RRichard67/amulet_controller_kibot/Images/amulet_controller-angled_top.png

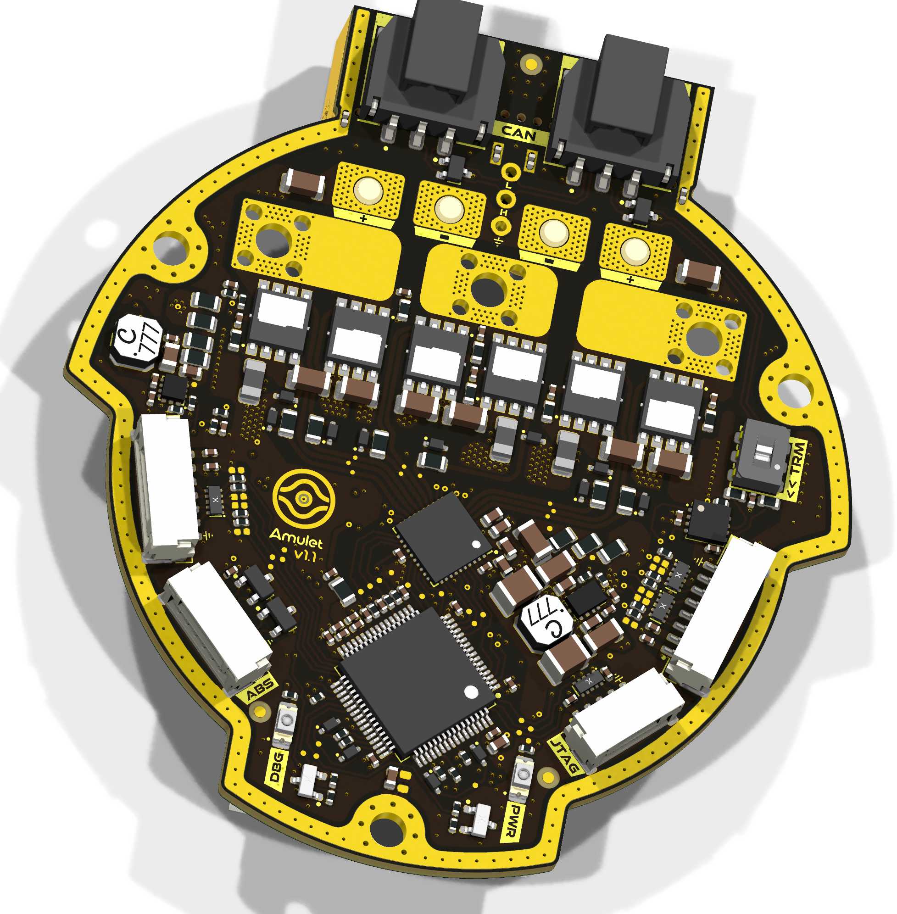
Images/amulet_controller-angled_top.png
