RRichard67/amulet_controller_kibot/Images/amulet_controller-bottom.png

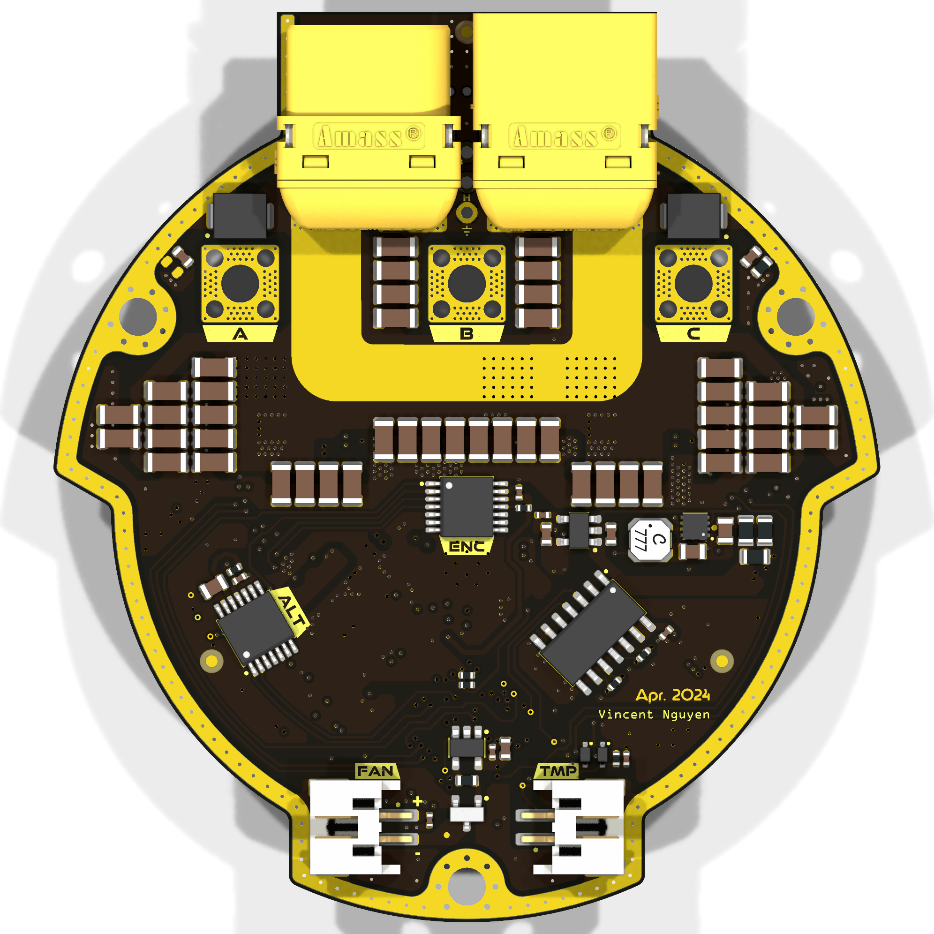
Images/amulet_controller-bottom.png
