RRichard67/amulet_controller_kibot/Reports/report_amulet_controller-erc.html

Logo

(https://github.com/INTI-CMNB/KiBot/) | ERC report for amulet_controller
| Schematic: amulet_controller Revision: 1.1.1+ (Unreleased) Date: 2026-08-17T11:32:27 KiCad Version: 10.0.5 | Errors: 0 Warnings: 3 Total: 3

Sheet / (amulet_controller.kicad_sch)

Type | Description | Details
lib_symbol_mismatch | Symbol 'Thermistor_NTC' doesn't match copy in library 'Device' | @(0.9779 mm, 0.8255 mm): Symbol TH1 [Thermistor_NTC]
lib_symbol_mismatch | Symbol 'LED' doesn't match copy in library 'Device' | @(1.4986 mm, 0.8128 mm): Symbol D12 [LED]
lib_symbol_mismatch | Symbol 'LED' doesn't match copy in library 'Device' | @(1.9812 mm, 0.8128 mm): Symbol D13 [LED]

Generated by KiBot (https://github.com/INTI-CMNB/KiBot/) v1.9.2
