RRichard67/amulet_controller_kibot/Schematic/amulet_controller-schematic-18.pdf

1 | 2 | 3 | 4 | 5 | 6 | 7 | 8

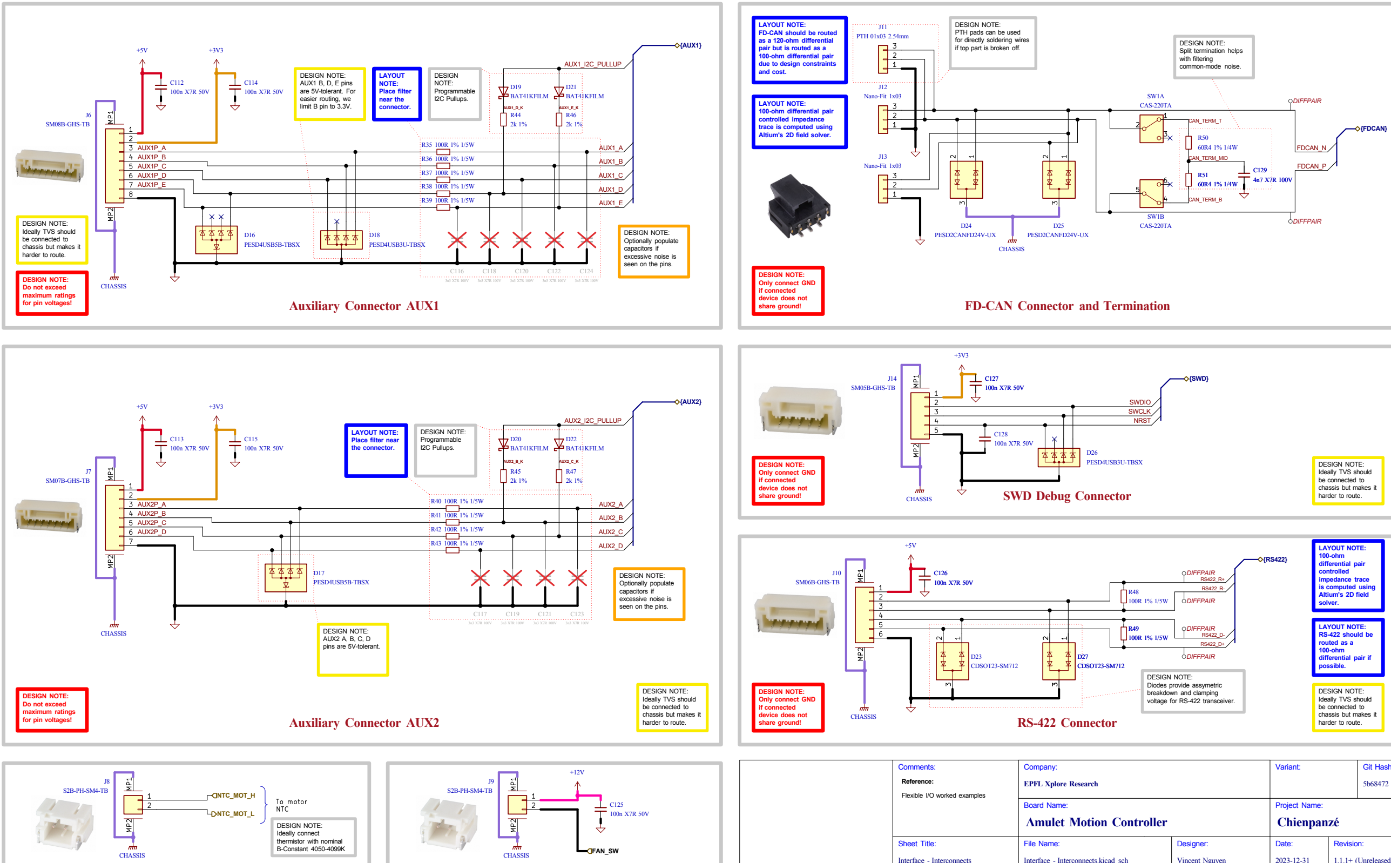
[picture p3: figure]
Sheet Title:; File Name:; D20 BAT41KFILM; 3n3 X7R 100V D22 BAT41KFILM; J6 SM08B-GHS-TB; D18 PESD4USB3U-TBSX; D19 BAT41KFILM; J12 Nano-Fit 1x03 1; J13 Nano-Fit 1x03 R44 2k 1%; D16 PESD4USB5B-TBSX; D21 BAT41KFILM; J11 PTH 01x03 2.54mm; J7 SM07B-GHS-TB; CHASSIS; 1 D24 PESD2CANFD24V-UX; 3 D27 CDSOT23-SM712; SW1A CAS-220TA; 1 D25 PESD2CANFD24V-UX; +3V3 CHASSIS; SW1B CAS-220TA; D17 PESD4USB5B-TBSX; 3 D23 CDSOT23-SM712 C126 100n X7R 50V; J14 SM05B-GHS-TB; D26 PESD4USB3U-TBSX; J10 SM06B-GHS-TB; DIFFPAIR; {FDCAN}; {SWD}; NTC_MOT_H; NTC_MOT_L; {AUX1}; FAN_SW; {AUX2} AUX2_B_K; AUX1_D; AUX2_C_K; FDCAN_P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
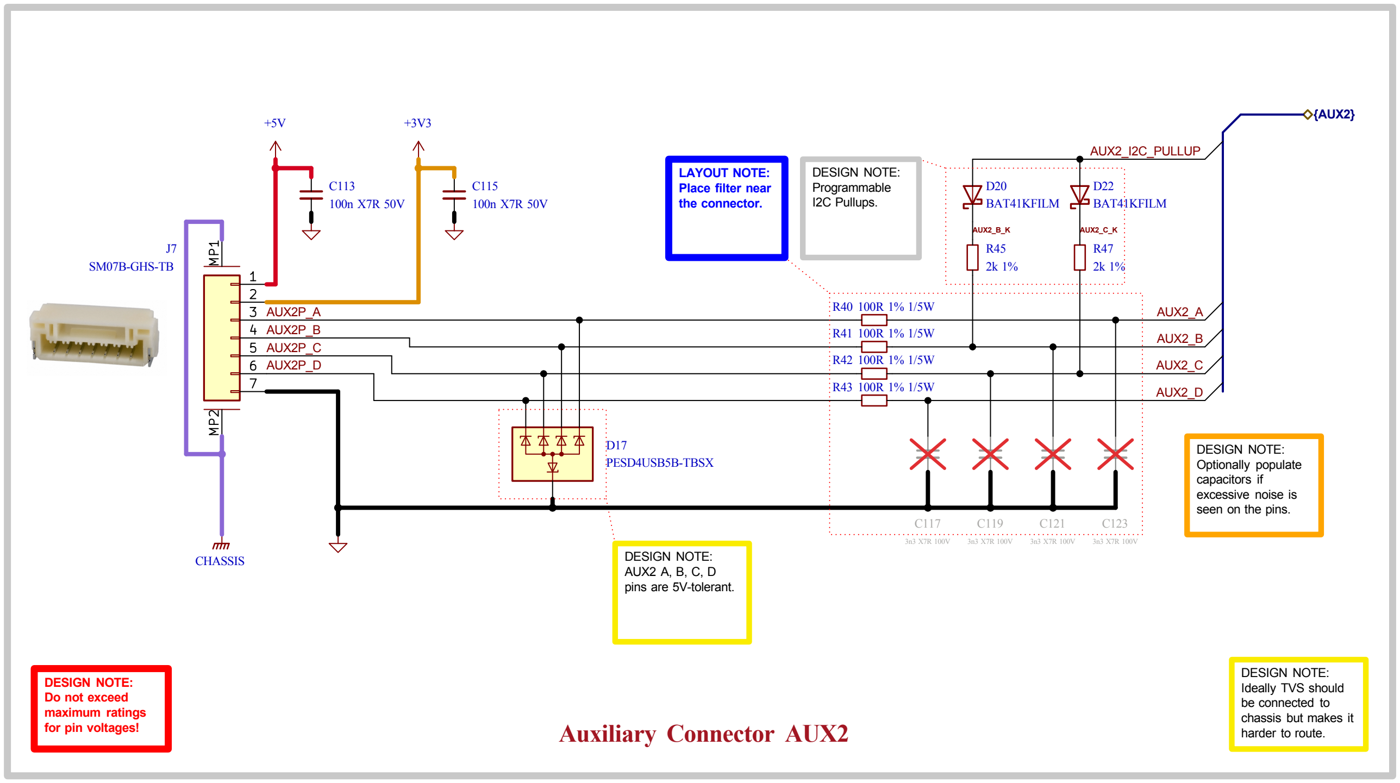
[picture p4: figure]
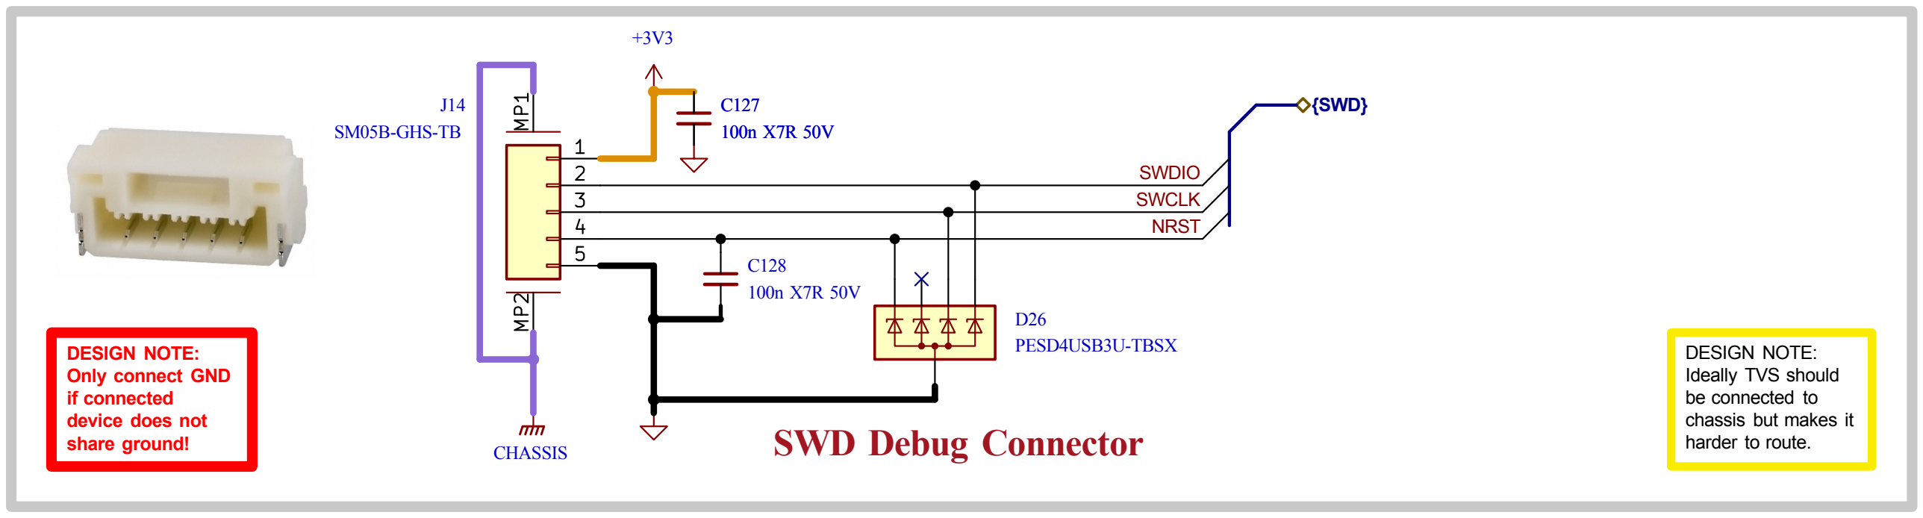
[picture p5: figure]

1 | 2 | 3 | 4 | 5 | 6 | 7 | 8

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
F 18

### Sheet: of 21 Size: A3

Revision: 1.1.1+ (Unreleased) Date: Project Name: 2023-12-31 Reviewer: Designer: Interface - Interconnects.kicad_sch | Vincent Nguyen Board Name: Company: | Variant: EPFL Xplore Research Λmulet Motion Controller | Chienpanzé
/Project Architecture/Interface - Interconnects/ Sheet Path: Interface - Interconnects Comments: | Git Hash: 5b68472 R42 100R 1% 1/5W

I2C Pullups. DESIGN NOTE: AUX1 B, D, E pins are 5V-tolerant. For easier routing, we
limit B pin to 3.3V. | LAYOUT NOTE: Place filter near the
connector. | FD-CAN Connector and Termination

DESIGN NOTE: Split termination helps with filtering

common-mode noise. DESIGN NOTE: Only connect GND

# device does not share ground! LAYOUT NOTE: 100-ohm differential pair controlled impedance

trace is computed using Altium's 2D field solver. | DESIGN NOTE: PTH pads can be used

if top part is broken off. DESIGN NOTE: Programmable

# 12V Fan Connector

differential pair if possible. DESIGN NOTE:

# chassis but makes it harder to route. LAYOUT NOTE: 100-ohm

solver. DESIGN NOTE: Diodes provide assymetric breakdown and clamping

voltage for RS-422 transceiver. DESIGN NOTE: Only connect GND chassis but makes it harder to route. DESIGN NOTE: Only connect GND

device does not share ground! DESIGN NOTE: Do not exceed maximum ratings

for pin voltages! | To motor NTC Motor Temperature Sensing Thermistor Connection

# [18] Interface - Interconnects

as a 120-ohm differential pair but is routed as a

100-ohm differential pair due to design constraints

DESIGN NOTE: Do not exceed maximum ratings

seen on the pins. LAYOUT NOTE: Place filter near

chassis but makes it harder to route. | DESIGN NOTE: Optionally populate

Flexible I/O worked examples (https://jpieper.com/2022/06/30/flexible-i-o-worked-examples/) Reference:C126
