RRichard67/amulet_controller_kibot/Schematic/amulet_controller-schematic-21.pdf

1 | 2 | 3 | 4 | 5 | 6
1 | 2 | 3 | 4 | 5 | 6

AB

C

D

AB

C

D 21

Sheet: of 21
Size: A4
Revision: 1.1.1+ (Unreleased) Date: Project Name: 2024-01-03 Reviewer: Designer: Revision History.kicad_sch | Vincent Nguyen Board Name: Company: | Variant: EPFL Xplore Research Λmulet Motion Controller | Chienpanzé
Sheet Title: | File Name:
/Revision History/ Sheet Path: Revision History Comments: | Git Hash: 5b68472

Version 1.0.0 - 2023-12-12 ___________________________________ Added

- TVS protection and termination switch to FD-CAN. - Low-side switched 12V 600 mA source for

external fan. - LDO for analog supply. - One TVS diode per power connector. - Second on-board I2C magnetic encoder for

disambiguation. - ESD protection to all interfaces. - Over-voltage protection on thermistor ADC

inputs. - Pi filters to inputs of buck regulators and

MCU analog supply. - Decoupling caps next to power pins of

connectors. ___________________________________ Changed

- CPH-CPL capacitor to 47 nF (gate driver). - FD-CAN transceiver IC. - FETs for top cooled variant. - Input power TVS diode to bidirectional. - Moved SOx low-pass filter to MCU section. - PWM_PHASEA with PWM_PHASEC on STM32G474 pinout for easier routing. - RS422 pinout on connector. - Buck regulators to optimize for low noise.

___________________________________ Added

- Controller target specifications. - Credits to moteus on cover page. - Optional RC-Snubber to power stage. ___________________________________ Fixed
- Chassis guard ring to go around the board. - CAN and power TVS diodes now go to

chassis. - Clearance between nets to respect

IEC60664-1 where possible. - Comment on precharge. - Power TVS diode reference designator

from "U" to "D". ___________________________________ Changed

- 5V 300 mA buck converter with 600 mA version. - Chassis-GND capacitor by 1nF 1kV.

Version 1.0.1 - 2024-01-25 ___________________________________ Changed

- Power sequencing graph according to
experimental data. | ___________________________________ Added
- RC snubber passive values. ___________________________________ Fixed
- More vias for VBUS and LMR36006 GND pads. - Board version voltage reference from +3V3

to +A3V3. ___________________________________ Changed

- Motor thermistor resistor divider to 2kOhm for a 10k 3950K thermistor.

# [21] Revision History

Version 1.0.2 - 2024-03-12

___________________________________ Fixed

- Replace non-stocked components.

Version 1.1.1 - 2025-01-18

Version 1.1.0 - 2024-04-13
