RRichard67/amulet_controller_kibot/Images/amulet_controller-top.png

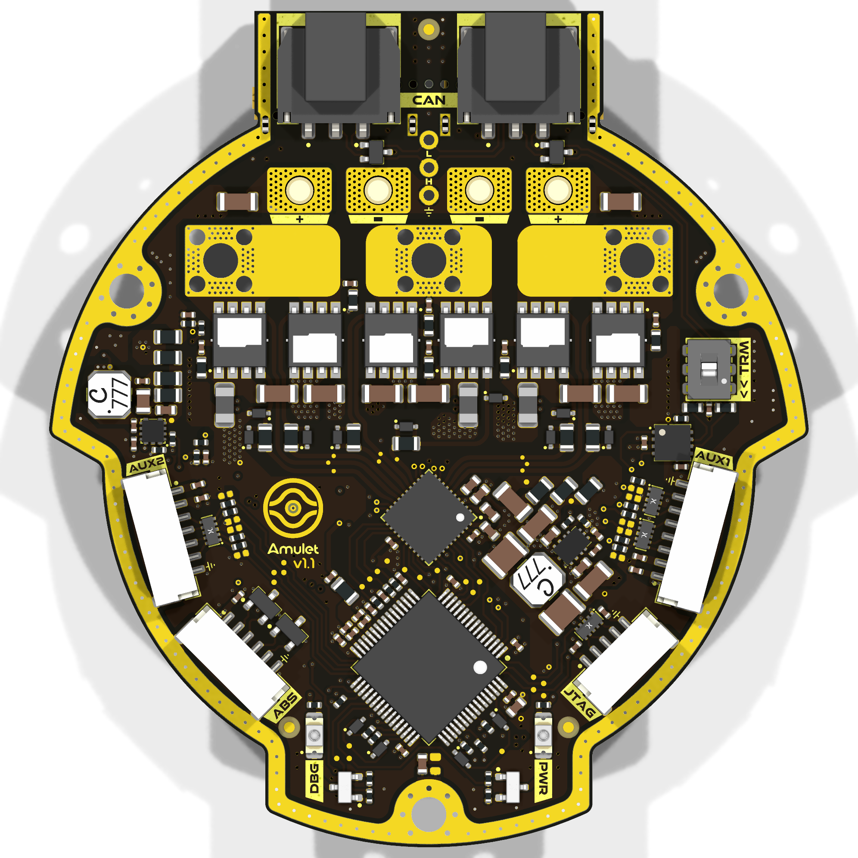
Images/amulet_controller-top.png
