RRichard67/amulet_controller_kibot/3D/amulet_controller.step

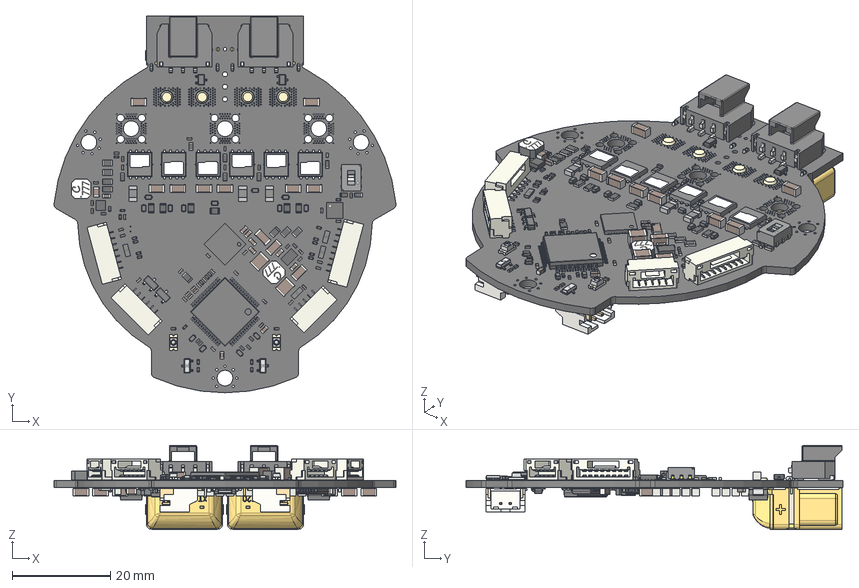
[picture p8: CAD file, 2026-08-17]
3D/amulet_controller.step
69.7 x 76.7 x 17.1 mm
C_1210_3225Metric x 2
C_0402_1005Metric x 45
TPW1R306PL,L1Q x 6
R_0402_1005Metric x 40
C_0603_1608Metric x 14
SOT23 lower body x 3
SOT23 Lead x 9
SOT23 Upper body x 3
R_0805_2012Metric x 17
VSON_8_33x33mm_Pitch065mm_NexFET
R_0603_1608Metric x 10
PCB x 29
lead x 30
SOT1176D LF x 4
SOT1176D Mold body x 4
1054301103 v4 x 2
SM1206XXC-IL x 2
C_1206_3216Metric x 57
HCS1206_L500 x 3
C_0805_2012Metric x 4
Leader x 128
BODY-QFN_AF0
PIN1-ID
JST_SM06B_GHS_TB
MOLD_AF0
JST_SM08B_GHS_TB
Coilcraft-LPS4018 x 2
JST_SM05B_GHS_TB
Thermal Shape x 2
JST_SM07B_GHS_TB
2 pole_s
CAS_c_22A
S3B-PH-SM4-TB v8 x 2
Lead x 4
Coilcraft-LPS3314
XT60____-8______-UL-21155
XT60____-8____-21158 x 2
XT60PW-F20____-8-UL
XT60____-8________ x 4
XT60____-8______-UL-21156
XT60____-8____-21157 x 2
XT60PW-M20____-8-UL
XT60-PW-F
kibot_5xyicq26_PCB
