RRichard67/amulet_controller_kibot/Manufacturing/Fabrication/Gerbers/amulet_controller-NPTH_drill_map.dxf

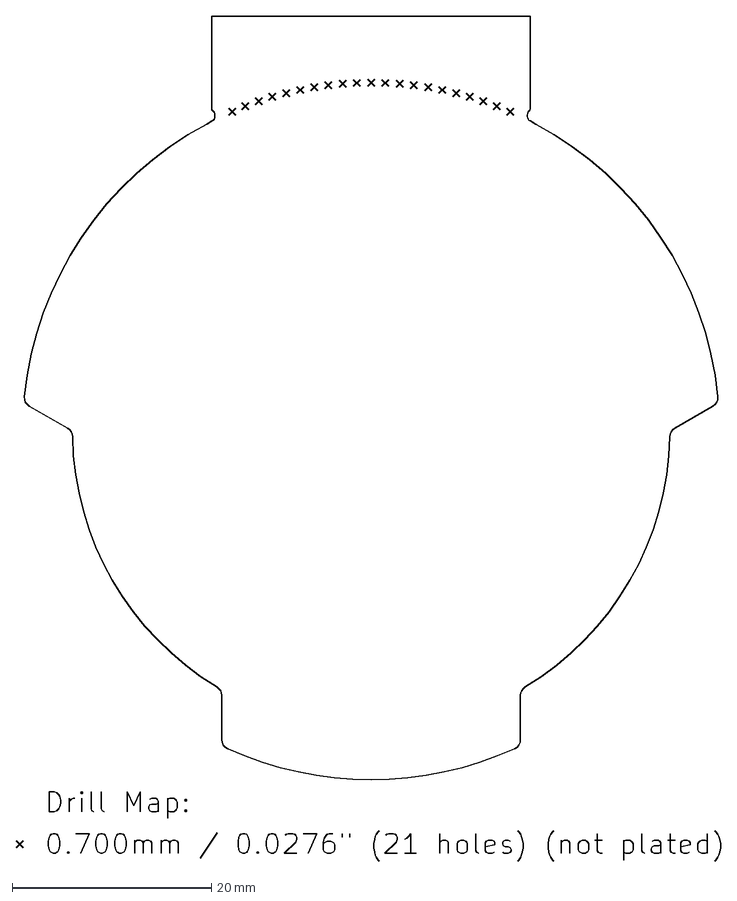
[picture p9: CAD file, 2026-08-17]
Manufacturing/Fabrication/Gerbers/amulet_controller-NPTH_drill_map.dxf
70.7 x 84.9 mm
