RRichard67/amulet_controller_kibot/Manufacturing/Fabrication/Gerbers/amulet_controller-PTH_drill_map.dxf

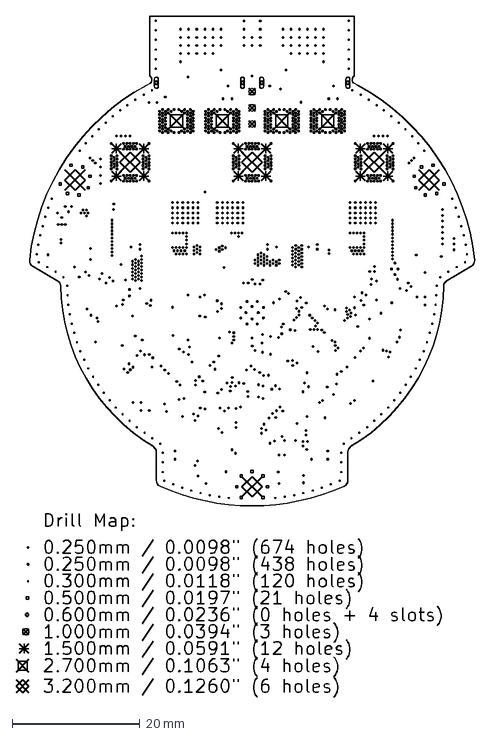
[picture p10: CAD file, 2026-08-17]
Manufacturing/Fabrication/Gerbers/amulet_controller-PTH_drill_map.dxf
71.8 x 106.6 mm
