RRichard67/amulet_controller_kibot/Manufacturing/Fabrication/amulet_controller-fabrication.pdf

# Top Fabrication (Scale 1:1)

# Λmulet Motion Controller Fabrication Document

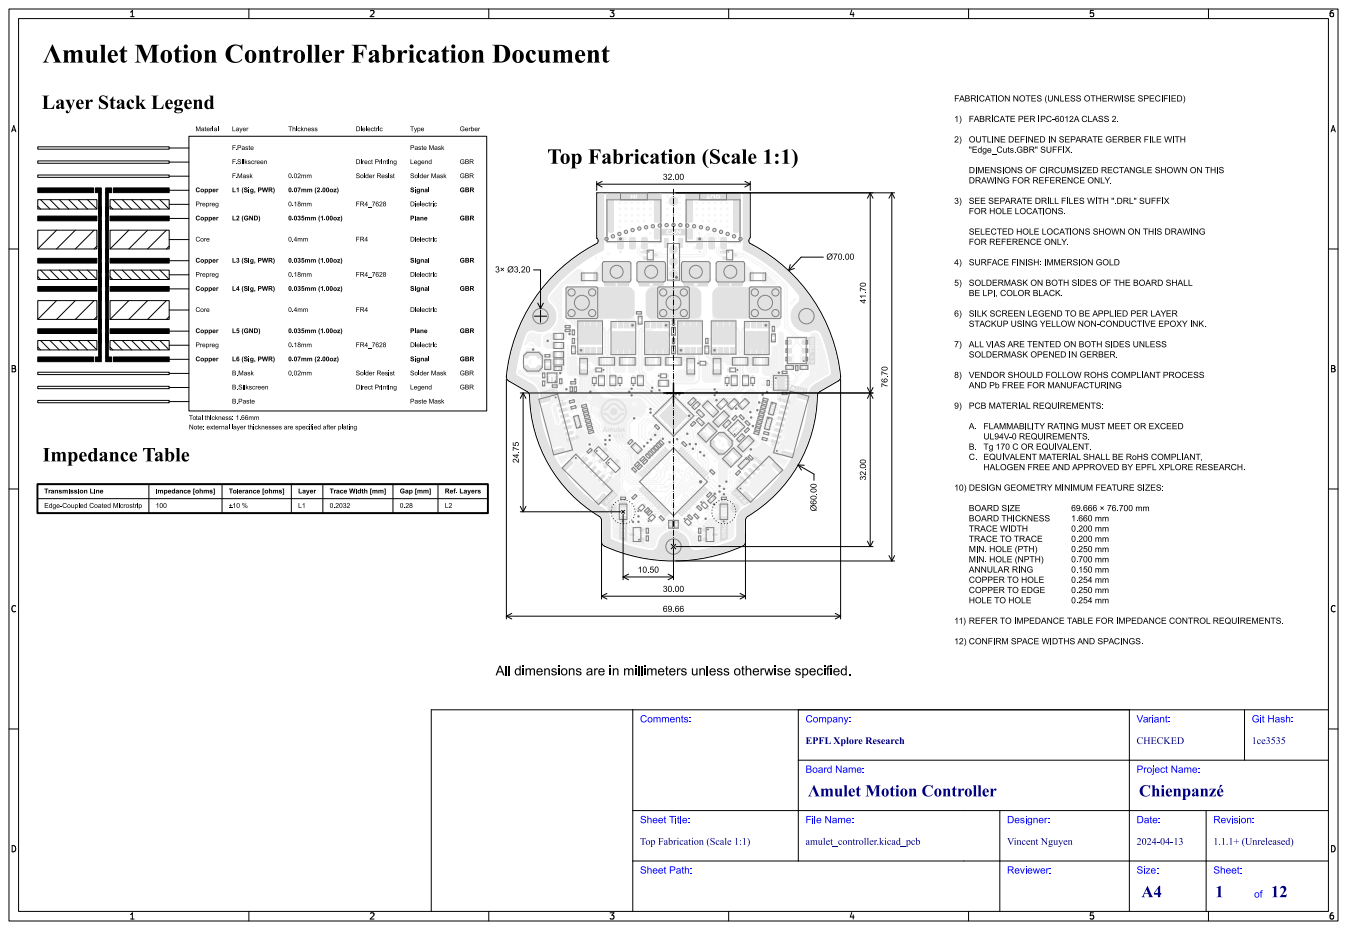
[picture p11: page 1]
Git Hash:; Comments:; Sheet Path:; Sheet Title:; File Name:; Λmulet Motion Controller; Chienpanzé; Company:; CHECKED; Variant:; Board Name:; amulet_controller.kicad_pcb; Vincent Nguyen; Designer:; Reviewer:; Project Name:; Date:; 1.1.1+ (Unreleased); Revision:; Size:; Sheet:

EPFL Xplore Research

Top Fabrication (Scale 1:1)

# Bottom Fabrication (Scale 1:1)

# Λmulet Motion Controller Fabrication Document

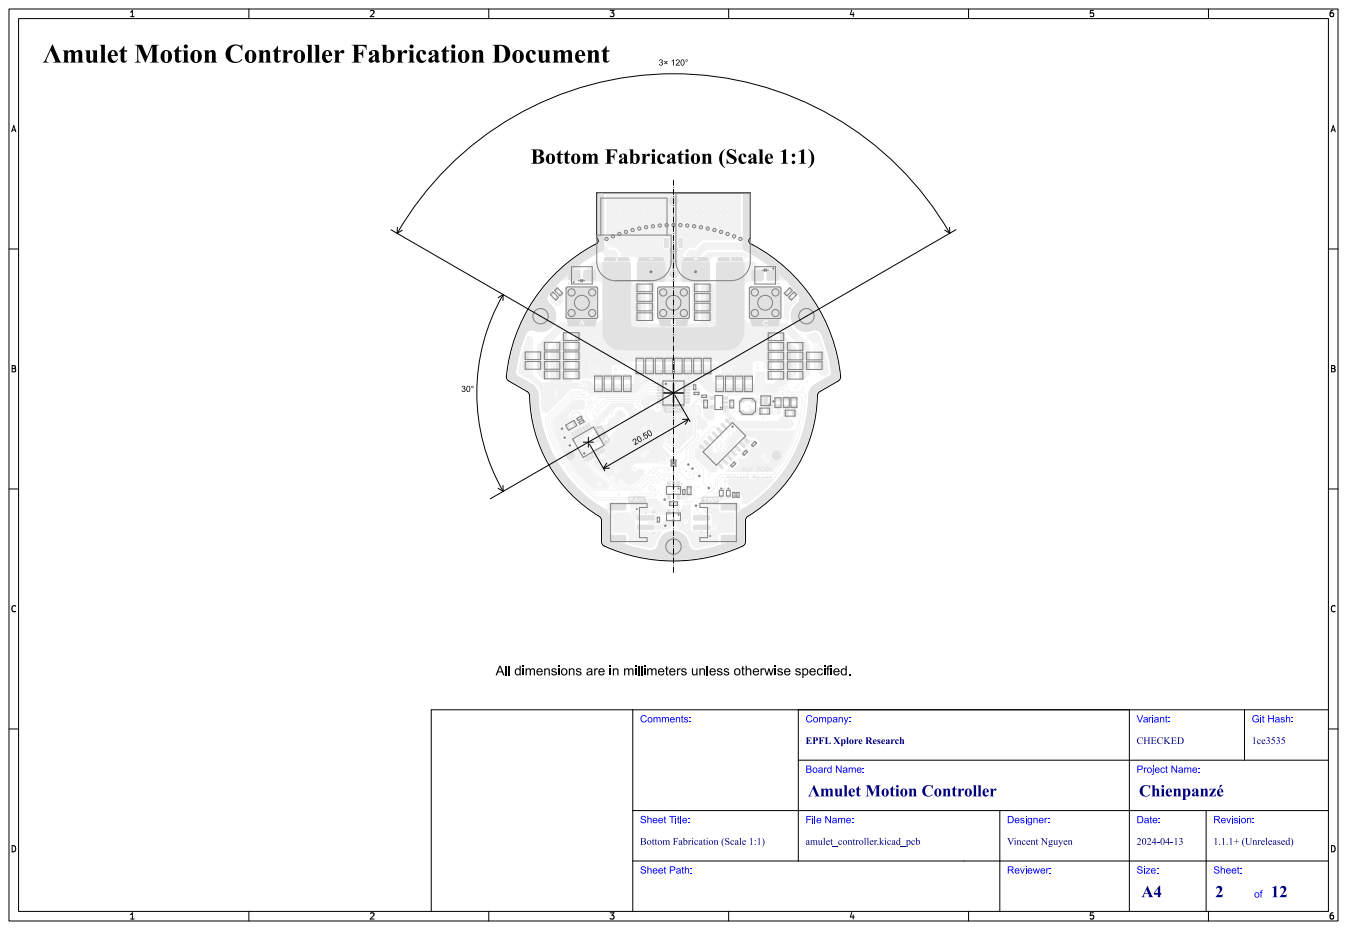
[picture p12: page 2]
Git; Hash:; Comments:; Sheet Path:; Sheet Title:; File Name:; Λmulet Motion Controller; Chienpanzé; Company:; CHECKED; Variant:; Board Name:; amulet_controller.kicad_pcb; Vincent Nguyen; Designer:; Reviewer:; Project Name:; Date:; 1.1.1+ (Unreleased); Revision:; Size:; Sheet:

EPFL Xplore Research

Bottom Fabrication (Scale 1:1)

# Drill Drawing L1 - L6 (Scale 1:1)

# Λmulet Motion Controller Fabrication Document

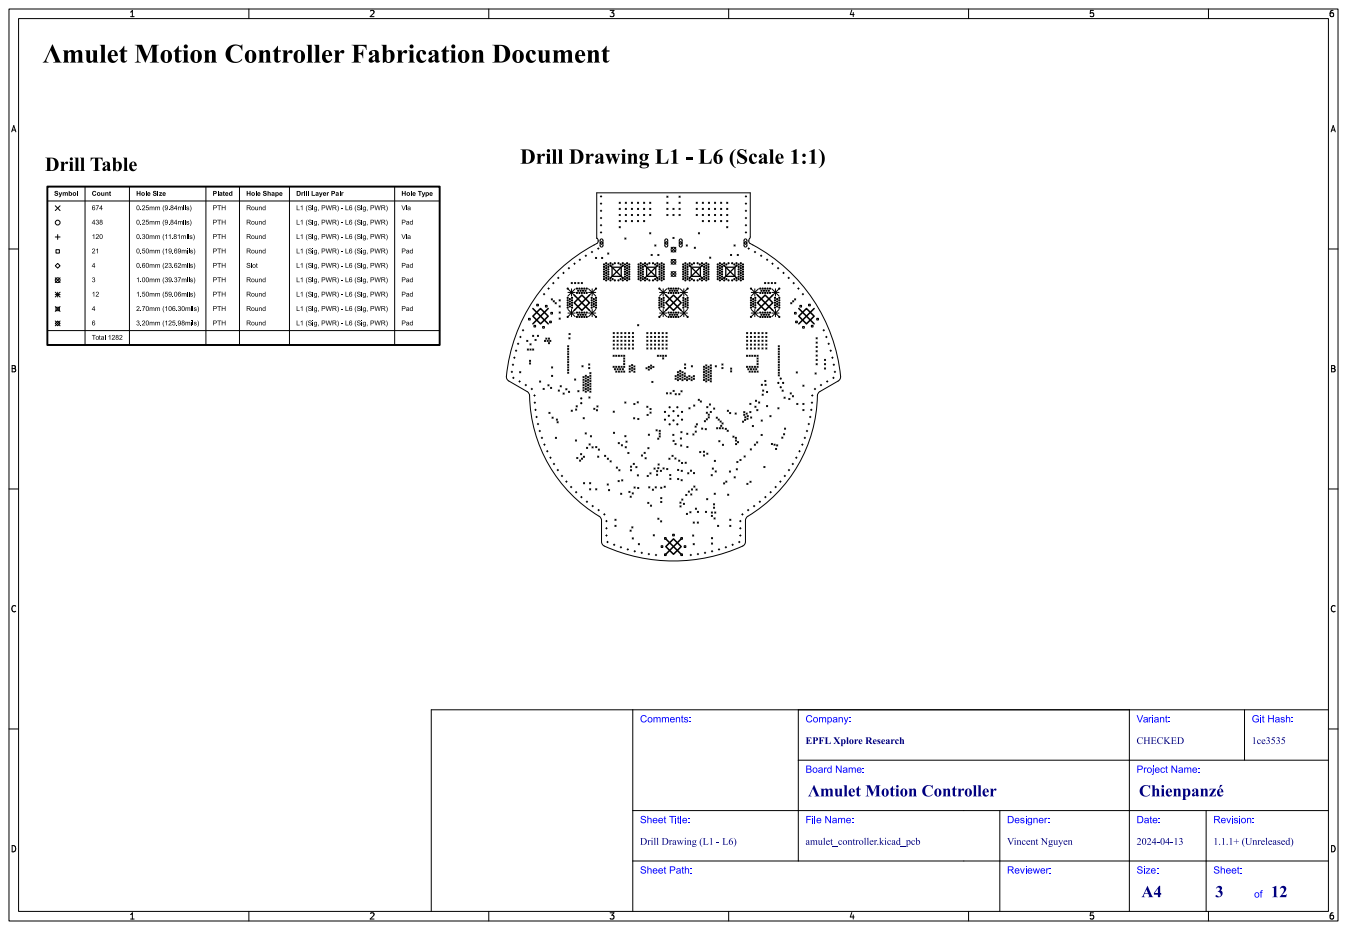
[picture p13: page 3]
Git; Hash:; Comments:; Drill Drawing (L1 - L6); Sheet Path:; Sheet Title:; File Name:; Λmulet Motion Controller; Chienpanzé; Company:; CHECKED; Variant:; Board Name:; amulet_controller.kicad_pcb; Vincent Nguyen; Designer:; Reviewer:; Project Name:; Date:; 1.1.1+ (Unreleased); Revision:; Size:; Sheet:

EPFL Xplore Research

# Drill Drawing L1 - L6 (Scale 1:1)

# Λmulet Motion Controller Fabrication Document

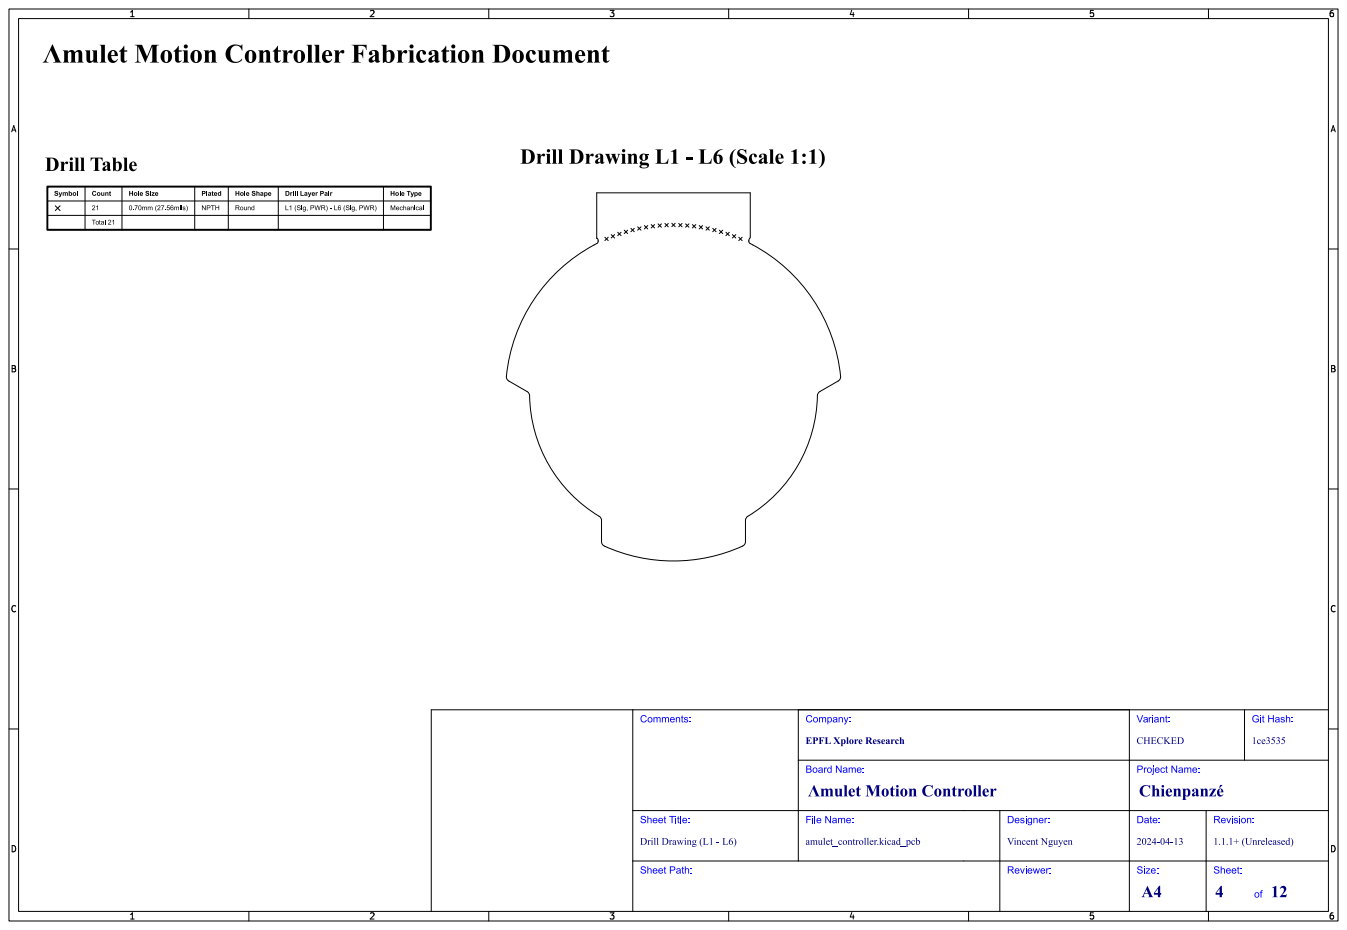
[picture p14: page 4]
Git; Hash:; Comments:; Drill Drawing (L1 - L6); Sheet Path:; Sheet Title:; File Name:; Λmulet Motion Controller; Chienpanzé; Company:; CHECKED; Variant:; Board Name:; amulet_controller.kicad_pcb; Vincent Nguyen; Designer:; Reviewer:; Project Name:; Date:; 1.1.1+ (Unreleased); Revision:; Size:; Sheet:

EPFL Xplore Research

# Top Test Points (Scale 1:1)

# Λmulet Motion Controller Fabrication Document

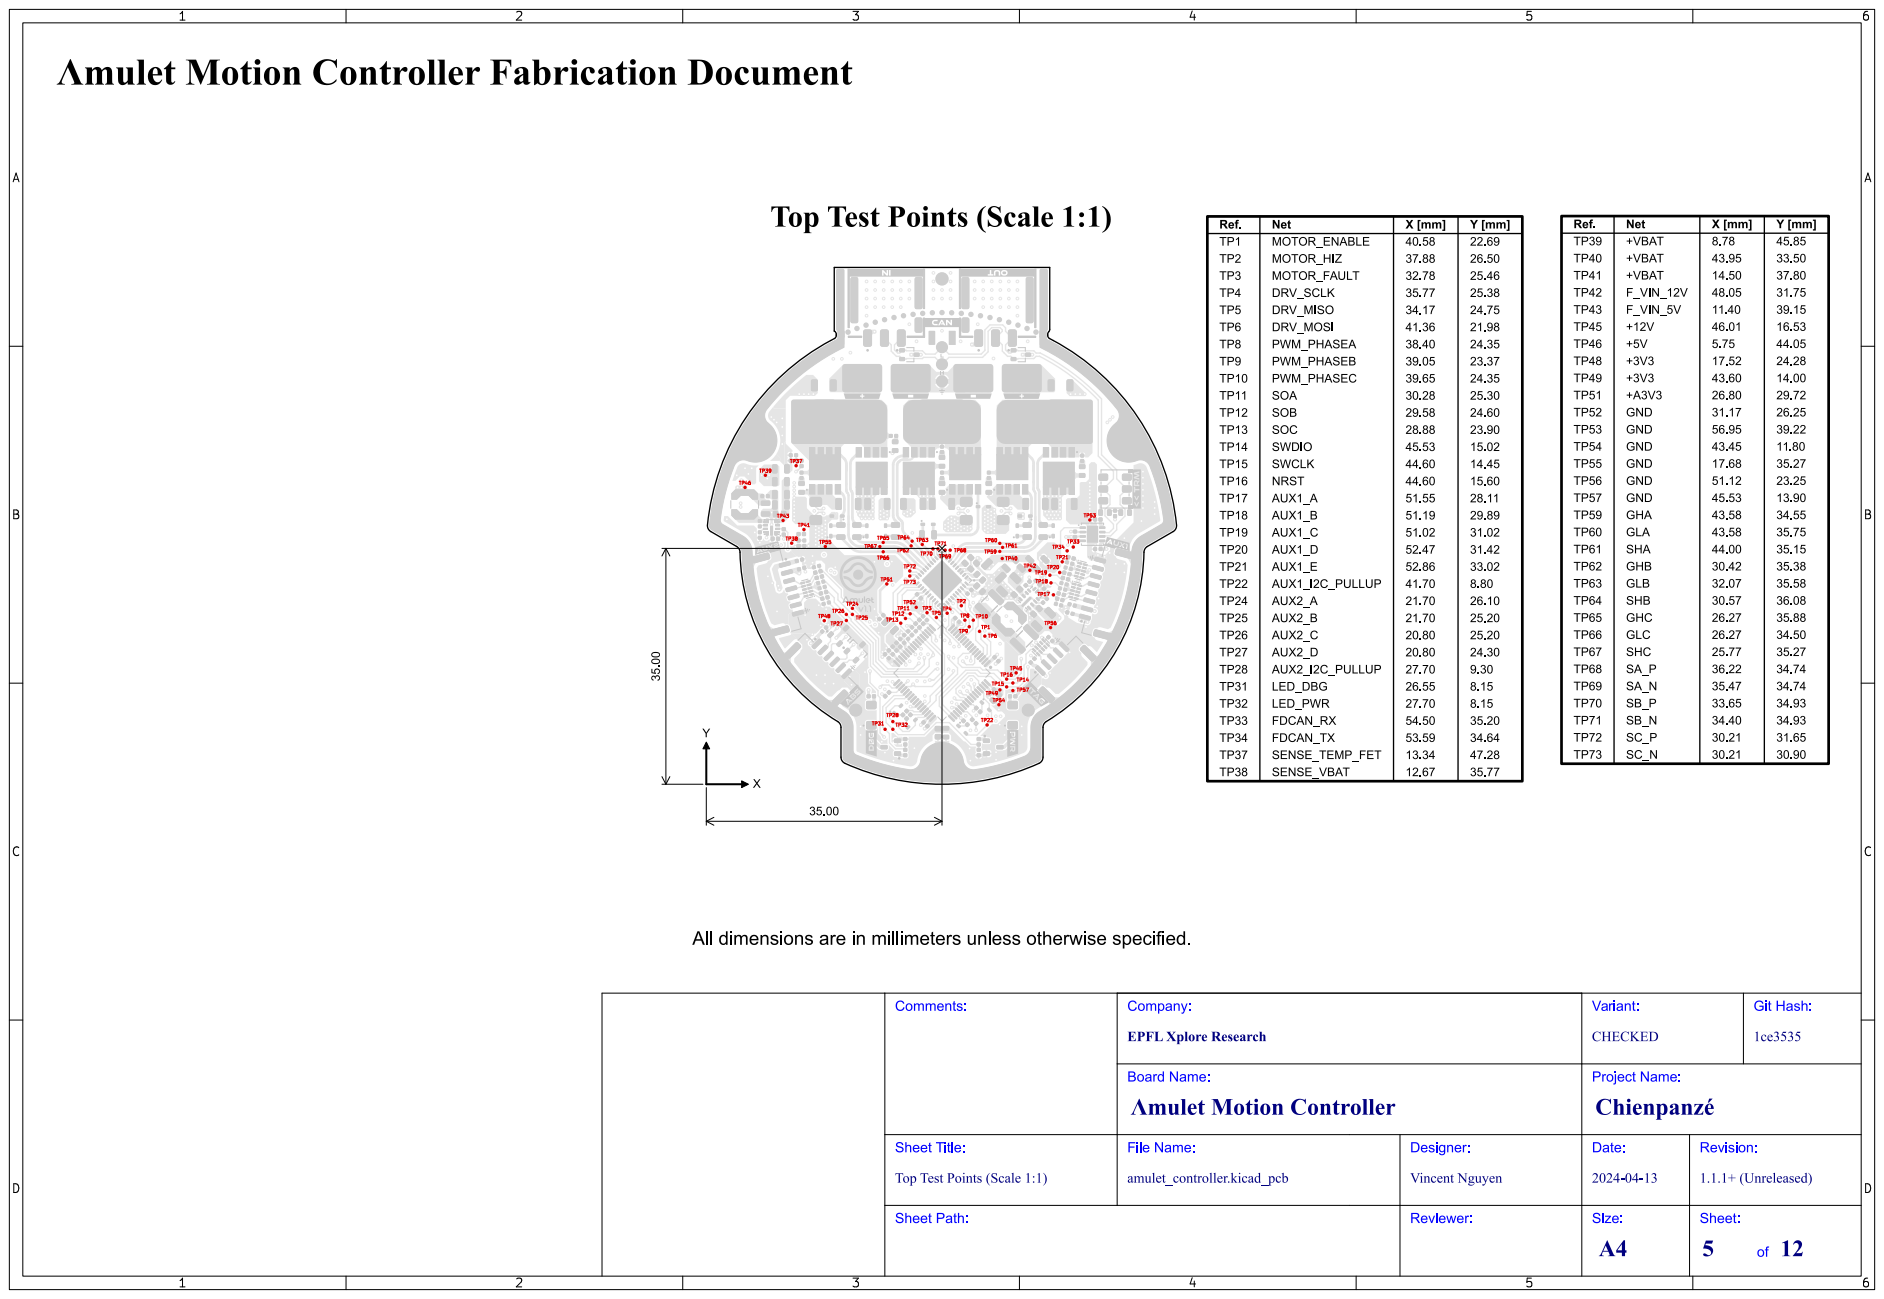
[picture p15: page 5]

Top Test Points (Scale 1:1)

# Bottom Test Points (Scale 1:1)

# Λmulet Motion Controller Fabrication Document

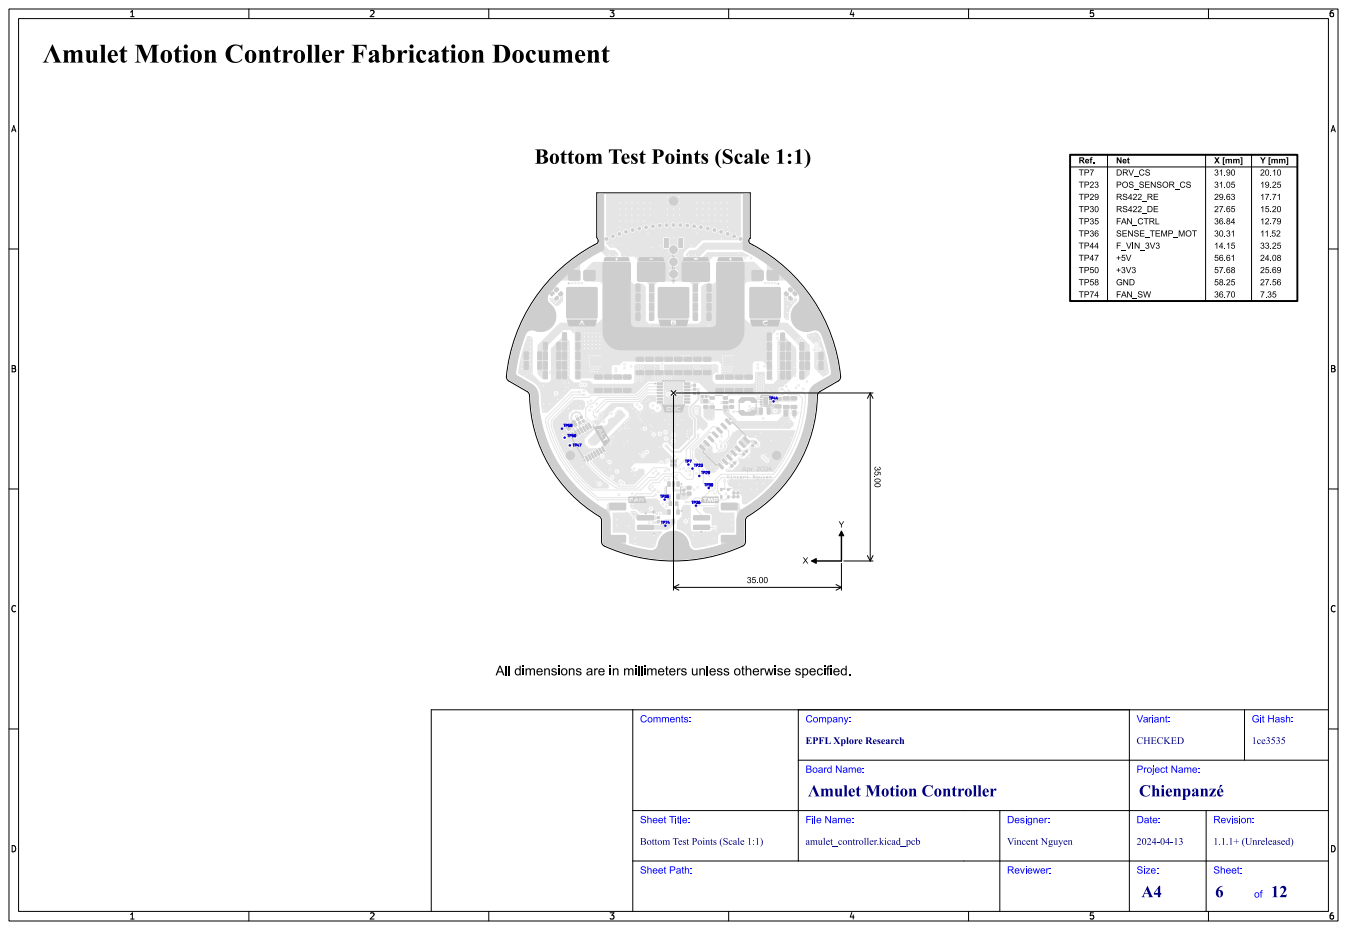
[picture p16: page 6]

Bottom Test Points (Scale 1:1)

# L1 (Sig, PWR) (Scale 1:1)

# Λmulet Motion Controller Fabrication Document

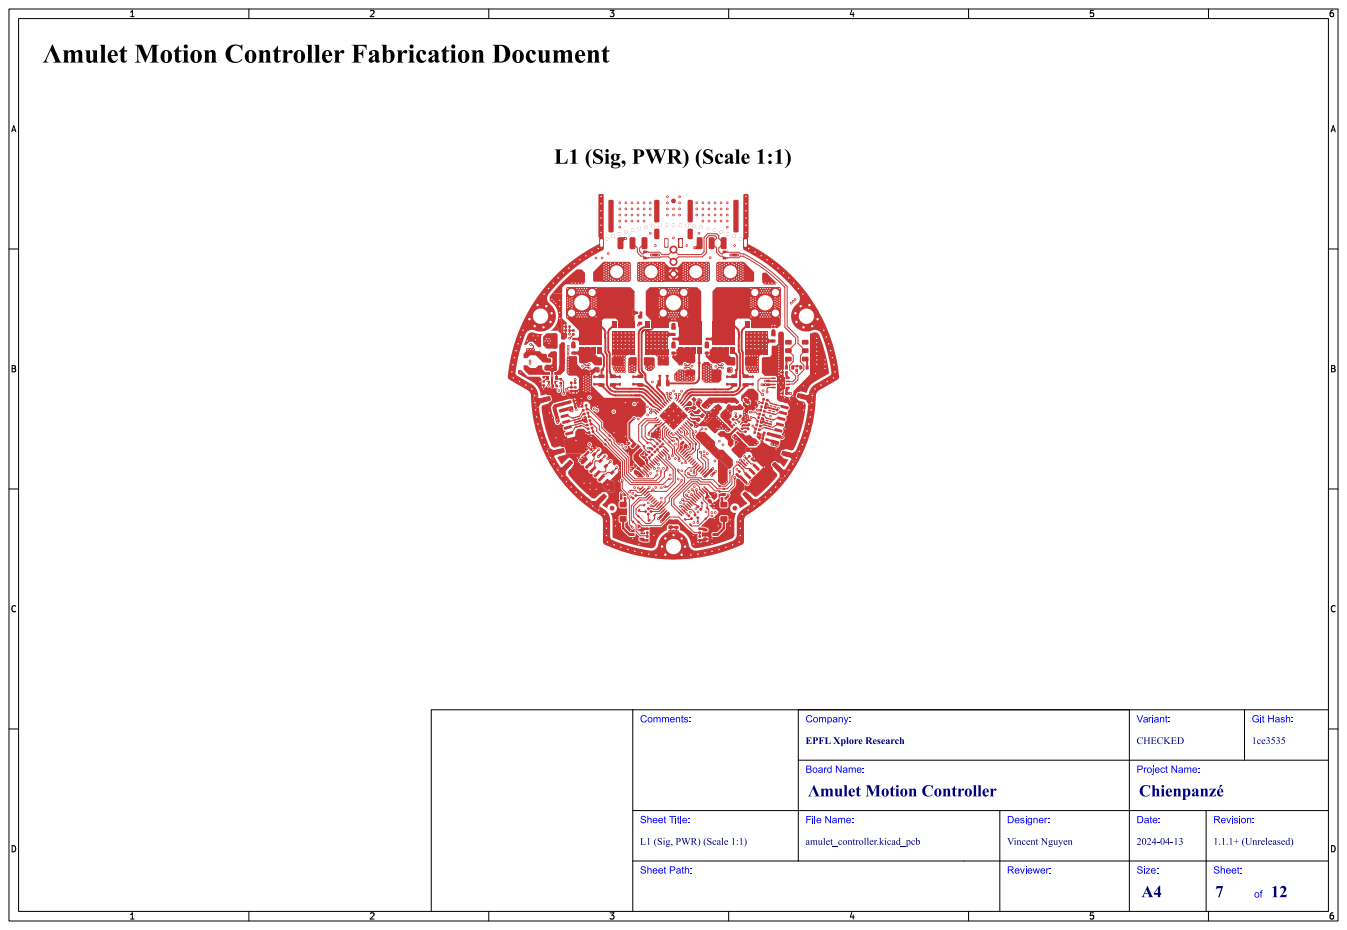
[picture p17: page 7]
Git; Hash:; Comments:; Sheet Path:; Sheet Title:; File Name:; Λmulet Motion Controller; Chienpanzé; Company:; CHECKED; Variant:; Board Name:; amulet_controller.kicad_pcb; Vincent Nguyen; Designer:; Reviewer:; Project Name:; Date:; 1.1.1+ (Unreleased); Revision:; Size:; Sheet:

EPFL Xplore Research

L1 (Sig, PWR) (Scale 1:1)

# L2 (GND) (Scale 1:1)

# Λmulet Motion Controller Fabrication Document

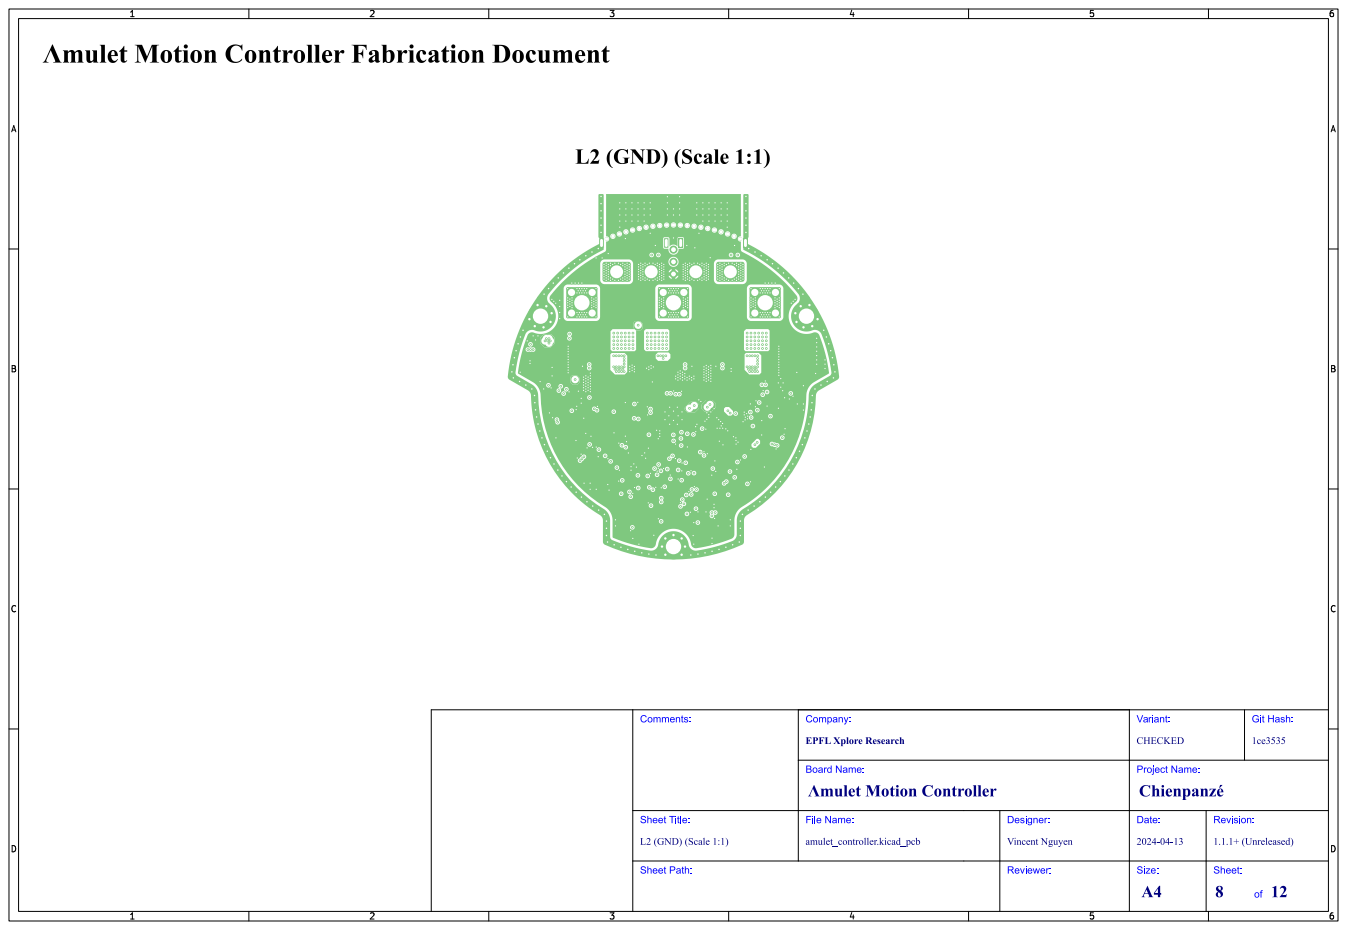
[picture p18: page 8]
Git; Hash:; Comments:; L2 (GND) (Scale 1:1); Sheet Path:; Sheet Title:; File Name:; Λmulet Motion Controller; Chienpanzé; Company:; CHECKED; Variant:; Board Name:; amulet_controller.kicad_pcb; Vincent Nguyen; Designer:; Reviewer:; Project Name:; Date:; 1.1.1+ (Unreleased); Revision:; Size:; Sheet:

EPFL Xplore Research

# L3 (Sig, PWR) (Scale 1:1)

# Λmulet Motion Controller Fabrication Document

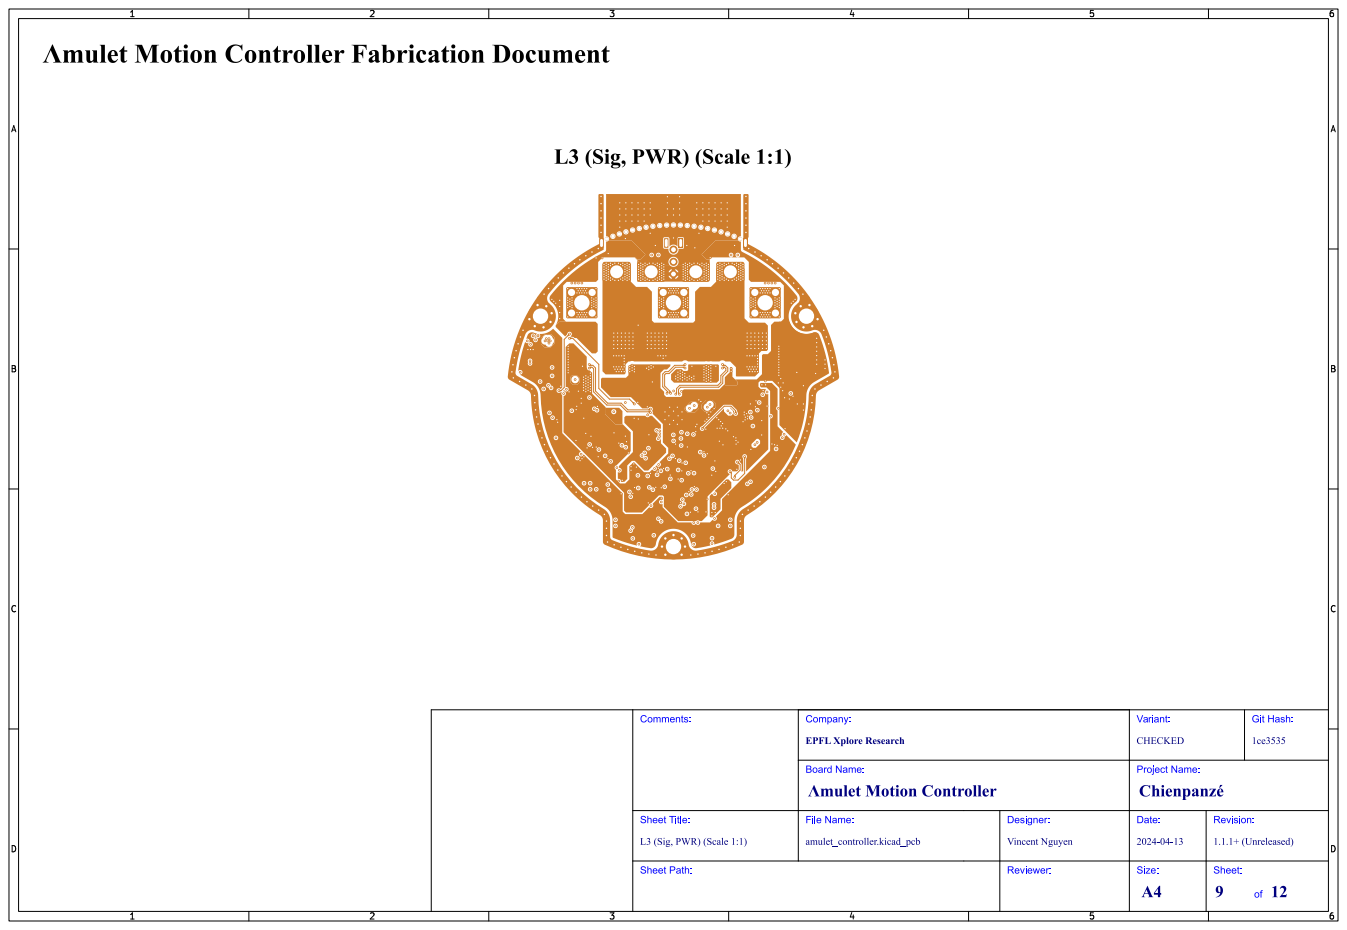
[picture p19: page 9]
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

EPFL Xplore Research

L3 (Sig, PWR) (Scale 1:1)

# L4 (Sig, PWR) (Scale 1:1)

# Λmulet Motion Controller Fabrication Document

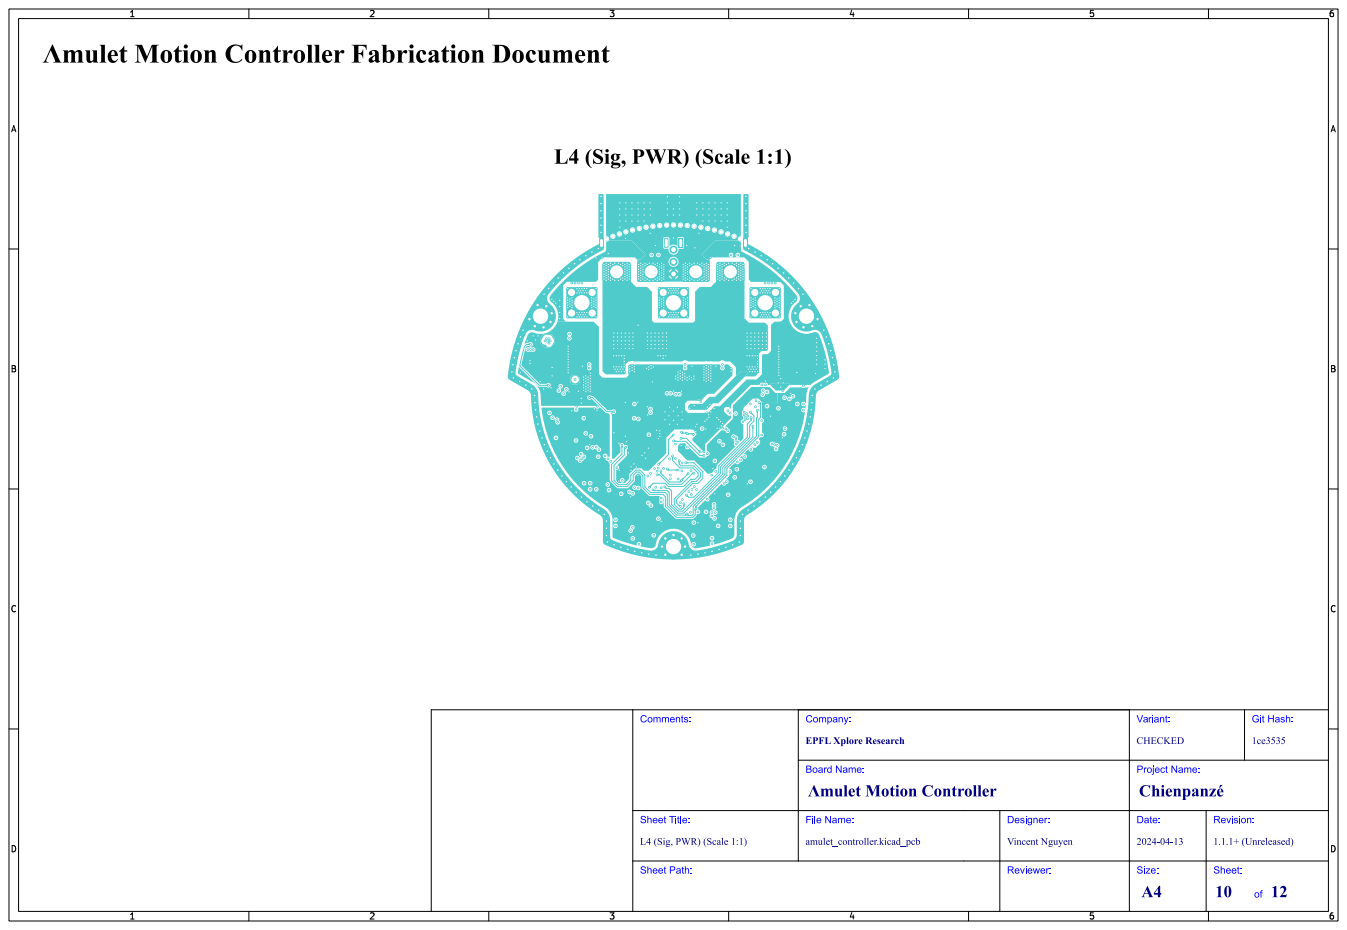
[picture p20: page 10]
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

EPFL Xplore Research

L4 (Sig, PWR) (Scale 1:1)

# L5 (GND) (Scale 1:1)

# Λmulet Motion Controller Fabrication Document

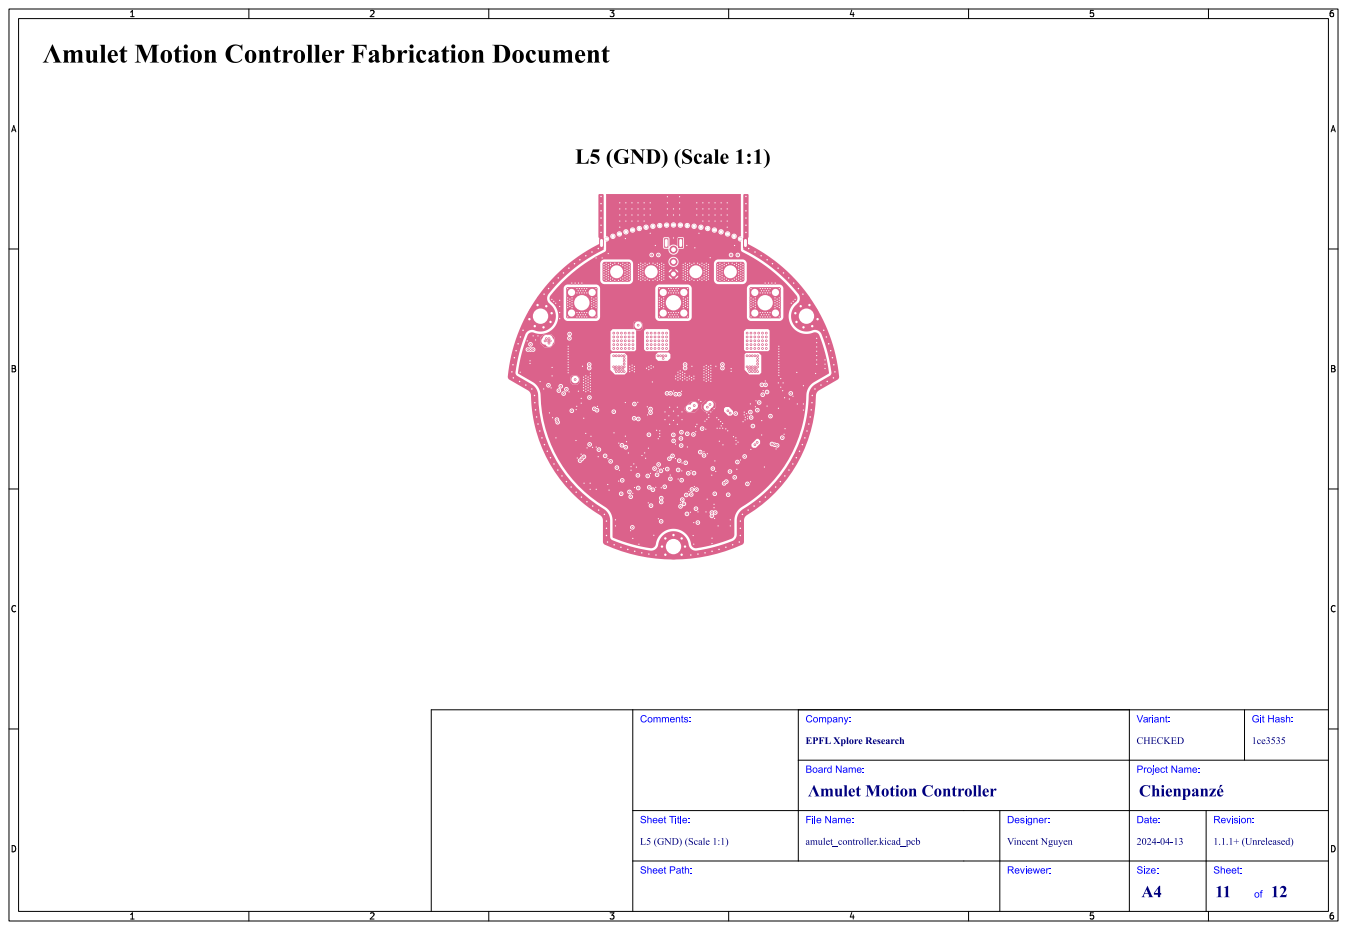
[picture p21: page 11]
Git; Hash:; Comments:; L5 (GND) (Scale 1:1); Sheet Path:; Sheet Title:; File Name:; Λmulet Motion Controller; Chienpanzé; Company:; CHECKED; Variant:; Board Name:; amulet_controller.kicad_pcb; Vincent Nguyen; Designer:; Reviewer:; Project Name:; Date:; 1.1.1+ (Unreleased); Revision:; Size:; Sheet:

EPFL Xplore Research

# L6 (Sig, PWR) (Scale 1:1)

# Λmulet Motion Controller Fabrication Document

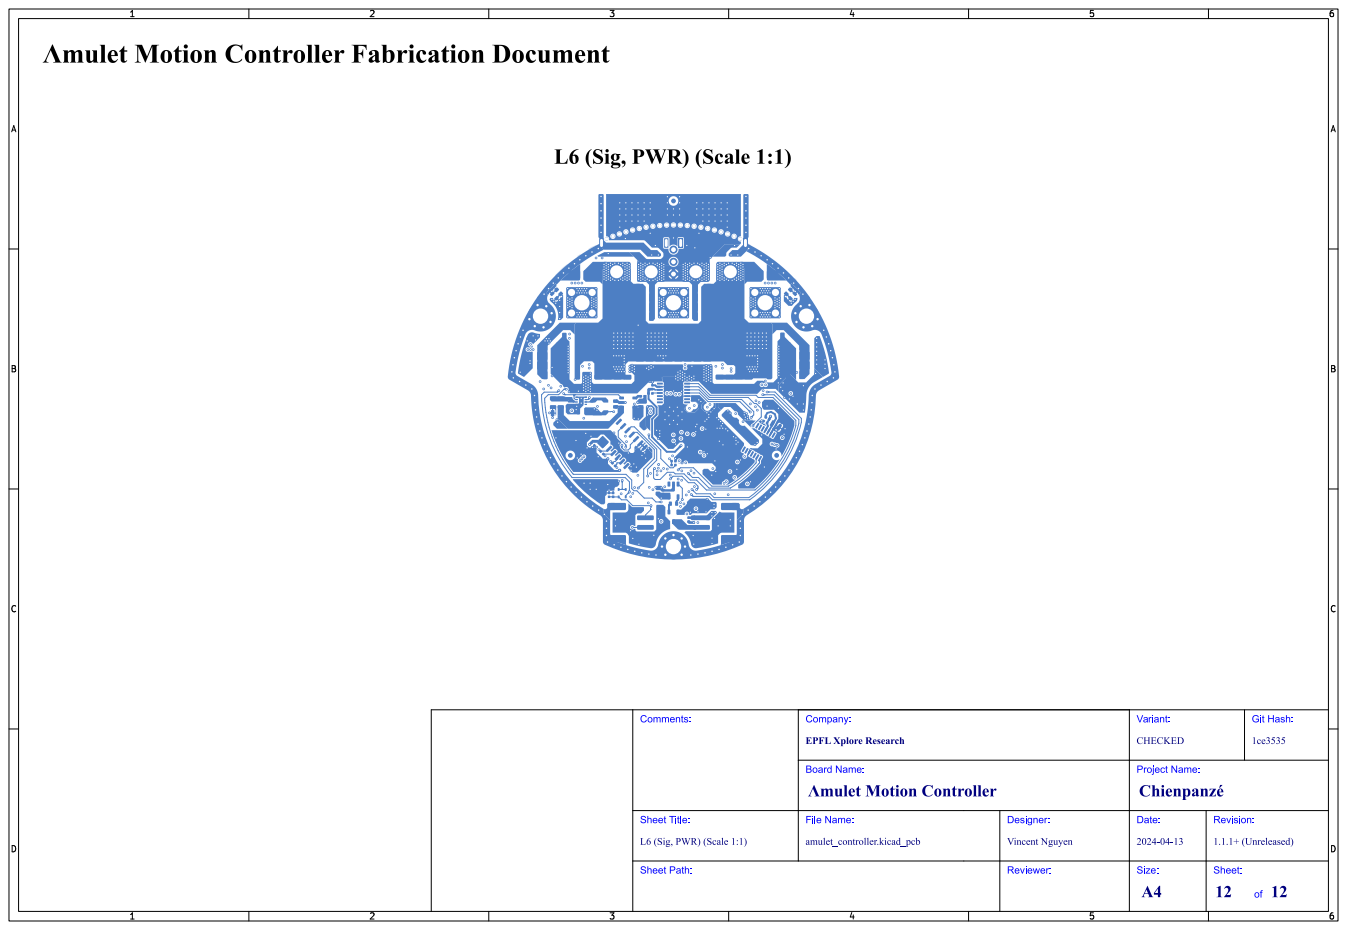
[picture p22: page 12]
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

EPFL Xplore Research

L6 (Sig, PWR) (Scale 1:1)
