RRichard67/amulet_controller_kibot/Schematic/amulet_controller-schematic-1.pdf

# Λmulet Motion Controller

# Variant:

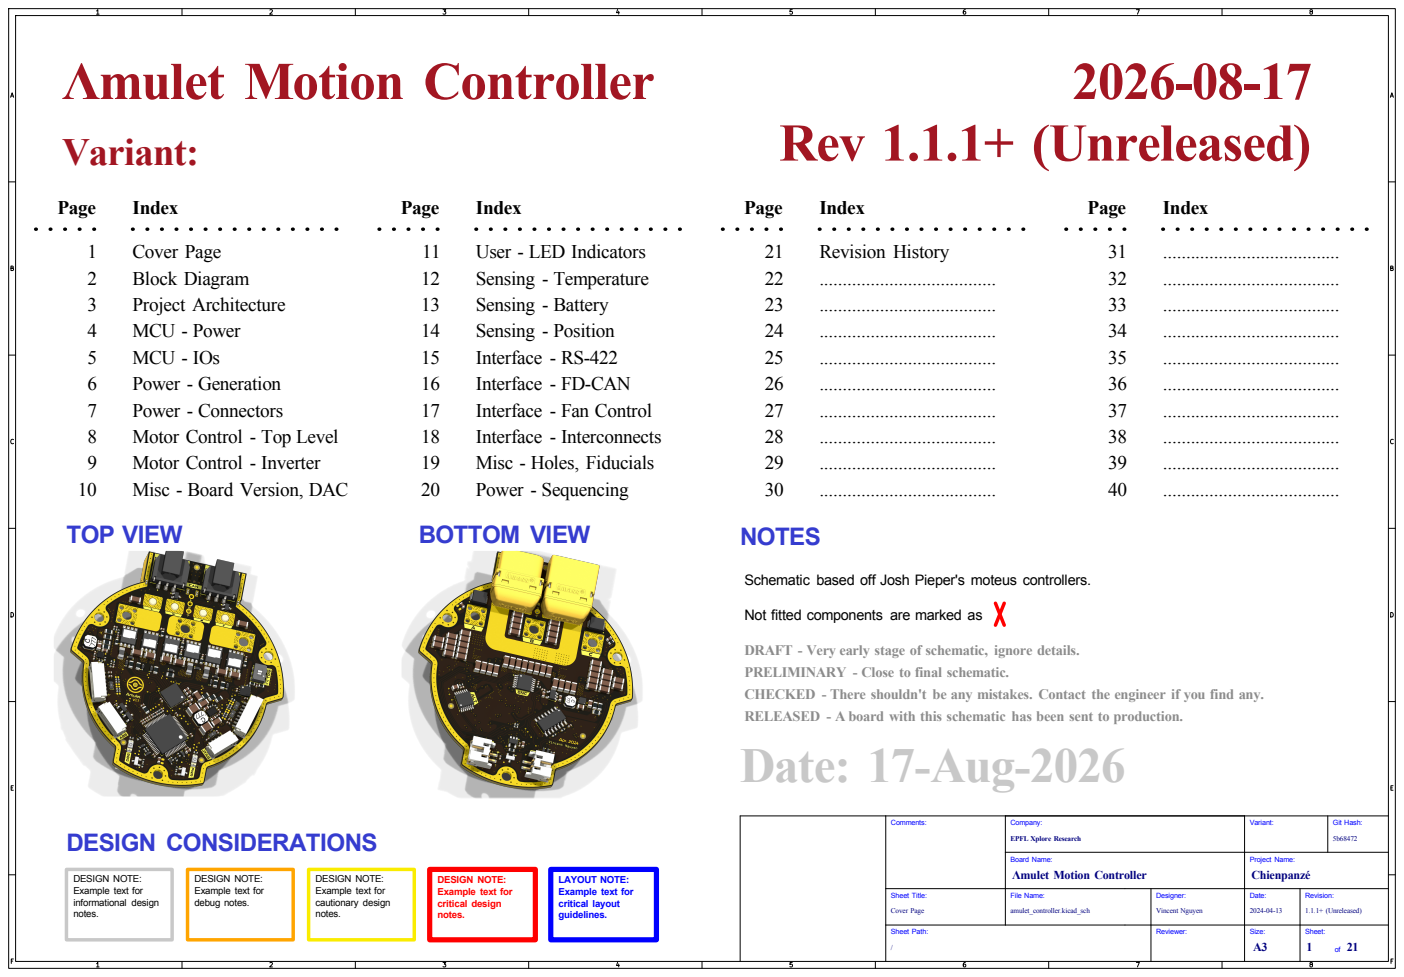
[picture p23: page 1]
Sheet: of 21; Size: A3; amulet_controller.kicad_sch; Vincent Nguyen Board Name: Company:; Variant: EPFL Xplore Research Λmulet Motion Controller; Chienpanzé; Sheet Title:; File Name:; /Sheet Path: Cover Page Comments:; Git Hash: 5b68472 Project Architecture; kibot_image_png_3d_viewer_angled_bottom; LAYOUT NOTE:; kibot_image_png_3d_viewer_angled_top; DESIGN NOTE:; Page; Index; Sensing - Battery; Block Diagram; Revision History; Misc - Board Version, DAC; TOP VIEW; Interface - FD-CAN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

Cover Page
Project Architecture
MCU - Power
MCU - IOs
Power - Generation
Power - Connectors
Motor Control - Top Level
Motor Control - Inverter

User - LED Indicators
Sensing - Temperature
Interface - RS-422
Interface - Fan Control
Misc - Holes, Fiducials
Power - Sequencing
BOTTOM VIEW

Schematic based off Josh Pieper's moteus controllers. (https://github.com/mjbots/moteus) ......................................
NOTES

Not fitted components are marked as

DRAFT - Very early stage of schematic, ignore details.
PRELIMINARY - Close to final schematic.
CHECKED - There shouldn't be any mistakes. Contact the engineer if you find any.
RELEASED - A board with this schematic has been sent to production.
Date: 17-Aug-2026

Revision: 1.1.1+ (Unreleased) Date: Project Name: 2024-04-13 Reviewer: Designer:

DESIGN NOTE:
Example text for
informational design
notes.

cautionary design

critical design

debug notes.

critical layout
guidelines.
