RRichard67/amulet_controller_kibot/Schematic/amulet_controller-schematic-10.pdf

# [10] Misc - Board Version, DAC

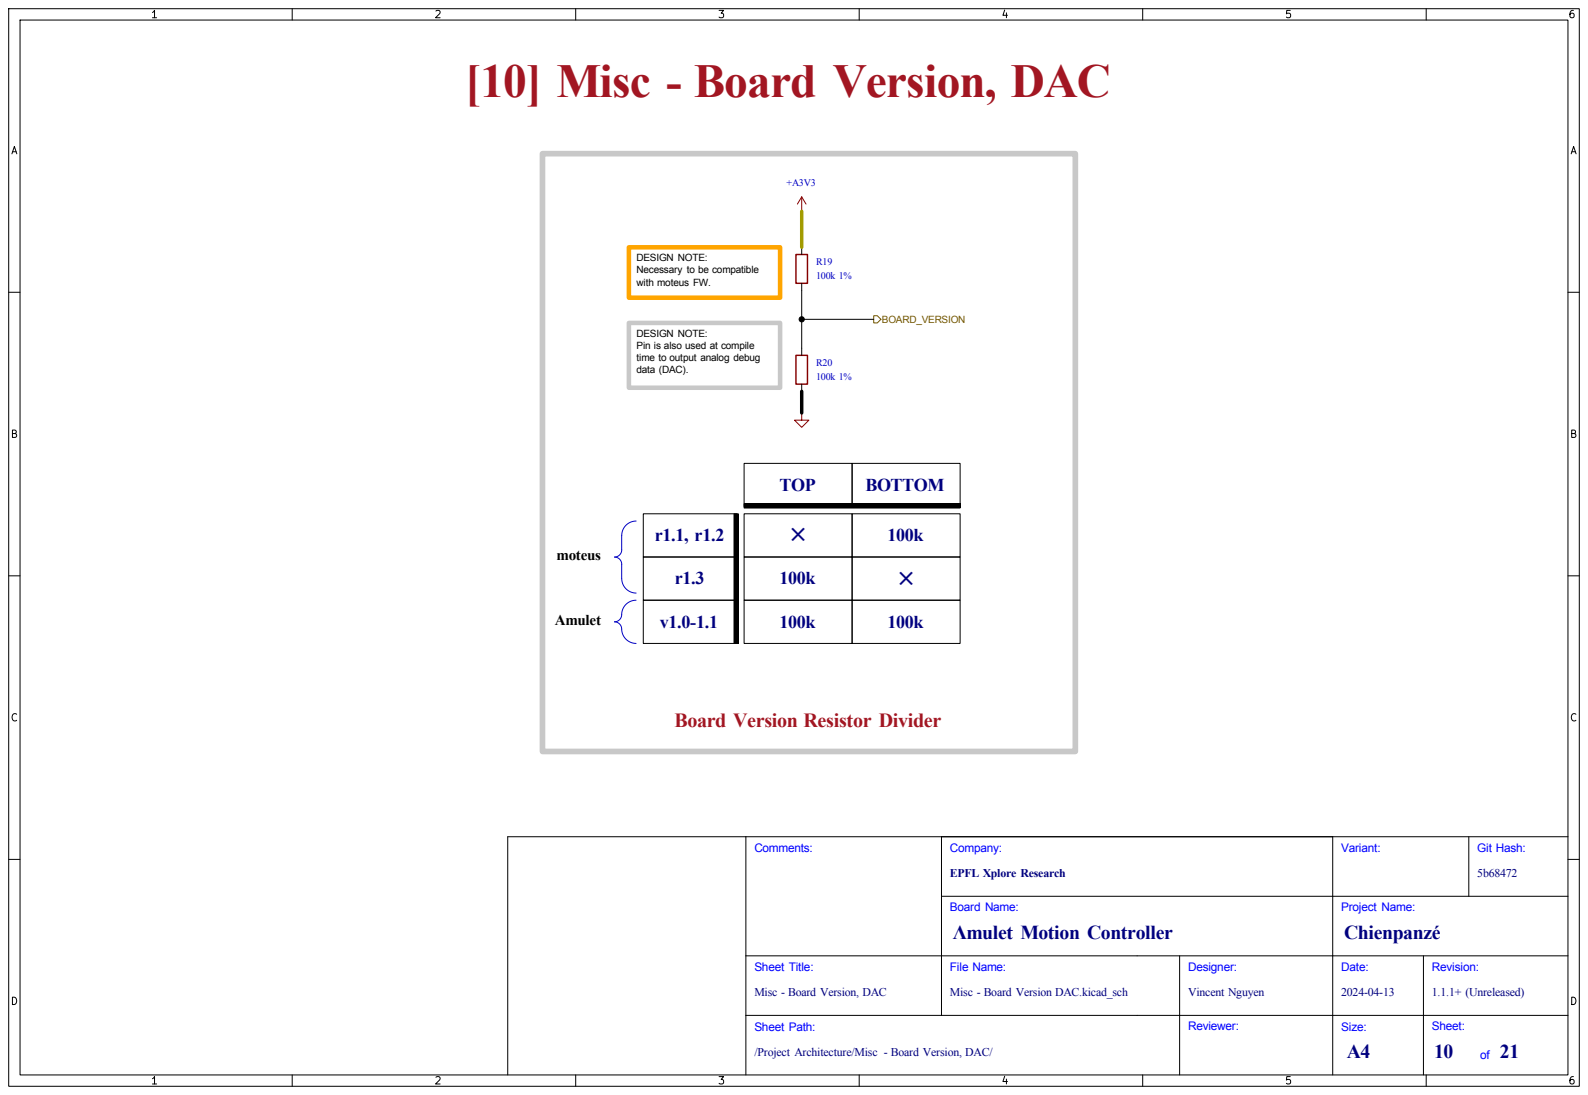
[picture p24: page 1]
Sheet: of 21; Size: A4; Revision: 1.1.1+ (Unreleased) Date: Project Name: 2024-04-13 Reviewer: Designer: Misc - Board Version DAC.kicad_sch; Vincent Nguyen Board Name: Company:; Variant: EPFL Xplore Research Λmulet Motion Controller; Chienpanzé; Sheet Title:; File Name:; /Project Architecture/Misc - Board Version, DAC/ Sheet Path: Misc - Board Version, DAC Comments:; Git Hash: 5b68472; BOARD_VERSION; moteus; TOP; BOTTOM; Amulet

DESIGN NOTE: Necessary to be compatible with moteus FW. DESIGN NOTE: Pin is also used at compile

time to output analog debug
data (DAC).

Board Version Resistor Divider
