RRichard67/amulet_controller_kibot/Schematic/amulet_controller-schematic-11.pdf

# P = (5V - 3V)×13mA = 26 mW [11] User - LED Indicators

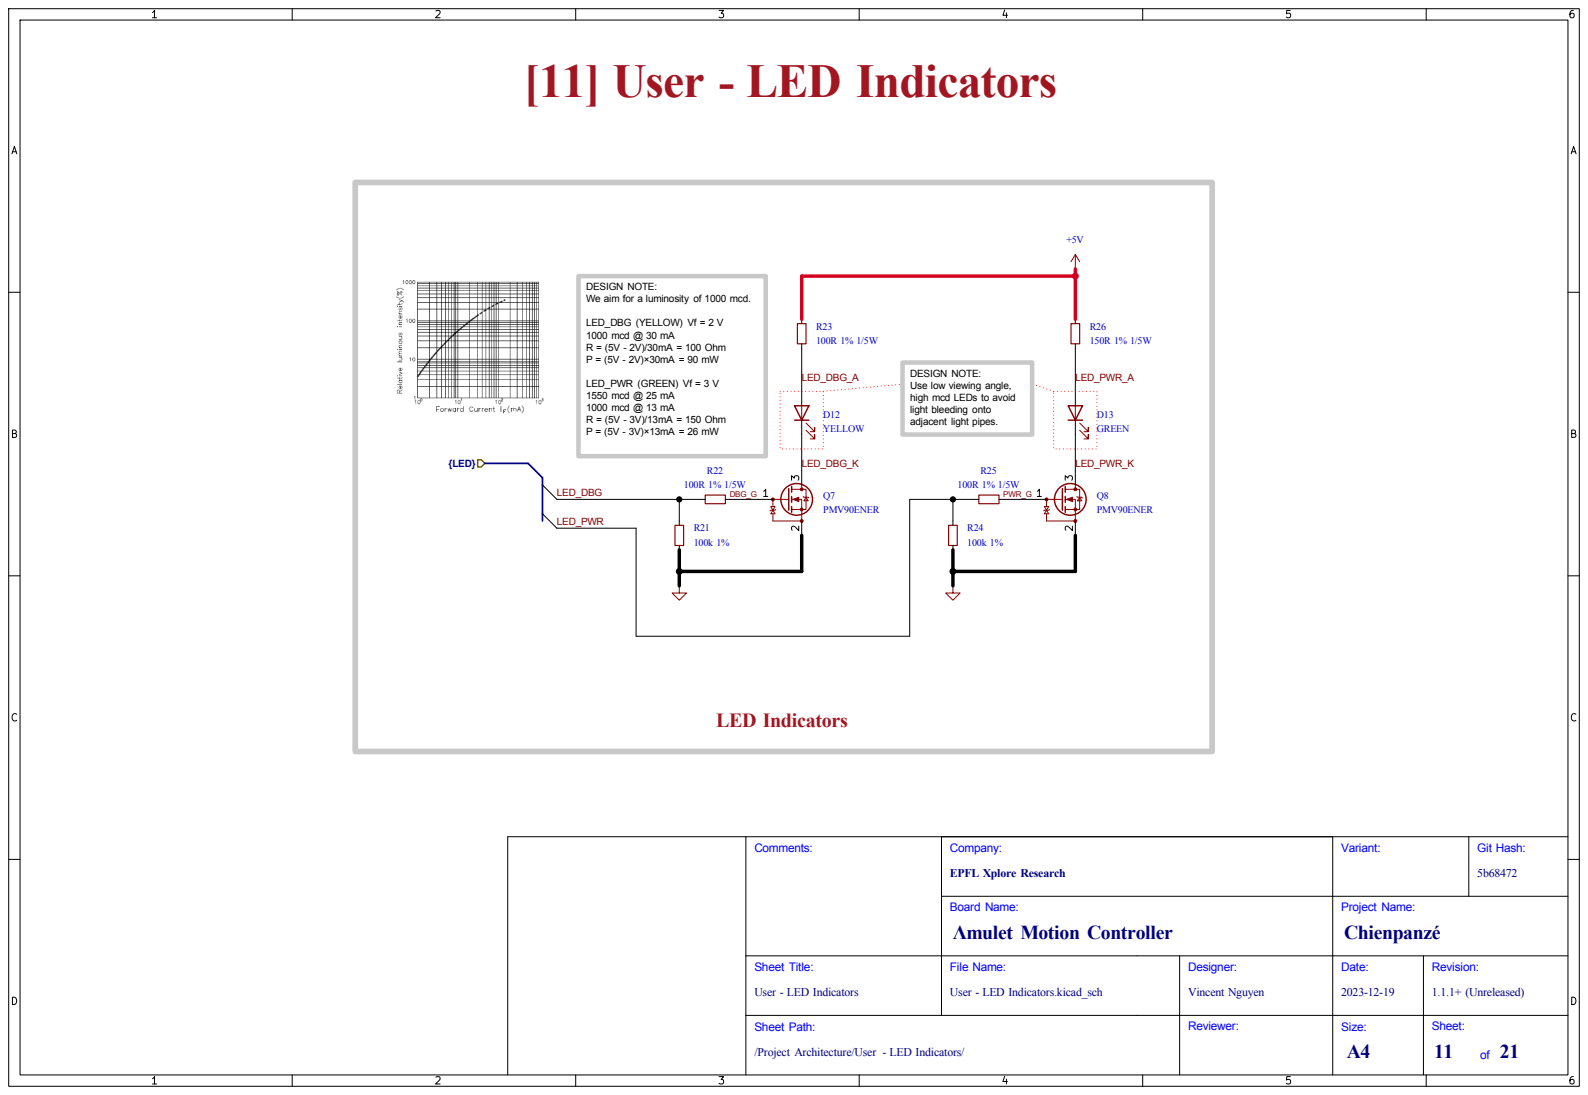
[picture p25: page 1]

DESIGN NOTE: Use low viewing angle,

high mcd LEDs to avoid
light bleeding onto
adjacent light pipes.
