RRichard67/amulet_controller_kibot/Schematic/amulet_controller-schematic-12.pdf

# [12] Sensing - Temperature

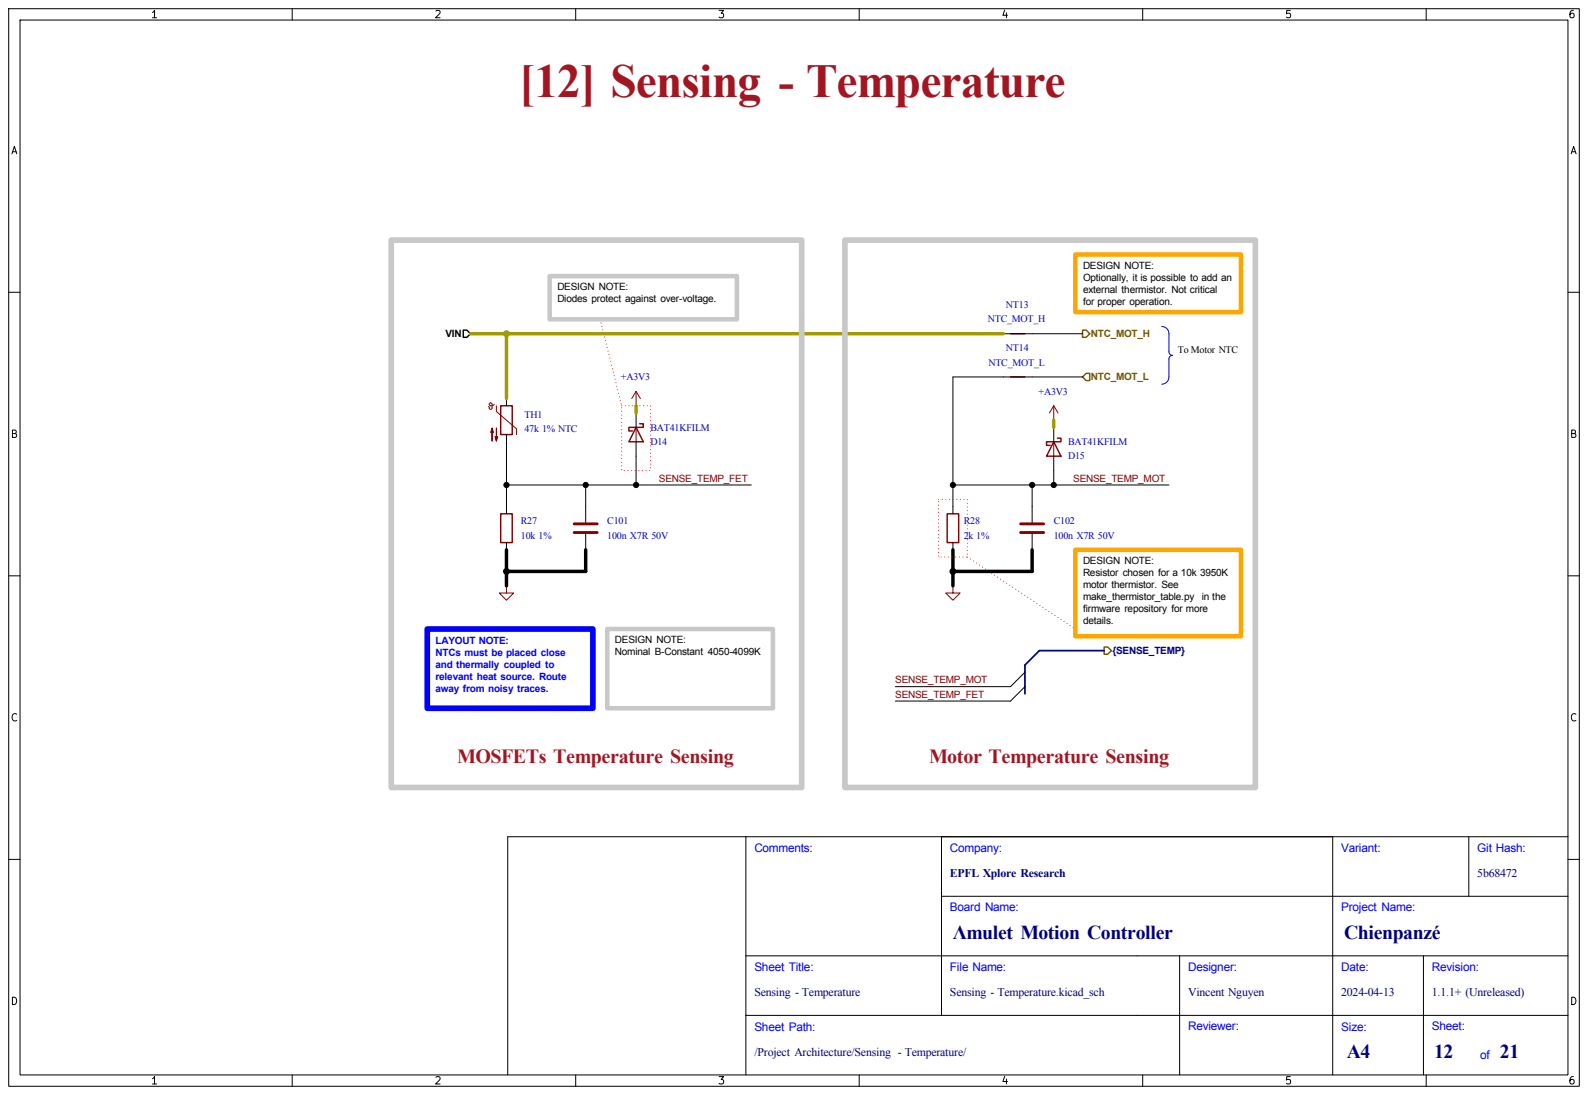
[picture p26: page 1]
Sheet: of 21; Size: A4; Sensing - Temperature.kicad_sch; Vincent Nguyen Board Name: Company:; Variant: EPFL Xplore Research Λmulet Motion Controller; Chienpanzé; Sheet Title:; File Name:; /Project Architecture/Sensing - Temperature/ Sheet Path: Sensing - Temperature Comments:; Git Hash: 5b68472 D15 BAT41KFILM; +A3V3 NT14 NTC_MOT_L NT13 NTC_MOT_H; 47k 1% NTC; D14 BAT41KFILM; NTC_MOT_L VIN; NTC_MOT_H; {SENSE_TEMP}; SENSE_TEMP_FET; SENSE_TEMP_MOT; SENSE_TEMP_MOT SENSE_TEMP_FET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

DESIGN NOTE: Optionally, it is possible to add an

external thermistor. Not critical for proper operation. To Motor NTC DESIGN NOTE: Diodes protect against over-voltage. DESIGN NOTE: Nominal B-Constant 4050-4099K MOSFETs Temperature Sensing

details. Motor Temperature Sensing

firmware repository for more

LAYOUT NOTE: NTCs must be placed close

and thermally coupled to
relevant heat source. Route

Revision: 1.1.1+ (Unreleased) Date: Project Name: 2024-04-13 Reviewer: Designer:
