RRichard67/amulet_controller_kibot/Schematic/amulet_controller-schematic-13.pdf

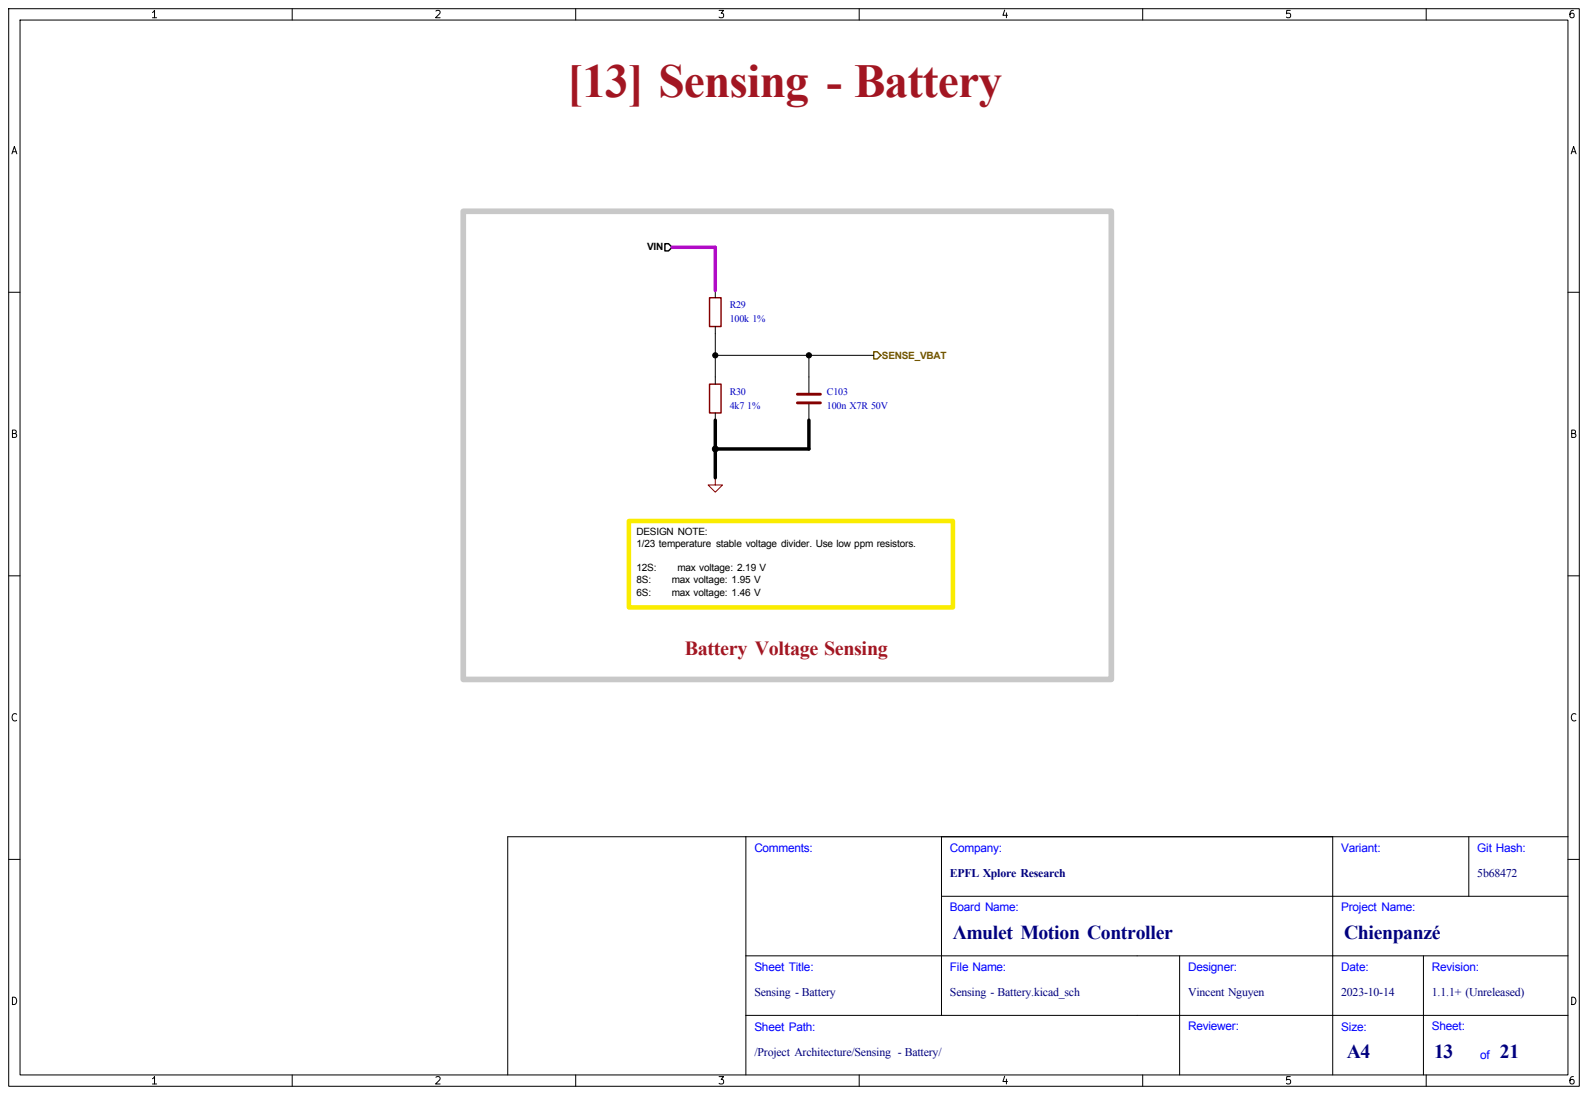
[picture p27: page 1]
Sheet: of 21; Size: A4; Sensing - Battery.kicad_sch; Vincent Nguyen Board Name: Company:; Variant: EPFL Xplore Research Λmulet Motion Controller; Chienpanzé; Sheet Title:; File Name:; /Project Architecture/Sensing - Battery/ Sheet Path: Sensing - Battery Comments:; Git Hash: 5b68472; VIN; SENSE_VBAT; DESIGN NOTE: 1/23 temperature stable voltage divider. Use low ppm resistors. 12S:; max voltage: 2.19 V; max voltage: 1.95 V; max voltage: 1.46 V [13] Sensing - Battery

Battery Voltage Sensing

Revision: 1.1.1+ (Unreleased) Date: Project Name: 2023-10-14 Reviewer: Designer:
