RRichard67/amulet_controller_kibot/Schematic/amulet_controller-schematic-14.pdf

# [14] Sensing - Position

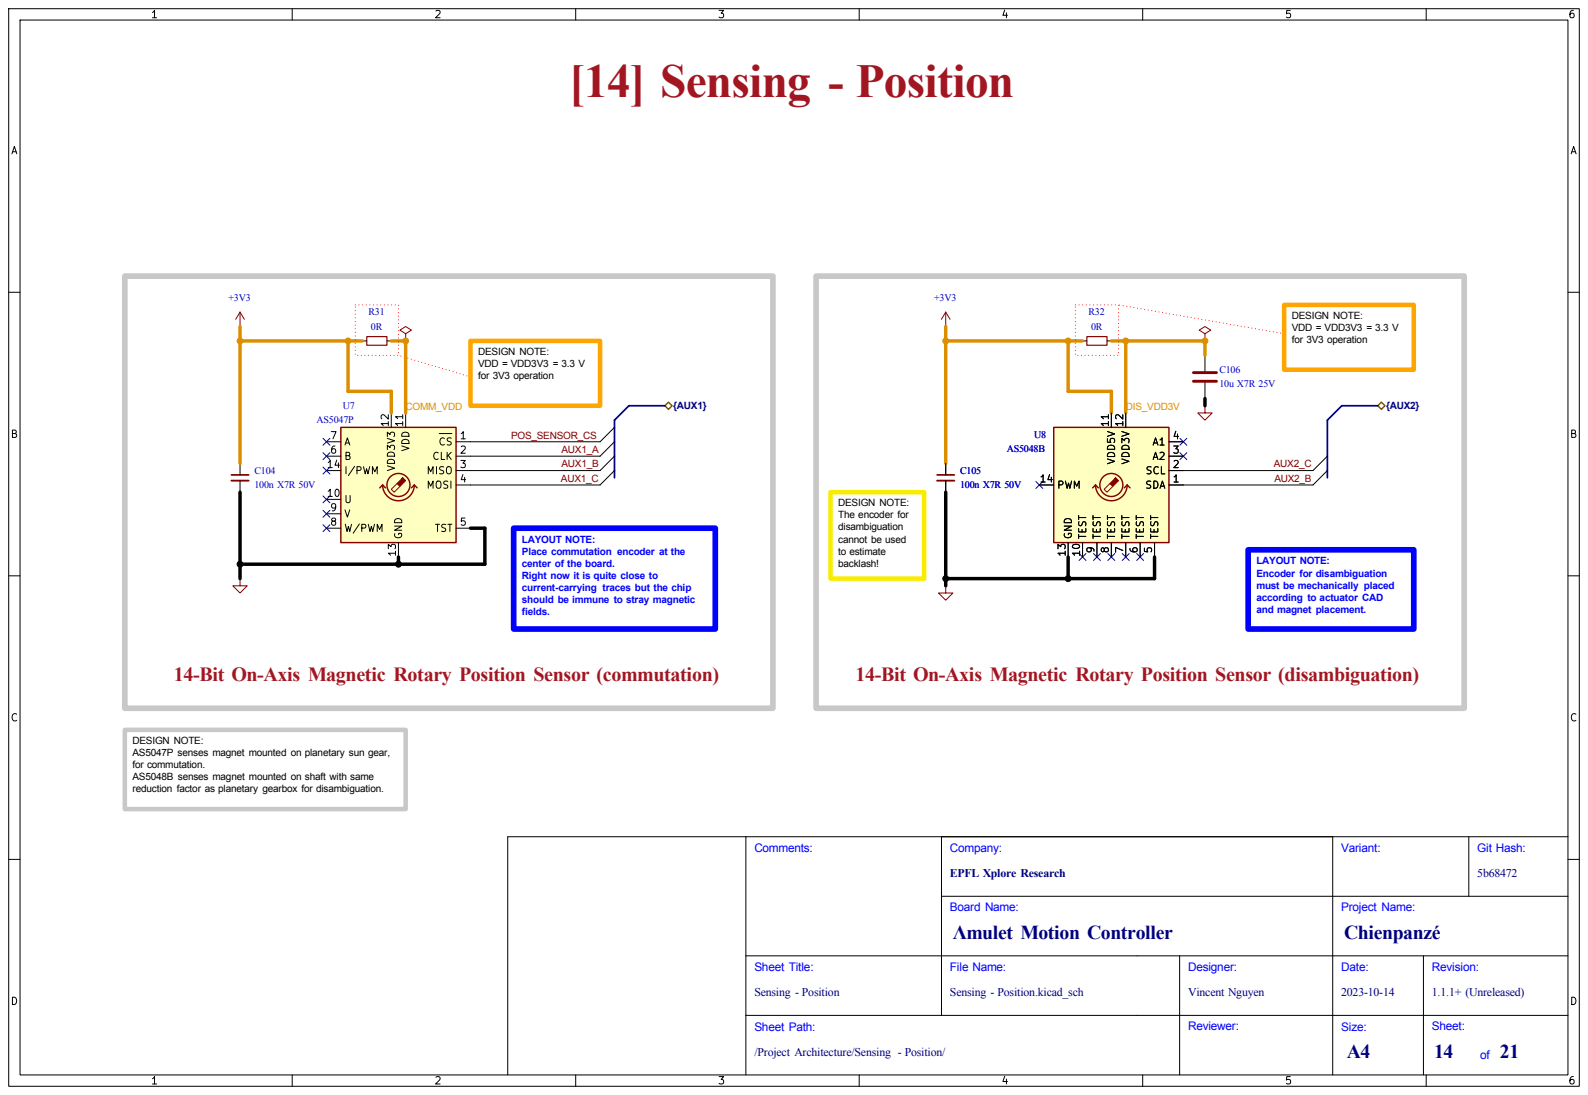
[picture p28: page 1]
Sheet: of 21; Size: A4; Sensing - Position.kicad_sch; Vincent Nguyen Board Name: Company:; Variant: EPFL Xplore Research Λmulet Motion Controller; Chienpanzé; Sheet Title:; File Name:; /Project Architecture/Sensing - Position/ Sheet Path: Sensing - Position Comments:; Git Hash: 5b68472; CS 1 CLK 2 MISO 3 MOSI 4; TST 5 B; A 7 W/PWM 8; VDD 11 VDD3V3 12 GND 13; I/PWM 14 U7 AS5047P; SDA 1; SCL 2; A1 4 TEST 5 TEST 6 TEST 7 TEST 8 TEST 9 TEST 10; VDD5V 11; VDD3V 12 GND 13 PWM 14 U8 AS5048B; {AUX1}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

for 3V3 operation DESIGN NOTE: AS5047P senses magnet mounted on planetary sun gear,

and magnet placement. DESIGN NOTE: VDD = VDD3V3 = 3.3 V

for 3V3 operation LAYOUT NOTE: Place commutation encoder at the

cannot be used
to estimate

center of the board. Right now it is quite close to

current-carrying traces but the chip
should be immune to stray magnetic

according to actuator CAD

for commutation. AS5048B senses magnet mounted on shaft with same

Revision: 1.1.1+ (Unreleased) Date: Project Name: 2023-10-14 Reviewer: Designer:
