RRichard67/amulet_controller_kibot/Schematic/amulet_controller-schematic-15.pdf

# +3V3 NC 1 R

# [15] Interface - RS-422

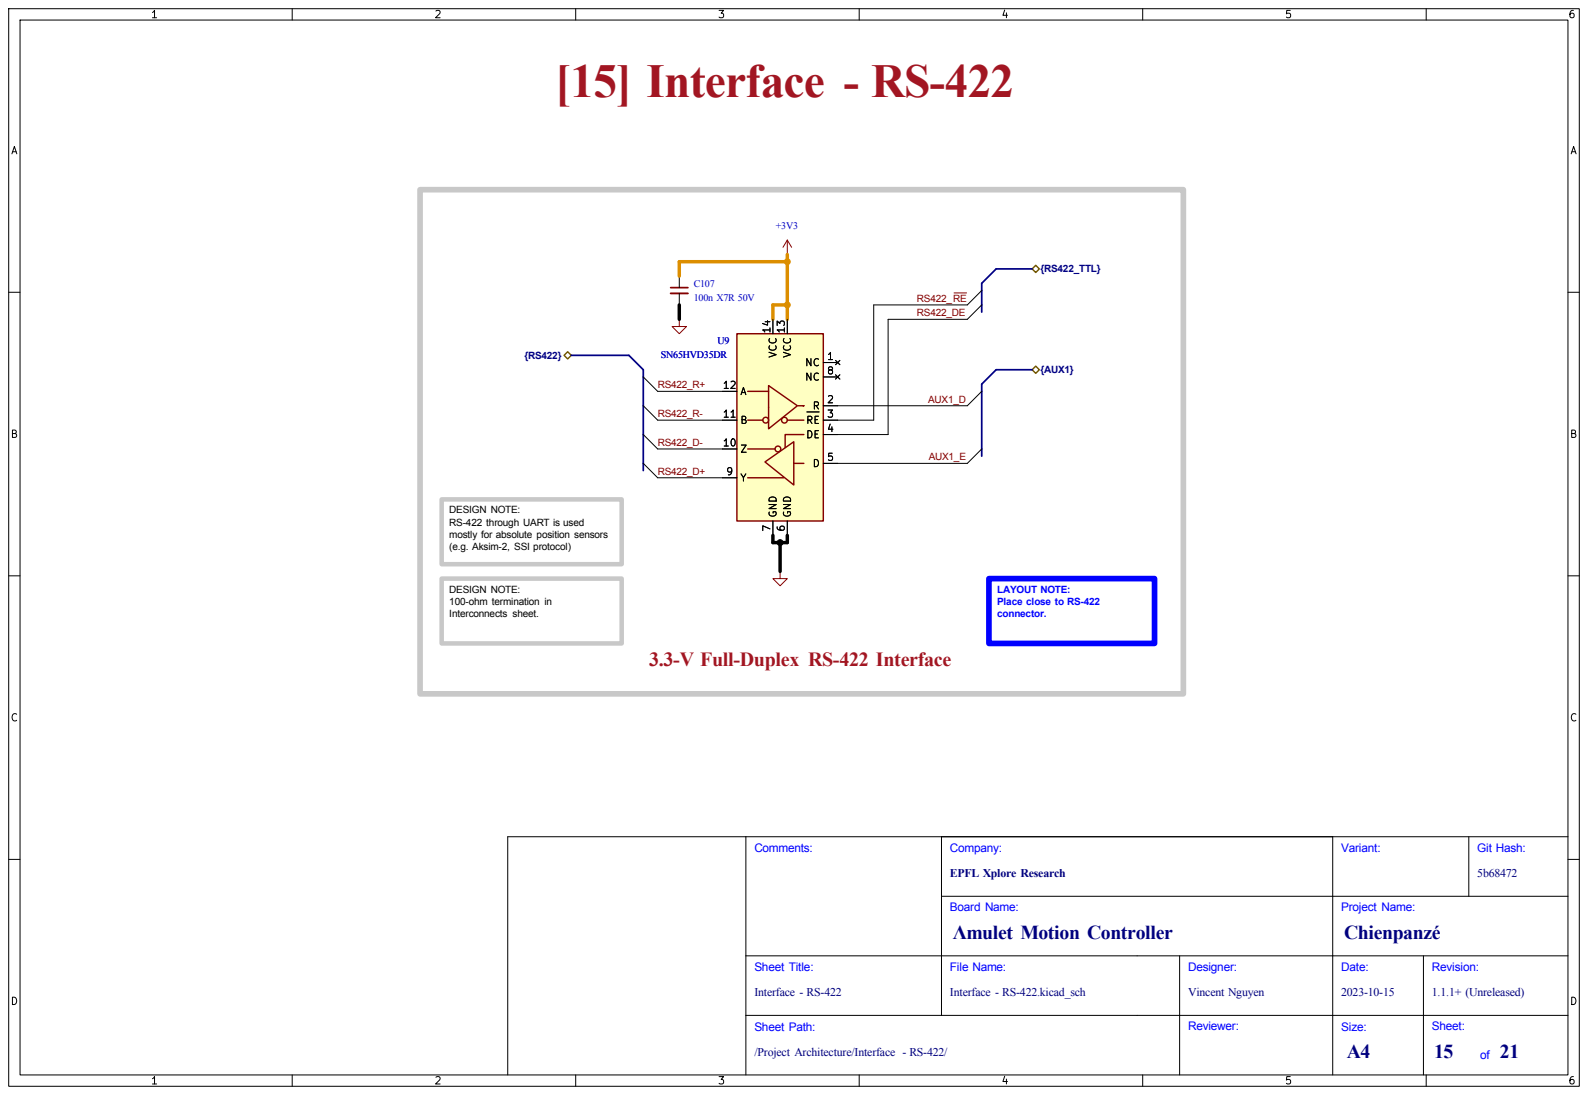
[picture p29: page 1]
Sheet: of 21; Size: A4; Revision: 1.1.1+ (Unreleased) Date: Project Name: 2023-10-15 Reviewer: Designer: Interface - RS-422.kicad_sch; Vincent Nguyen Board Name: Company:; Variant: EPFL Xplore Research Λmulet Motion Controller; Chienpanzé; Sheet Title:; File Name:; /Project Architecture/Interface - RS-422/ Sheet Path: Interface - RS-422 Comments:; Git Hash: 5b68472; 5 GND; 6 GND; VCC 13 VCC 14 U9; SN65HVD35DR; {RS422_TTL}; {AUX1}; AUX1_E; AUX1_D; connector. U9 SN65HVD35DR; VCC 13 VCC 14

RS422_R+ DESIGN NOTE: 100-ohm termination in

Interconnects sheet. DESIGN NOTE: RS-422 through UART is used mostly for absolute position sensors

(e.g. Aksim-2, SSI protocol)

LAYOUT NOTE: Place close to RS-422

3.3-V Full-Duplex RS-422 Interface
