RRichard67/amulet_controller_kibot/Schematic/amulet_controller-schematic-16.pdf

# [16] Interface - FD-CAN

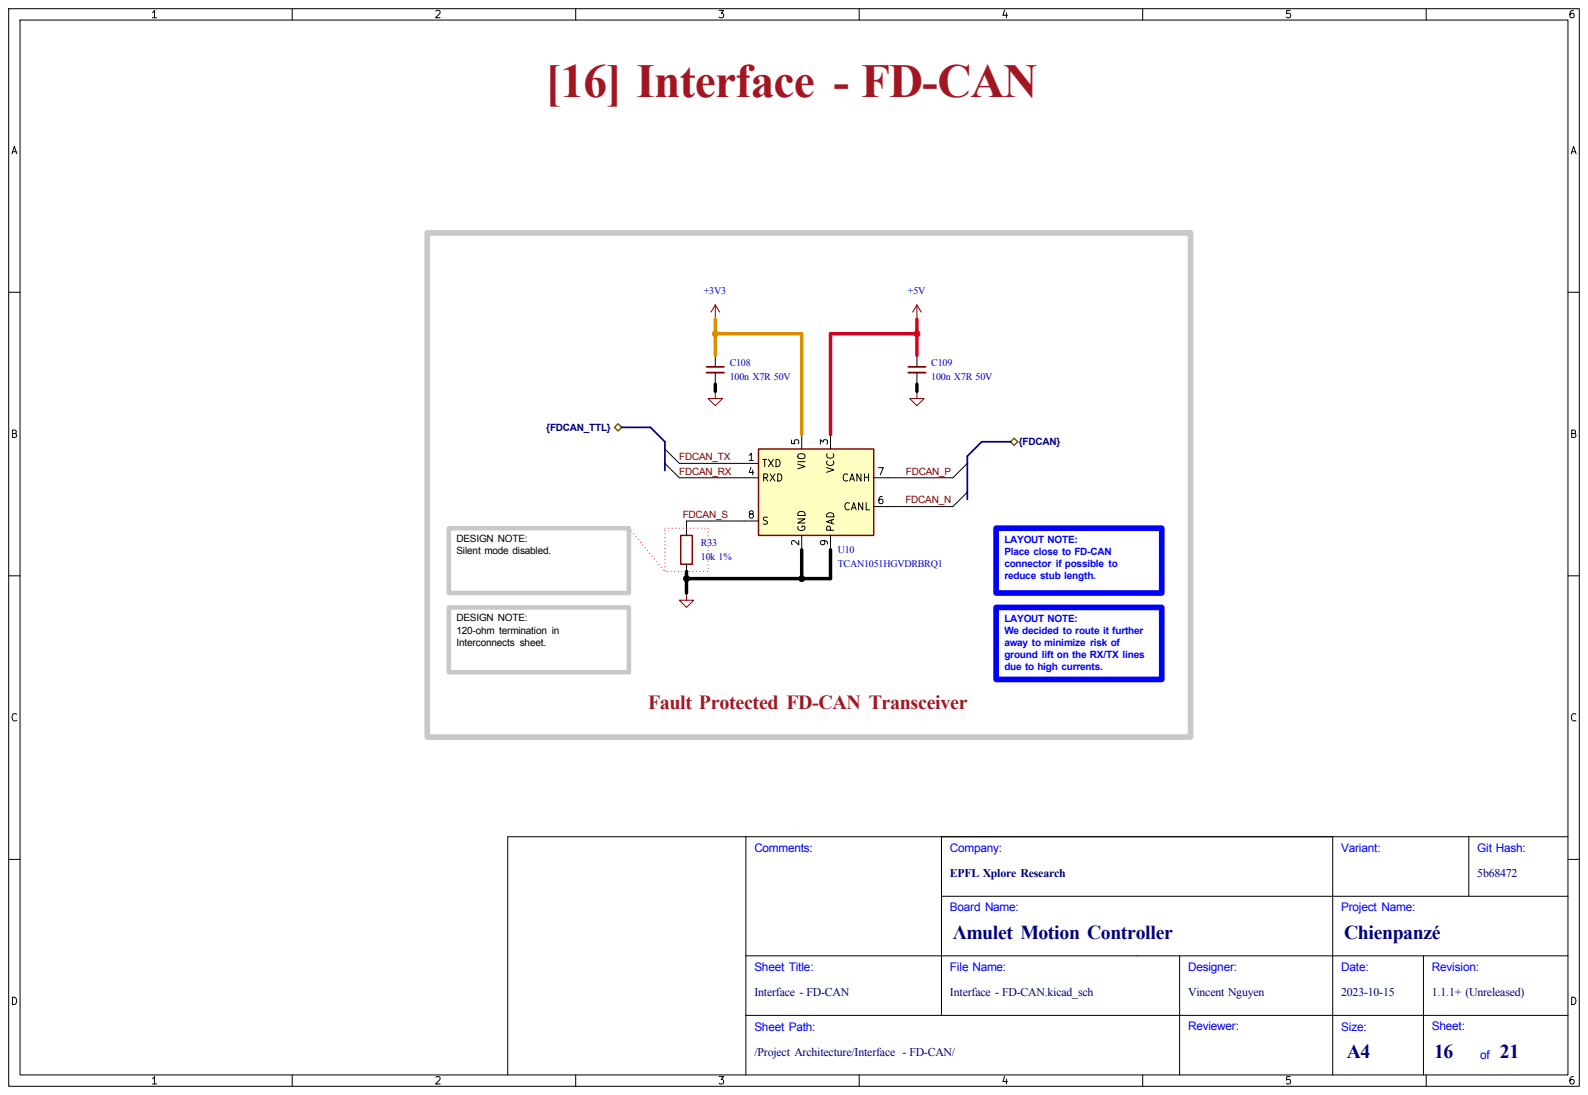
[picture p30: page 1]
Sheet: of 21; Size: A4; Revision: 1.1.1+ (Unreleased) Date: Project Name: 2023-10-15 Reviewer: Designer: Interface - FD-CAN.kicad_sch; Vincent Nguyen Board Name: Company:; Variant: EPFL Xplore Research Λmulet Motion Controller; Chienpanzé; Sheet Title:; File Name:; Comments:; Git Hash: 5b68472; TXD 1; GND; 2 VCC; 3 RXD 4 VIO; 5 CANL 6 CANH 7; PAD; 9U10 TCAN1051HGVDRBRQ1 +5V; {FDCAN_TTL}; {FDCAN}; FDCAN_S; FDCAN_RX; FDCAN_TX; FDCAN_P; FDCAN_N; Interconnects sheet.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

DESIGN NOTE: Silent mode disabled. DESIGN NOTE: 120-ohm termination in

LAYOUT NOTE: Place close to FD-CAN

connector if possible to
reduce stub length.

/Project Architecture/Interface - FD-CAN/ Sheet Path: Interface - FD-CAN
