RRichard67/amulet_controller_kibot/Schematic/amulet_controller-schematic-17.pdf

# rate of FET. [17] Interface - Fan Control

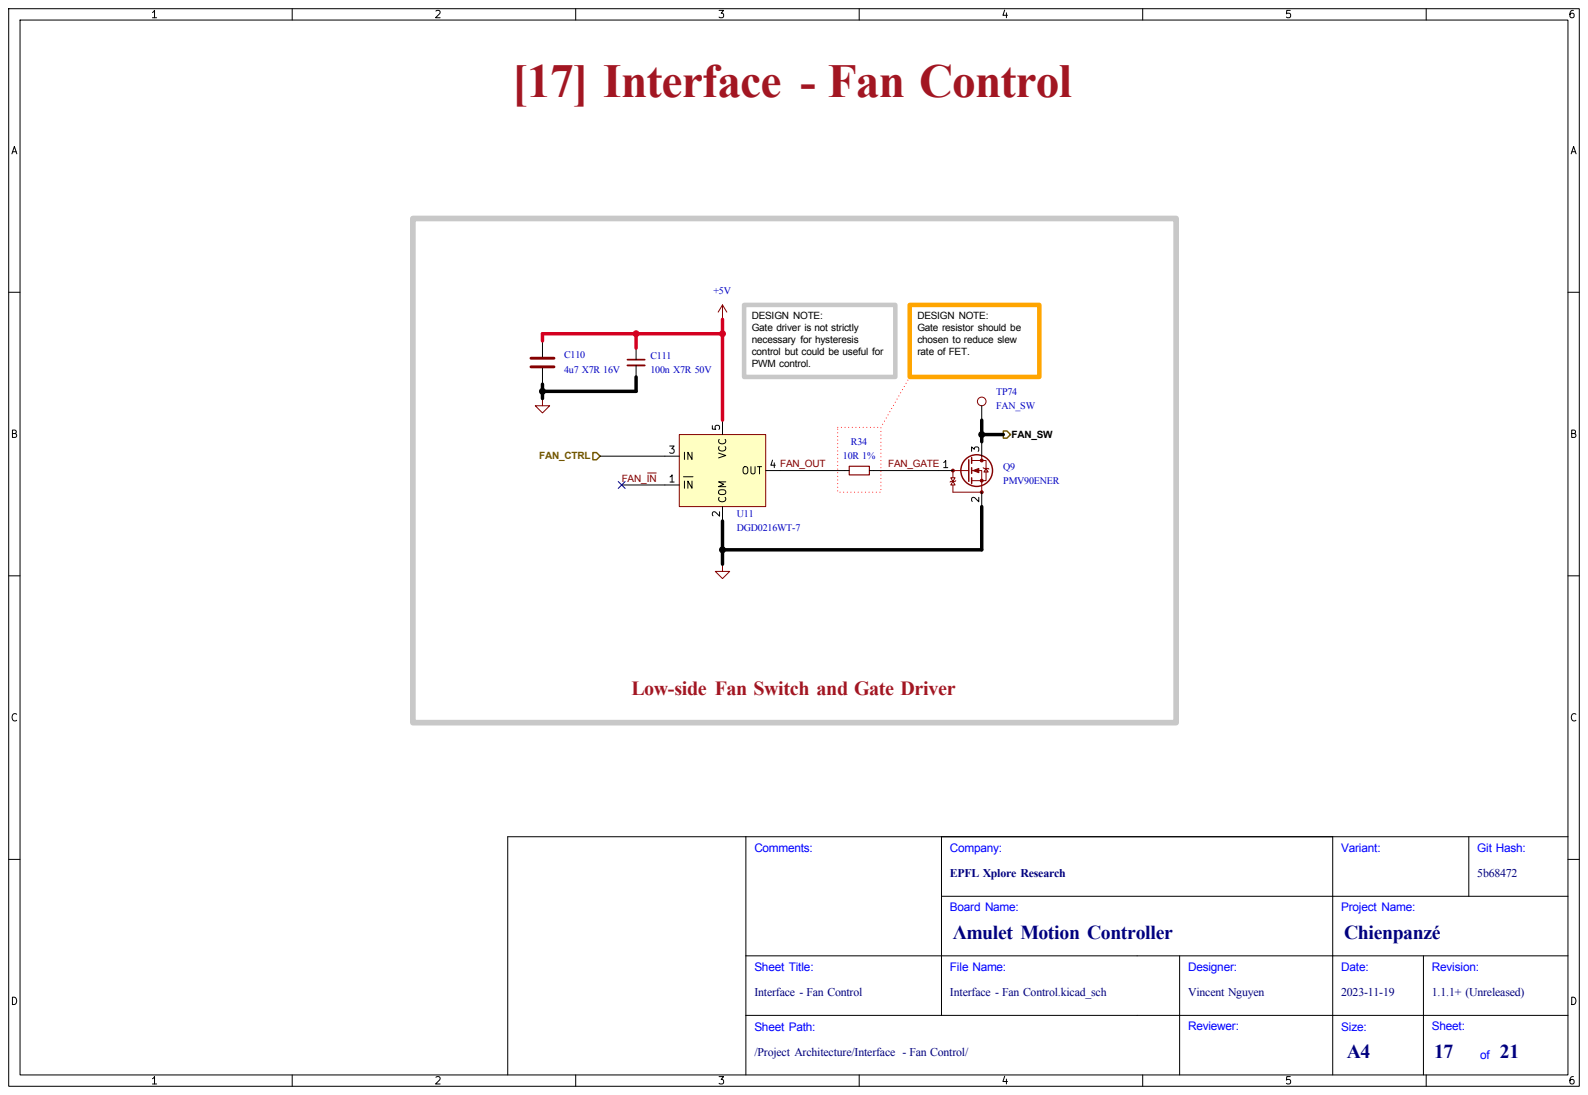
[picture p31: page 1]
Sheet: of 21; Size: A4; Revision: 1.1.1+ (Unreleased) Date: Project Name: 2023-11-19 Reviewer: Designer: Interface - Fan Control.kicad_sch; Vincent Nguyen Board Name: Company:; Variant: EPFL Xplore Research Λmulet Motion Controller; Chienpanzé; Sheet Title:; File Name:; /Project Architecture/Interface - Fan Control/ Sheet Path: Interface - Fan Control Comments:; Git Hash: 5b68472; COM; OUT 4 VCC; 5 U11 DGD0216WT-7 TP74 FAN_SW; 2 3 Q9 PMV90ENER; FAN_CTRL; FAN_SW; FAN_IN; FAN_OUT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

chosen to reduce slew

Low-side Fan Switch and Gate Driver
