RRichard67/amulet_controller_kibot/Schematic/amulet_controller-schematic-19.pdf

# [19] Misc - Holes, Fiducials

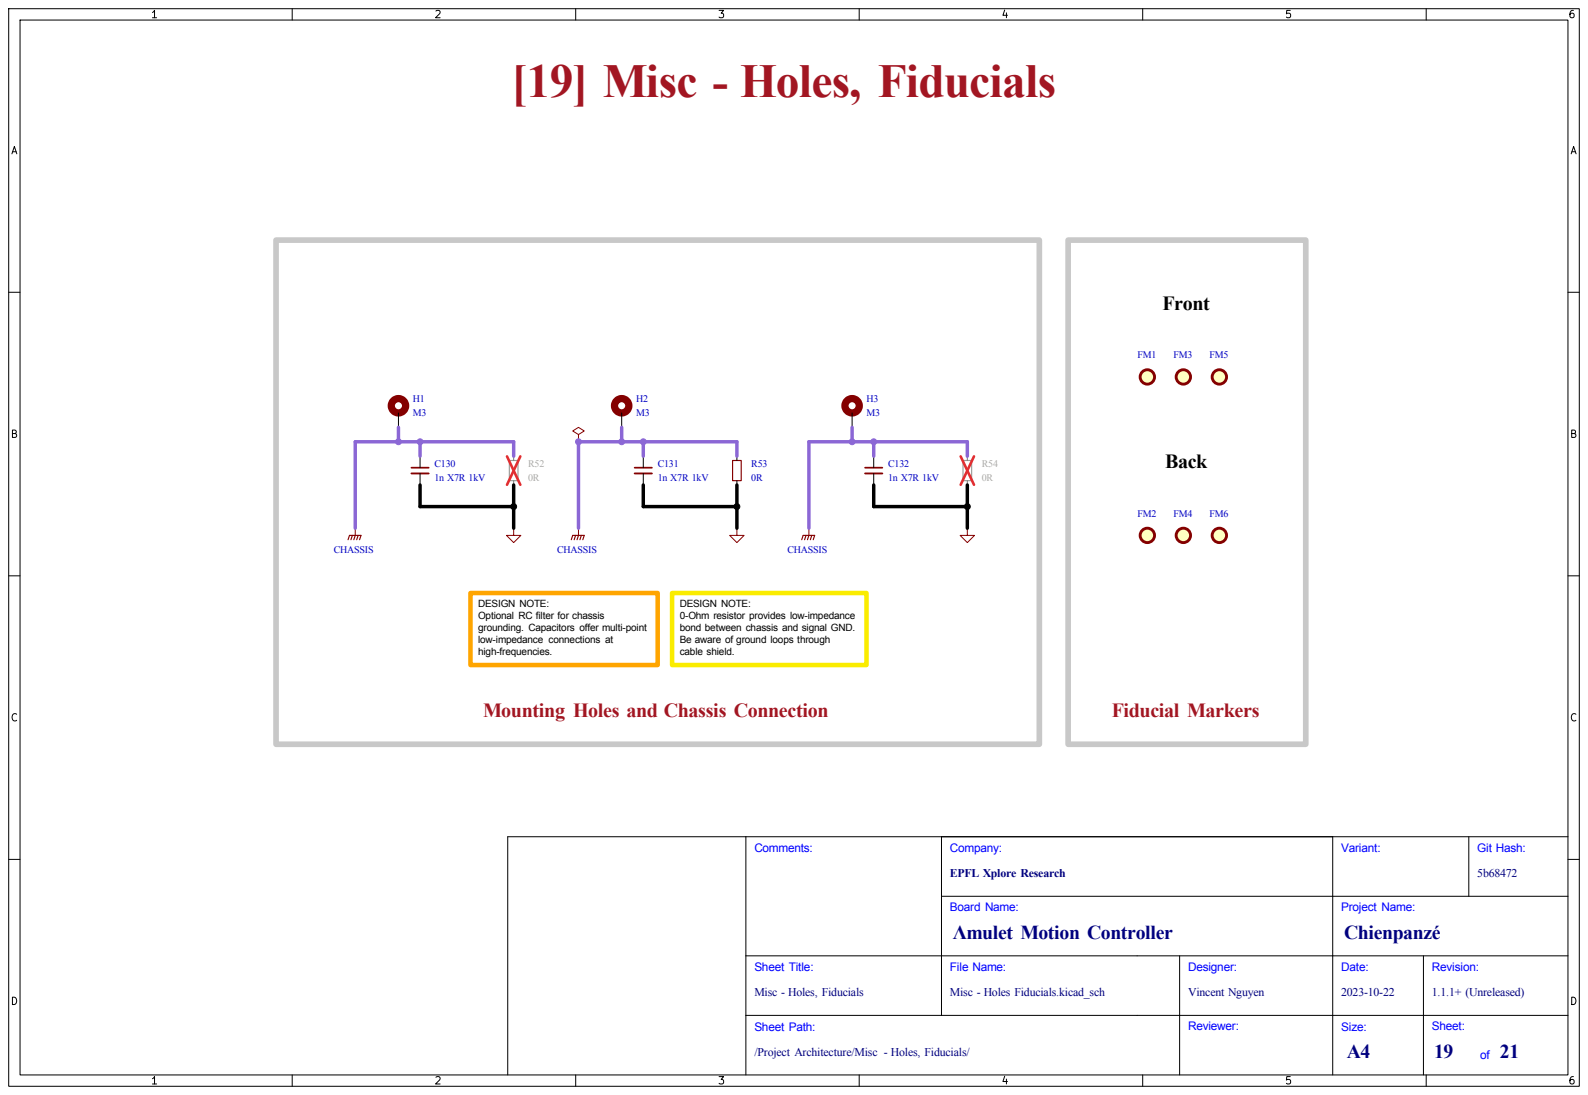
[picture p32: page 1]
Sheet: of 21; Size: A4; Revision: 1.1.1+ (Unreleased) Date: Project Name: 2023-10-22 Reviewer: Designer: Misc - Holes Fiducials.kicad_sch; Vincent Nguyen Board Name: Company:; Variant: EPFL Xplore Research Λmulet Motion Controller; Chienpanzé; Sheet Title:; File Name:; /Project Architecture/Misc - Holes, Fiducials/ Sheet Path: Misc - Holes, Fiducials Comments:; Git Hash: 5b68472 R54; 0R H3 M3 CHASSIS H1 M3 CHASSIS; FM5 CHASSIS C130; Back; cable shield.; Fiducial Markers

Front DESIGN NOTE: 0-Ohm resistor provides low-impedance

DESIGN NOTE: Optional RC filter for chassis grounding. Capacitors offer multi-point

bond between chassis and signal GND. Be aware of ground loops through

low-impedance connections at high-frequencies.

Mounting Holes and Chassis Connection
