RRichard67/amulet_controller_kibot/Schematic/amulet_controller-schematic-2.pdf

# [2] Block Diagram

## STM32G474

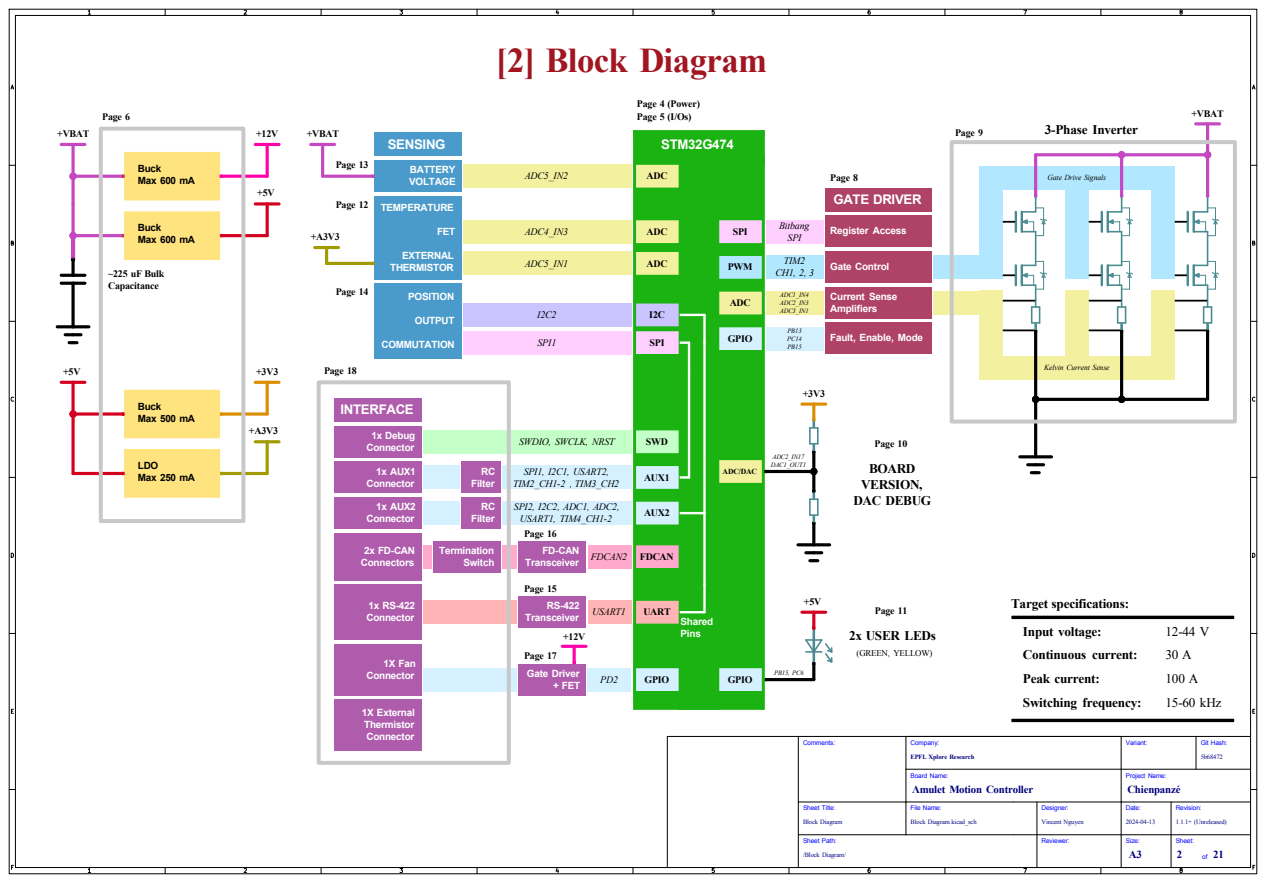
[picture p33: page 1]
Sheet: of 21; Size: A3; Revision: 1.1.1+ (Unreleased) Date: Project Name: 2024-04-13 Reviewer: Designer: Block Diagram.kicad_sch; Vincent Nguyen Board Name: Company:; Variant: EPFL Xplore Research Λmulet Motion Controller; Chienpanzé; Sheet Title:; File Name:; Comments:; Git Hash: 5b68472 1x Debug; Connector; LDO Max 250 mA; SPI; ADC5_IN2; Page 4 (Power); SPI1; Page 18; Page 5 (I/Os); Buck Max 500 mA; ADC5_IN1; ADC4_IN3; 1x AUX2 Connector; INTERFACE; TIM2 CH1, 2, 3; POSITION; OUTPUT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

Gate Drive Signals

Fault, Enable, Mode

Kelvin Current Sense

SWDIO, SWCLK, NRST

/Block Diagram/ Sheet Path: Block Diagram
