RRichard67/amulet_controller_kibot/Schematic/amulet_controller-schematic-20.pdf

## NAME

## LEVEL

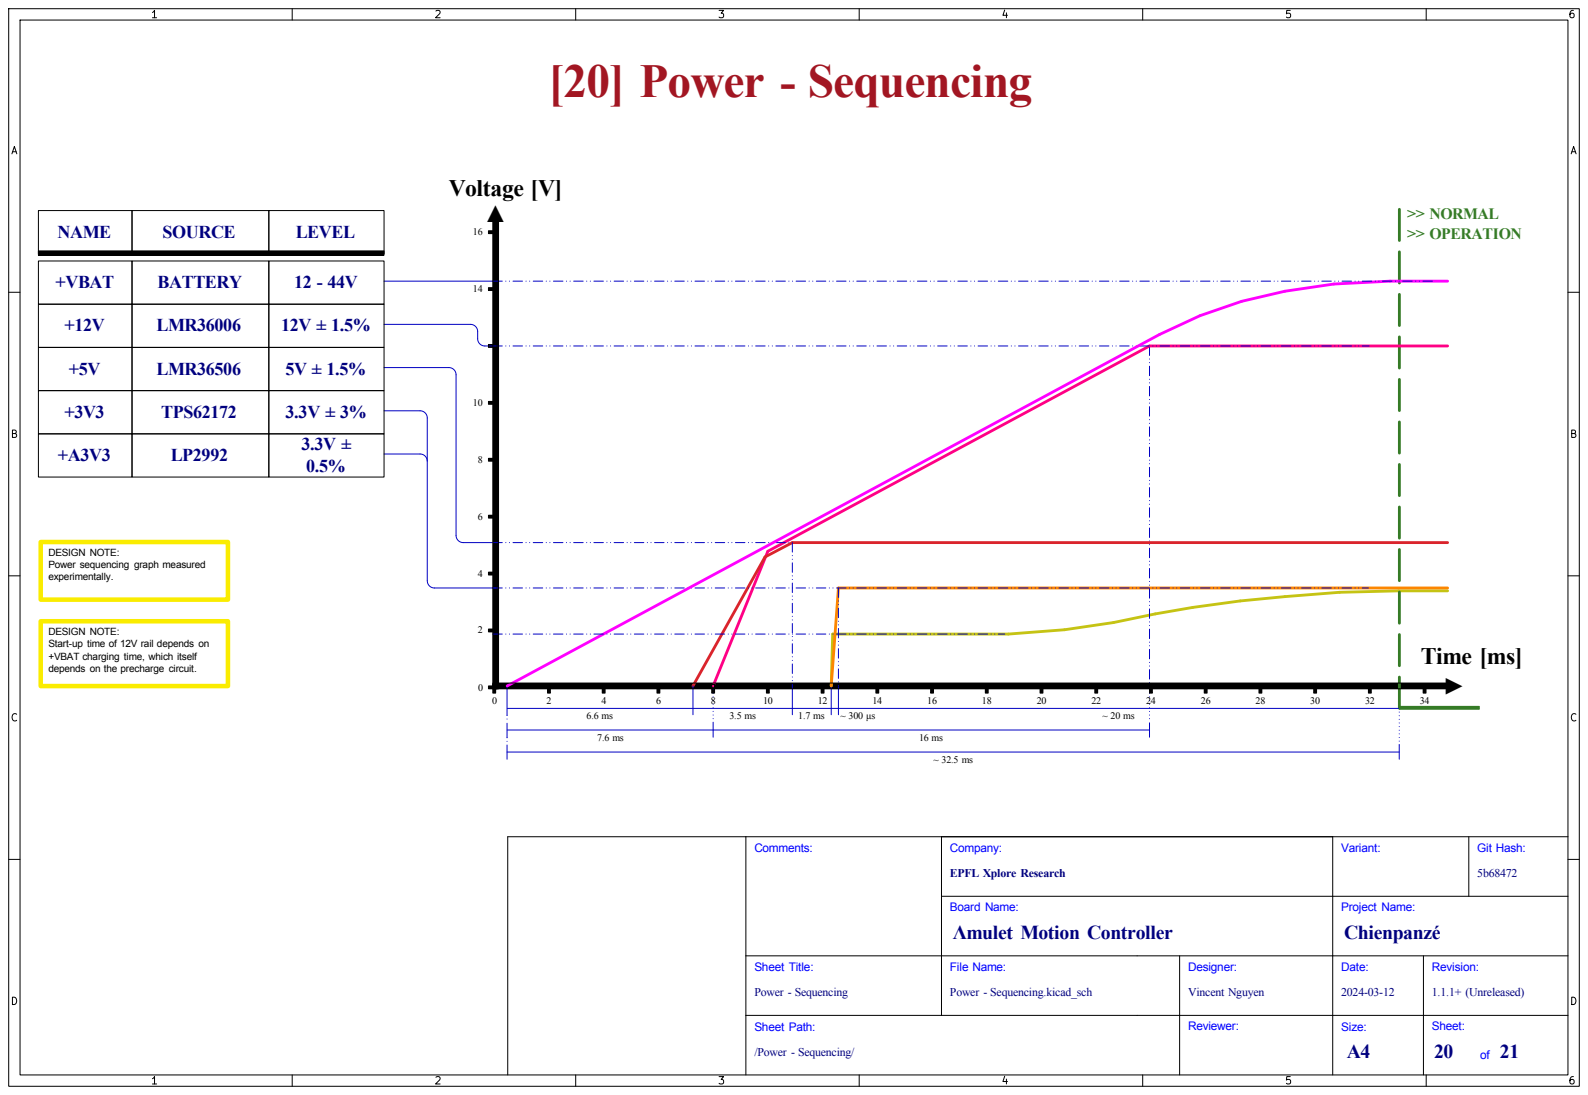
[picture p34: page 1]
Sheet: of 21; Size: A4; Revision: 1.1.1+ (Unreleased) Date: Project Name: 2024-03-12 Reviewer: Designer: Power - Sequencing.kicad_sch; Vincent Nguyen Board Name: Company:; Variant: EPFL Xplore Research Λmulet Motion Controller; Chienpanzé; Sheet Title:; File Name:; /Power - Sequencing/ Sheet Path: Power - Sequencing Comments:; Git Hash: 5b68472 3.3V ± 3%; 10 LMR36506; +VBAT; BATTERY; [20] Power - Sequencing; experimentally.; LMR36006; SOURCE; 7.6 ms TPS62172; >> NORMAL; >> OPERATION; Time [ms]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

DESIGN NOTE: Start-up time of 12V rail depends on +VBAT charging time, which itself depends on the precharge circuit. +5V

DESIGN NOTE: Power sequencing graph measured
