RRichard67/amulet_controller_kibot/Schematic/amulet_controller-schematic-3.pdf

## MCU - IOs

## MCU - Power

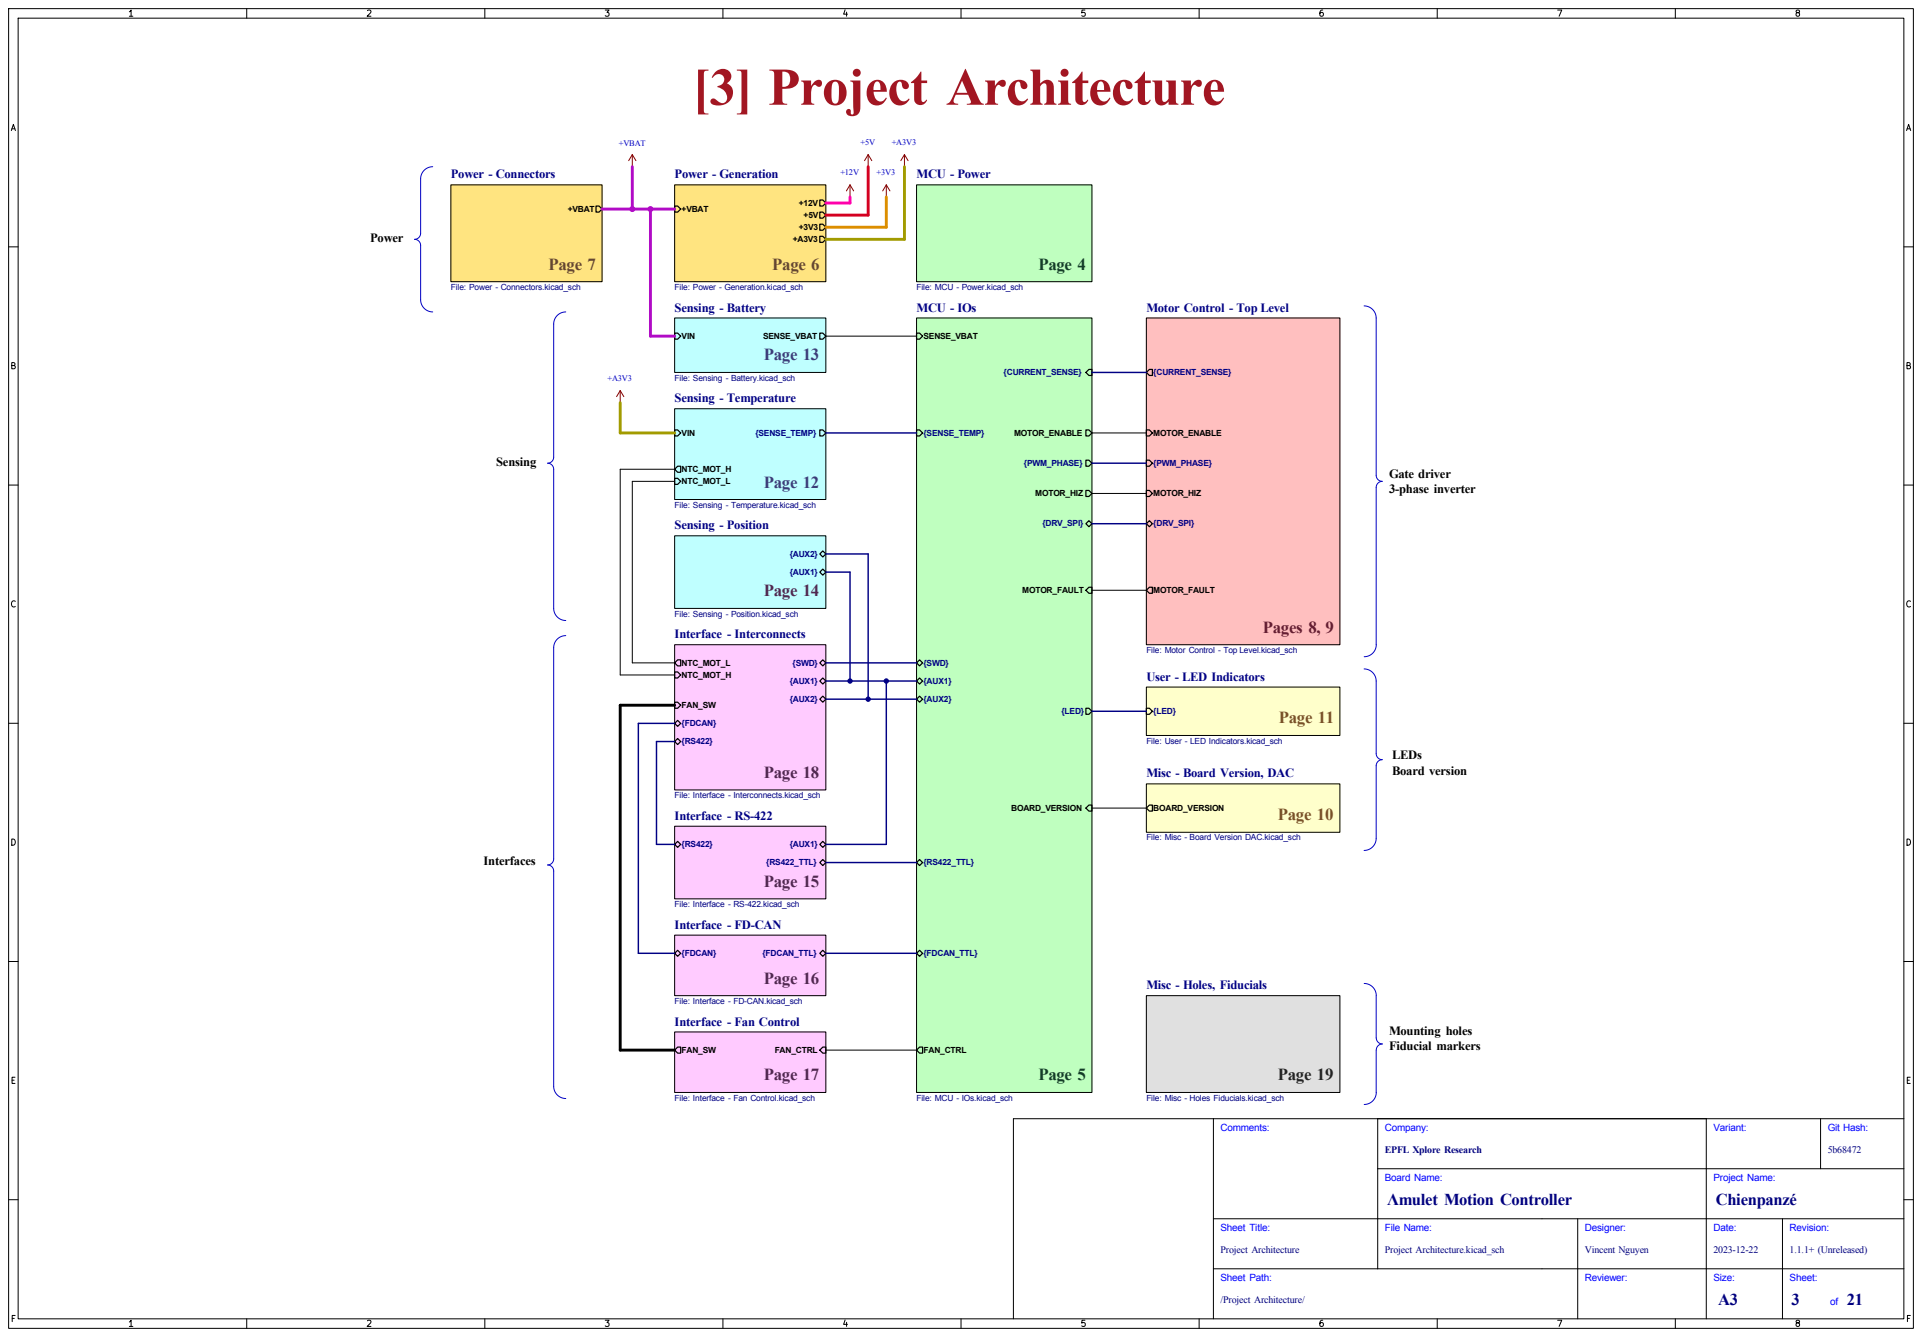
[picture p35: page 1]
Sheet: of 21; Size: A3; Project Architecture.kicad_sch; Vincent Nguyen Board Name: Company:; Variant: EPFL Xplore Research Λmulet Motion Controller; Chienpanzé; Sheet Title:; File Name:; /Project Architecture/ Sheet Path: Project Architecture Comments:; Git Hash: 5b68472; {RS422_TTL}; {SWD}; {LED}; BOARD_VERSION; MOTOR_FAULT; MOTOR_ENABLE; MOTOR_HIZ; {CURRENT_SENSE}; {PWM_PHASE}; {DRV_SPI}; {AUX1}; {AUX2}; {FDCAN_TTL}; {SENSE_TEMP}; SENSE_VBAT; FAN_CTRL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

Motor Control - Top Level File: Motor Control - Top Level.kicad_sch

File: Sensing - Battery.kicad_sch
Sensing - Temperature

File: Sensing - Temperature.kicad_sch
Sensing - Position

File: Sensing - Position.kicad_sch

Interface - Interconnects File: Interface - Interconnects.kicad_sch

User - LED Indicators File: User - LED Indicators.kicad_sch

Misc - Board Version, DAC

File: Misc - Board Version DAC.kicad_sch

File: Interface - RS-422.kicad_sch
Interface - FD-CAN

Misc - Holes, Fiducials File: Misc - Holes Fiducials.kicad_sch

File: Interface - FD-CAN.kicad_sch

Interface - Fan Control File: Interface - Fan Control.kicad_sch

File: MCU - IOs.kicad_sch

Revision: 1.1.1+ (Unreleased) Date: Project Name: 2023-12-22 Reviewer: Designer:
