RRichard67/amulet_controller_kibot/Schematic/amulet_controller-schematic-4.pdf

+3V3 | Power
VBAT 1 | VSS 15

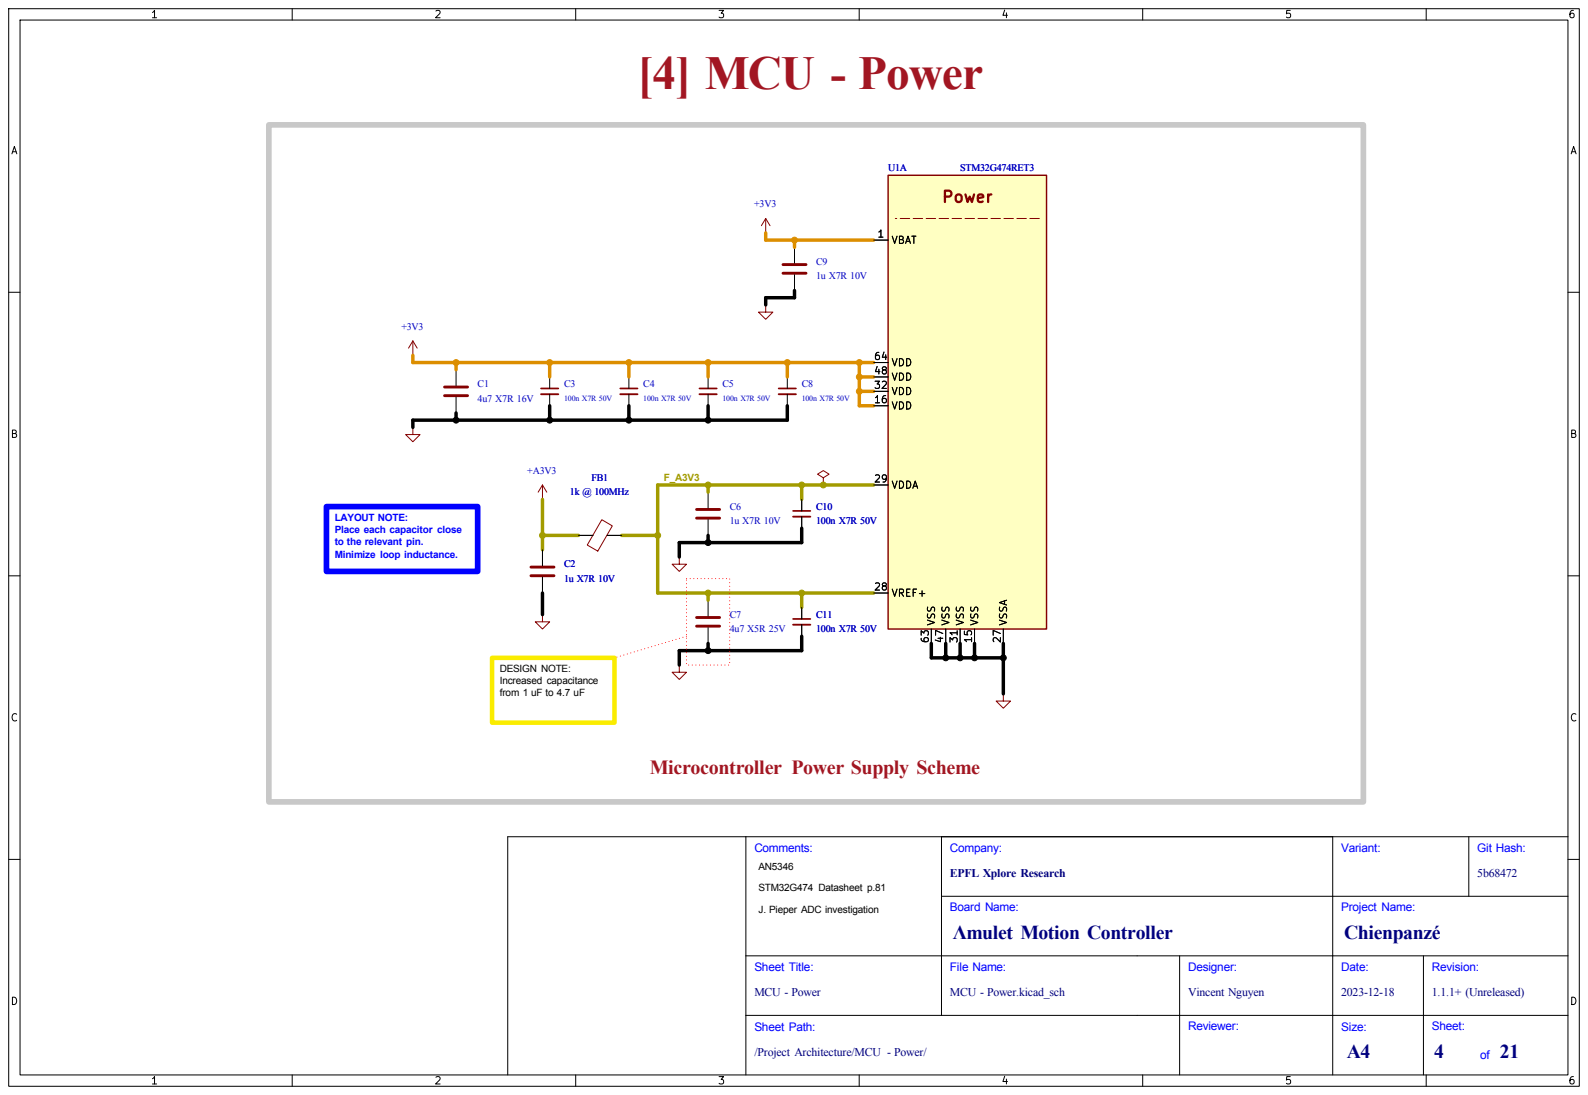
[picture p36: page 1]

LAYOUT NOTE: Place each capacitor close

J. Pieper ADC investigation (https://jpieper.com/2023/07/24/stm32g4-adc-performance-part-2/) STM32G474 Datasheet p.81 C2

DESIGN NOTE:
Increased capacitance
from 1 uF to 4.7 uF

Microcontroller Power Supply Scheme
