RRichard67/amulet_controller_kibot/Schematic/amulet_controller-schematic-5.pdf

# I/O PORT A PORT B

PC13 2 PC14 3 PC15 4 PF0 5 PF1 6 PG10 7 PC0 8 PC1 9 PC2 10 PC3 11 | PA0 12 PA1 13 PA2 14 PA3 17 PA4 18 PA5 19 PA6 20 PA7 21 PC4 22 PC5 23 | PB0 24 PB1 25 PB2 26 PB10 30 PB11 33 PB12 34 PB13 35 PB14 36 PB15 37 PC6 38 PC7 39 PC8 40 PC9 41 | PA8 42 PA9 43 PA10 44 PA11 45 PA12 46 PA13 49 PA14 50 | PA15 51 PC10 52 PC11 53 PC12 54 PD2 55 | PB3 56 PB4 57 PB5 58 PB6 59 PB7 60 PB8 61 PB9 62

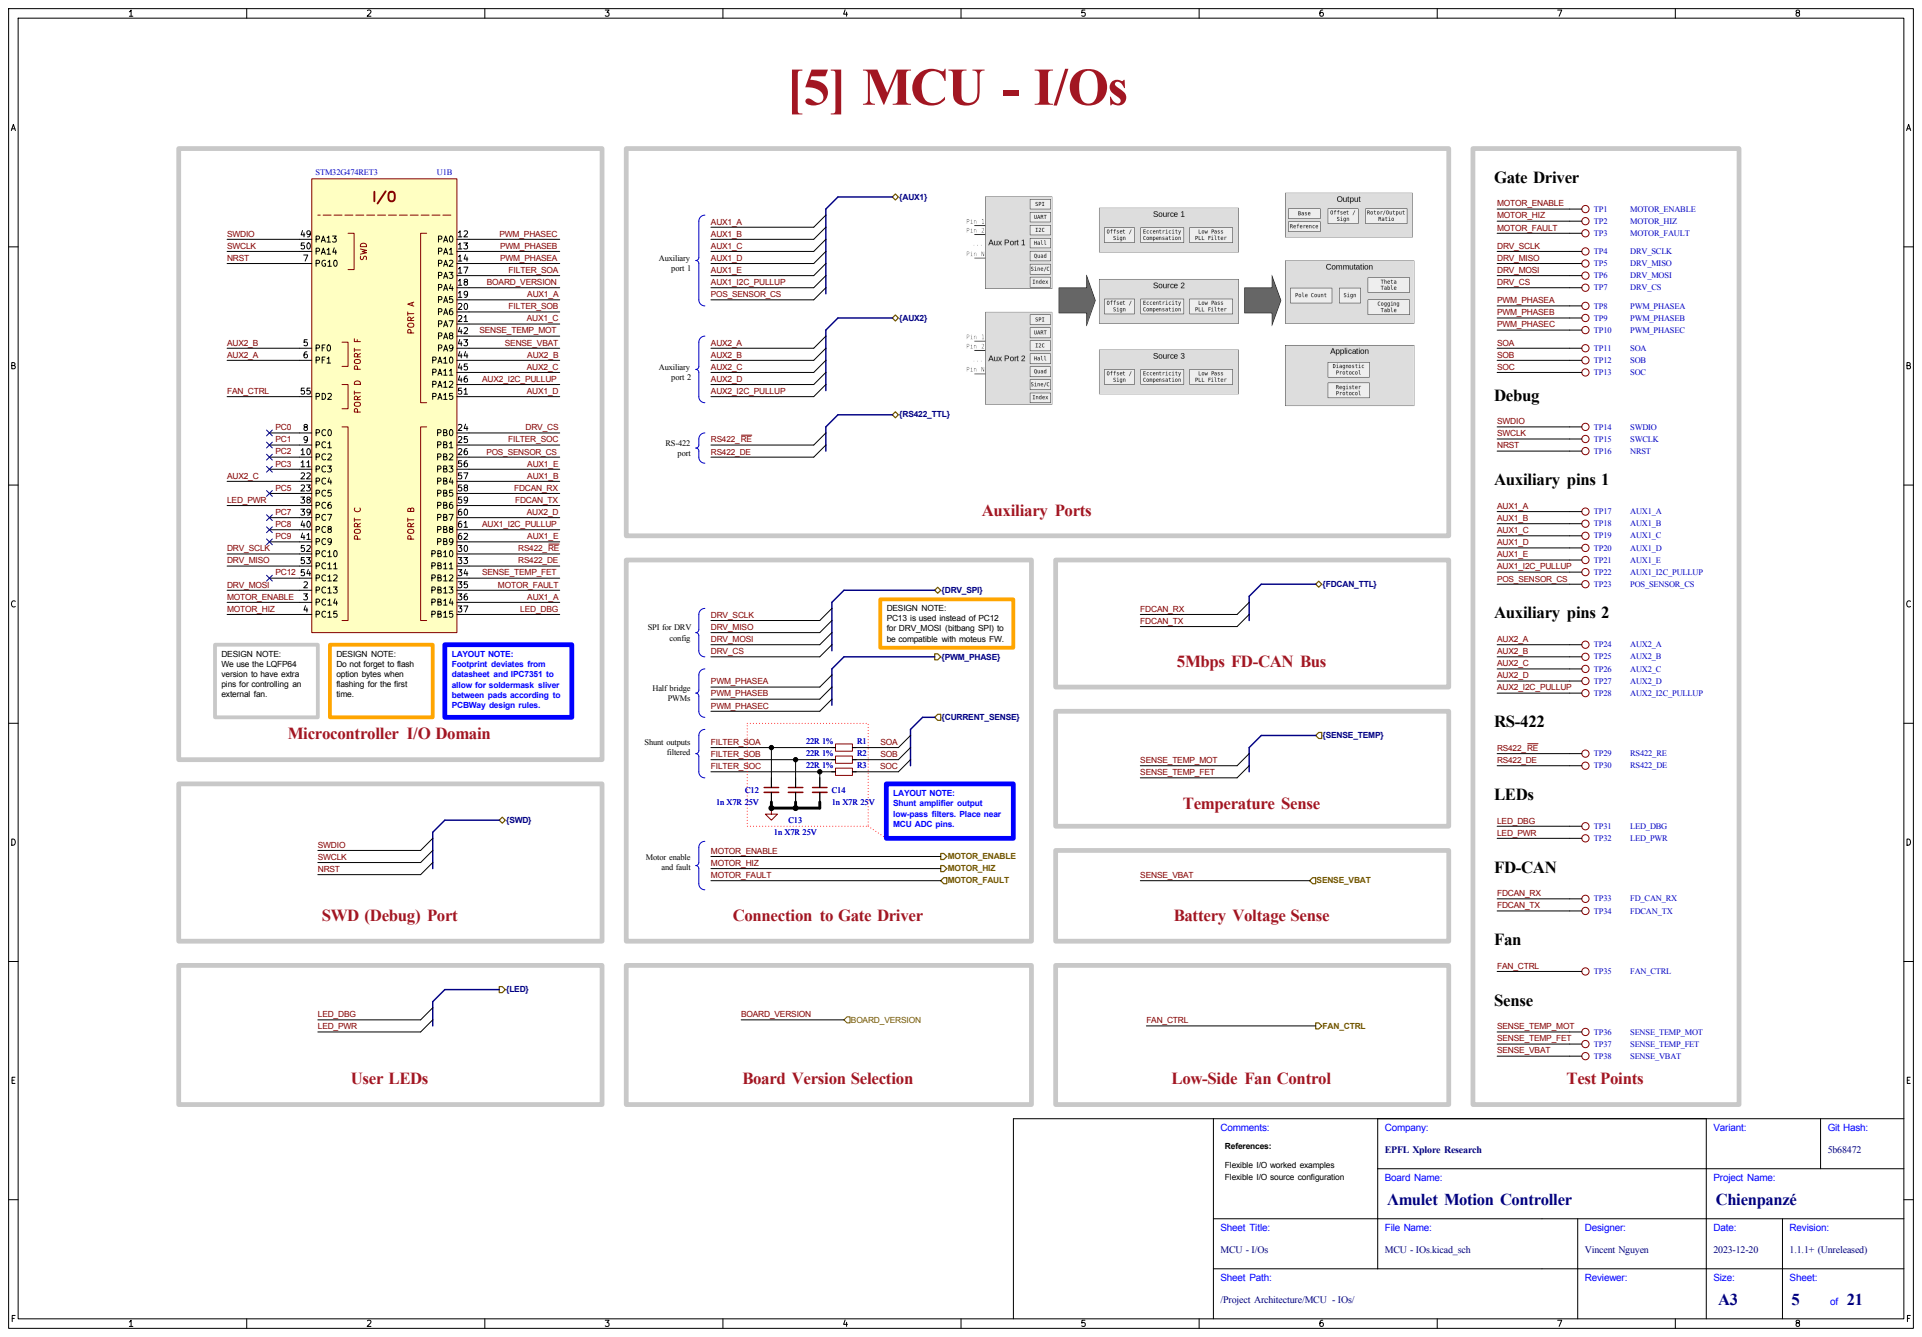
[picture p37: page 1]

for DRV_MOSI (bitbang SPI) to

DESIGN NOTE: We use the LQFP64

allow for soldermask sliver between pads according to PCBWay design rules. DESIGN NOTE: Do not forget to flash

LAYOUT NOTE: Footprint deviates from

version to have extra
pins for controlling an

option bytes when
flashing for the first

LAYOUT NOTE: Shunt amplifier output

low-pass filters. Place near MCU ADC pins.

Connection to Gate Driver

Low-Side Fan Control

Flexible I/O worked examples (https://jpieper.com/2022/06/30/flexible-i-o-worked-examples/) Flexible I/O source configuration References:
