RRichard67/amulet_controller_kibot/Schematic/amulet_controller-schematic-6.pdf

# 100n X7R 50V NT1 FB_5V

# [6] Power - Generation

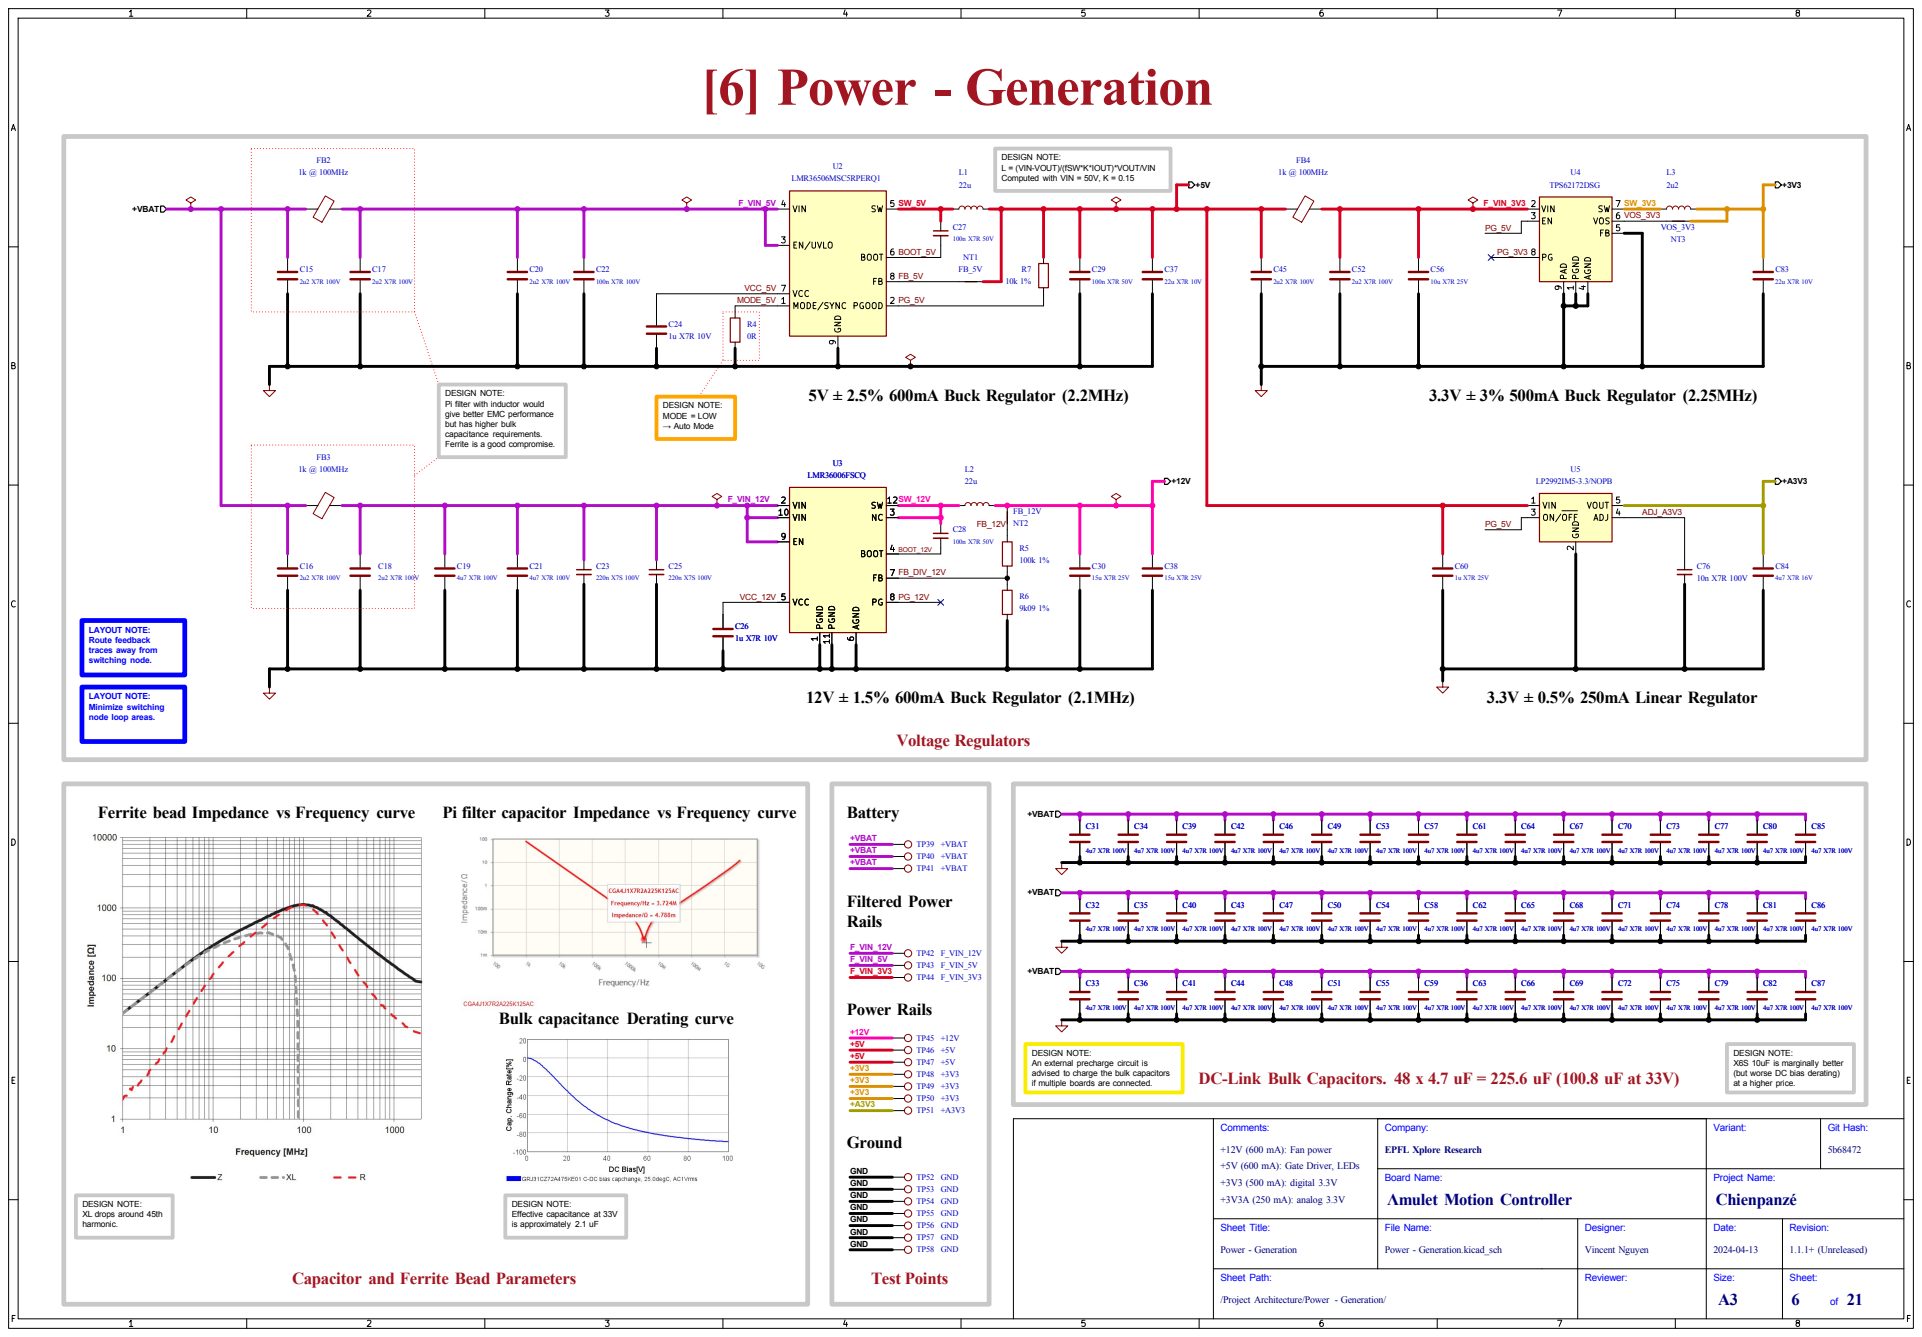
[picture p38: page 1]

Computed with VIN = 50V, K = 0.15 Power Rails

3.3V ± 3% 500mA Buck Regulator (2.25MHz) DESIGN NOTE: L = (VIN-VOUT)/(fSW*K*IOUT)*VOUT/VIN

DESIGN NOTE: Pi filter with inductor would

give better EMC performance
but has higher bulk
capacitance requirements. Ferrite is a good compromise.

node loop areas. LAYOUT NOTE: Route feedback

LAYOUT NOTE: Minimize switching

Bulk capacitance Derating curve

DESIGN NOTE: An external precharge circuit is advised to charge the bulk capacitors

DESIGN NOTE: X6S 10uF is marginally better

(but worse DC bias derating) at a higher price. DESIGN NOTE: XL drops around 45th

if multiple boards are connected. DESIGN NOTE: Effective capacitance at 33V

/Project Architecture/Power - Generation/ Sheet Path: Power - Generation Comments: +12V (600 mA): Fan power +5V (600 mA): Gate Driver, LEDs +3V3 (500 mA): digital 3.3V
