RRichard67/amulet_controller_kibot/Schematic/amulet_controller-schematic-7.pdf

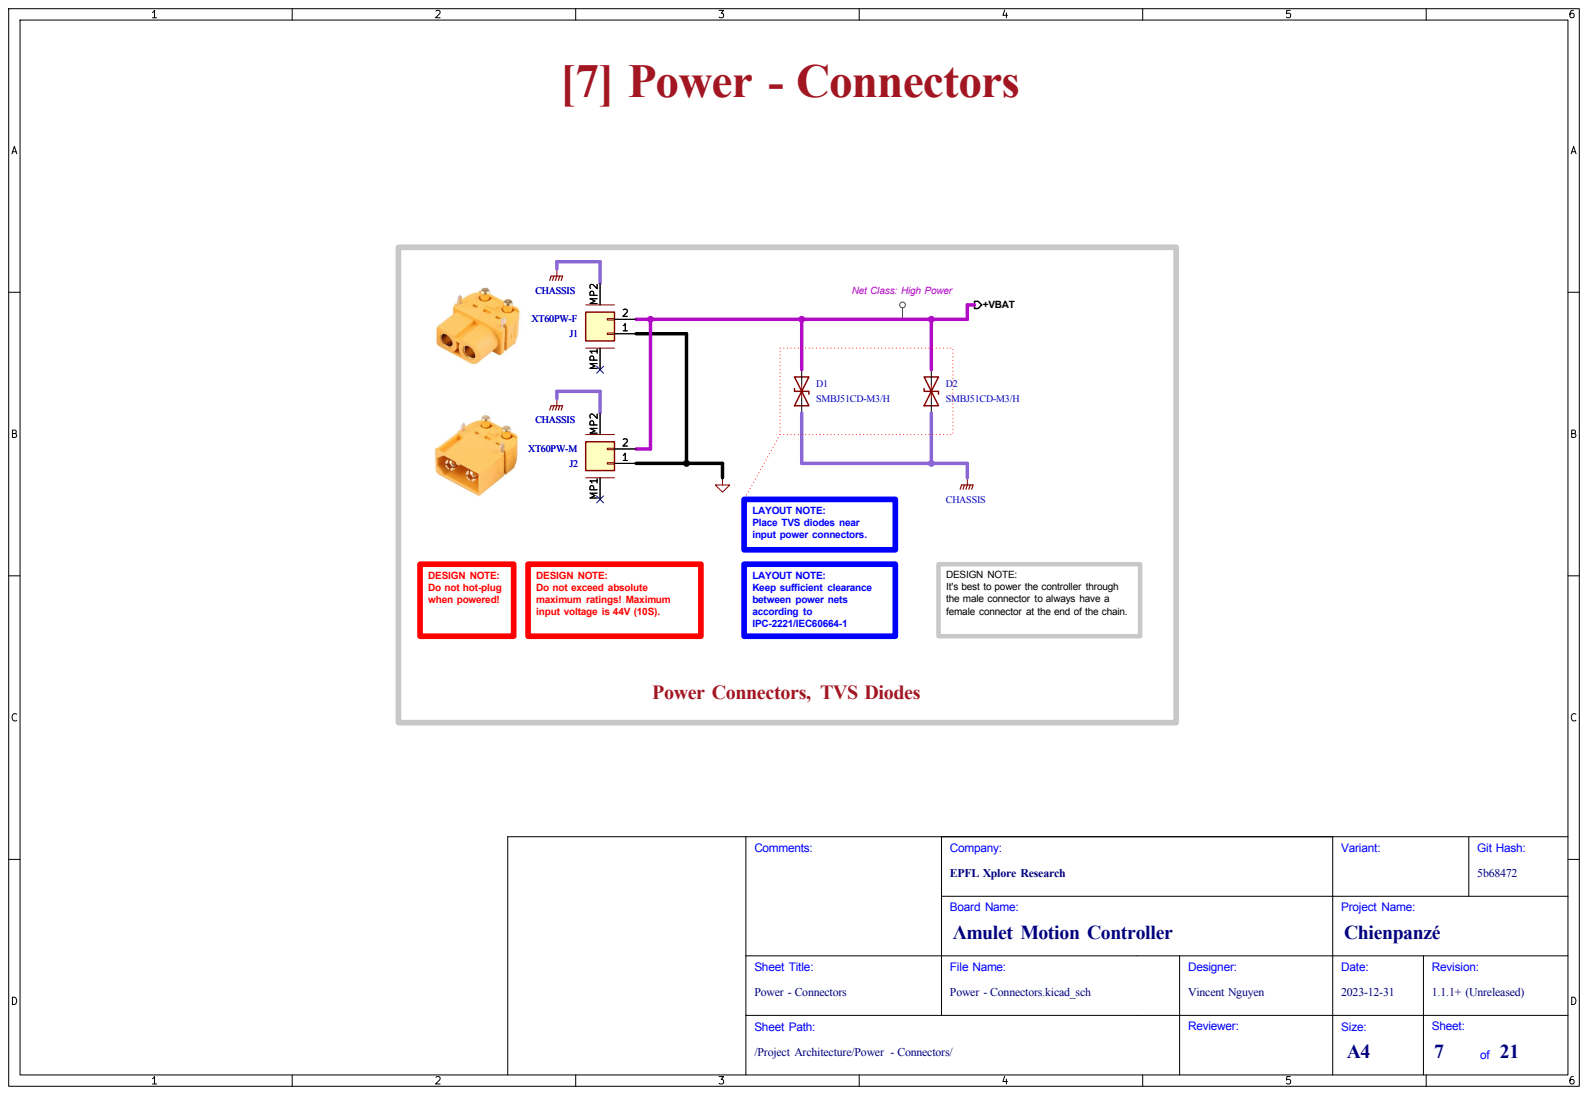
[picture p39: page 1]
Sheet: of 21; Size: A4; Revision: 1.1.1+ (Unreleased) Date: Project Name: 2023-12-31 Reviewer: Designer: Power - Connectors.kicad_sch; Vincent Nguyen Board Name: Company:; Variant: EPFL Xplore Research Λmulet Motion Controller; Chienpanzé; Sheet Title:; File Name:; /Project Architecture/Power - Connectors/ Sheet Path: Power - Connectors Comments:; Git Hash: 5b68472; D2 SMBJ51CD-M3/H; CHASSIS 1; CHASSIS; D1 SMBJ51CD-M3/H; Net Class: High Power; +VBAT; according to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

female connector at the end of the chain. [7] Power - Connectors

input voltage is 44V (10S). J2 XT60PW-M

LAYOUT NOTE: Place TVS diodes near

input power connectors. Power Connectors, TVS Diodes

LAYOUT NOTE: Keep sufficient clearance between power nets

DESIGN NOTE:
It's best to power the controller through
the male connector to always have a
