RRichard67/amulet_controller_kibot/Schematic/amulet_controller-schematic-8.pdf

+3V3 C89

# [8] Motor Control - Top Level

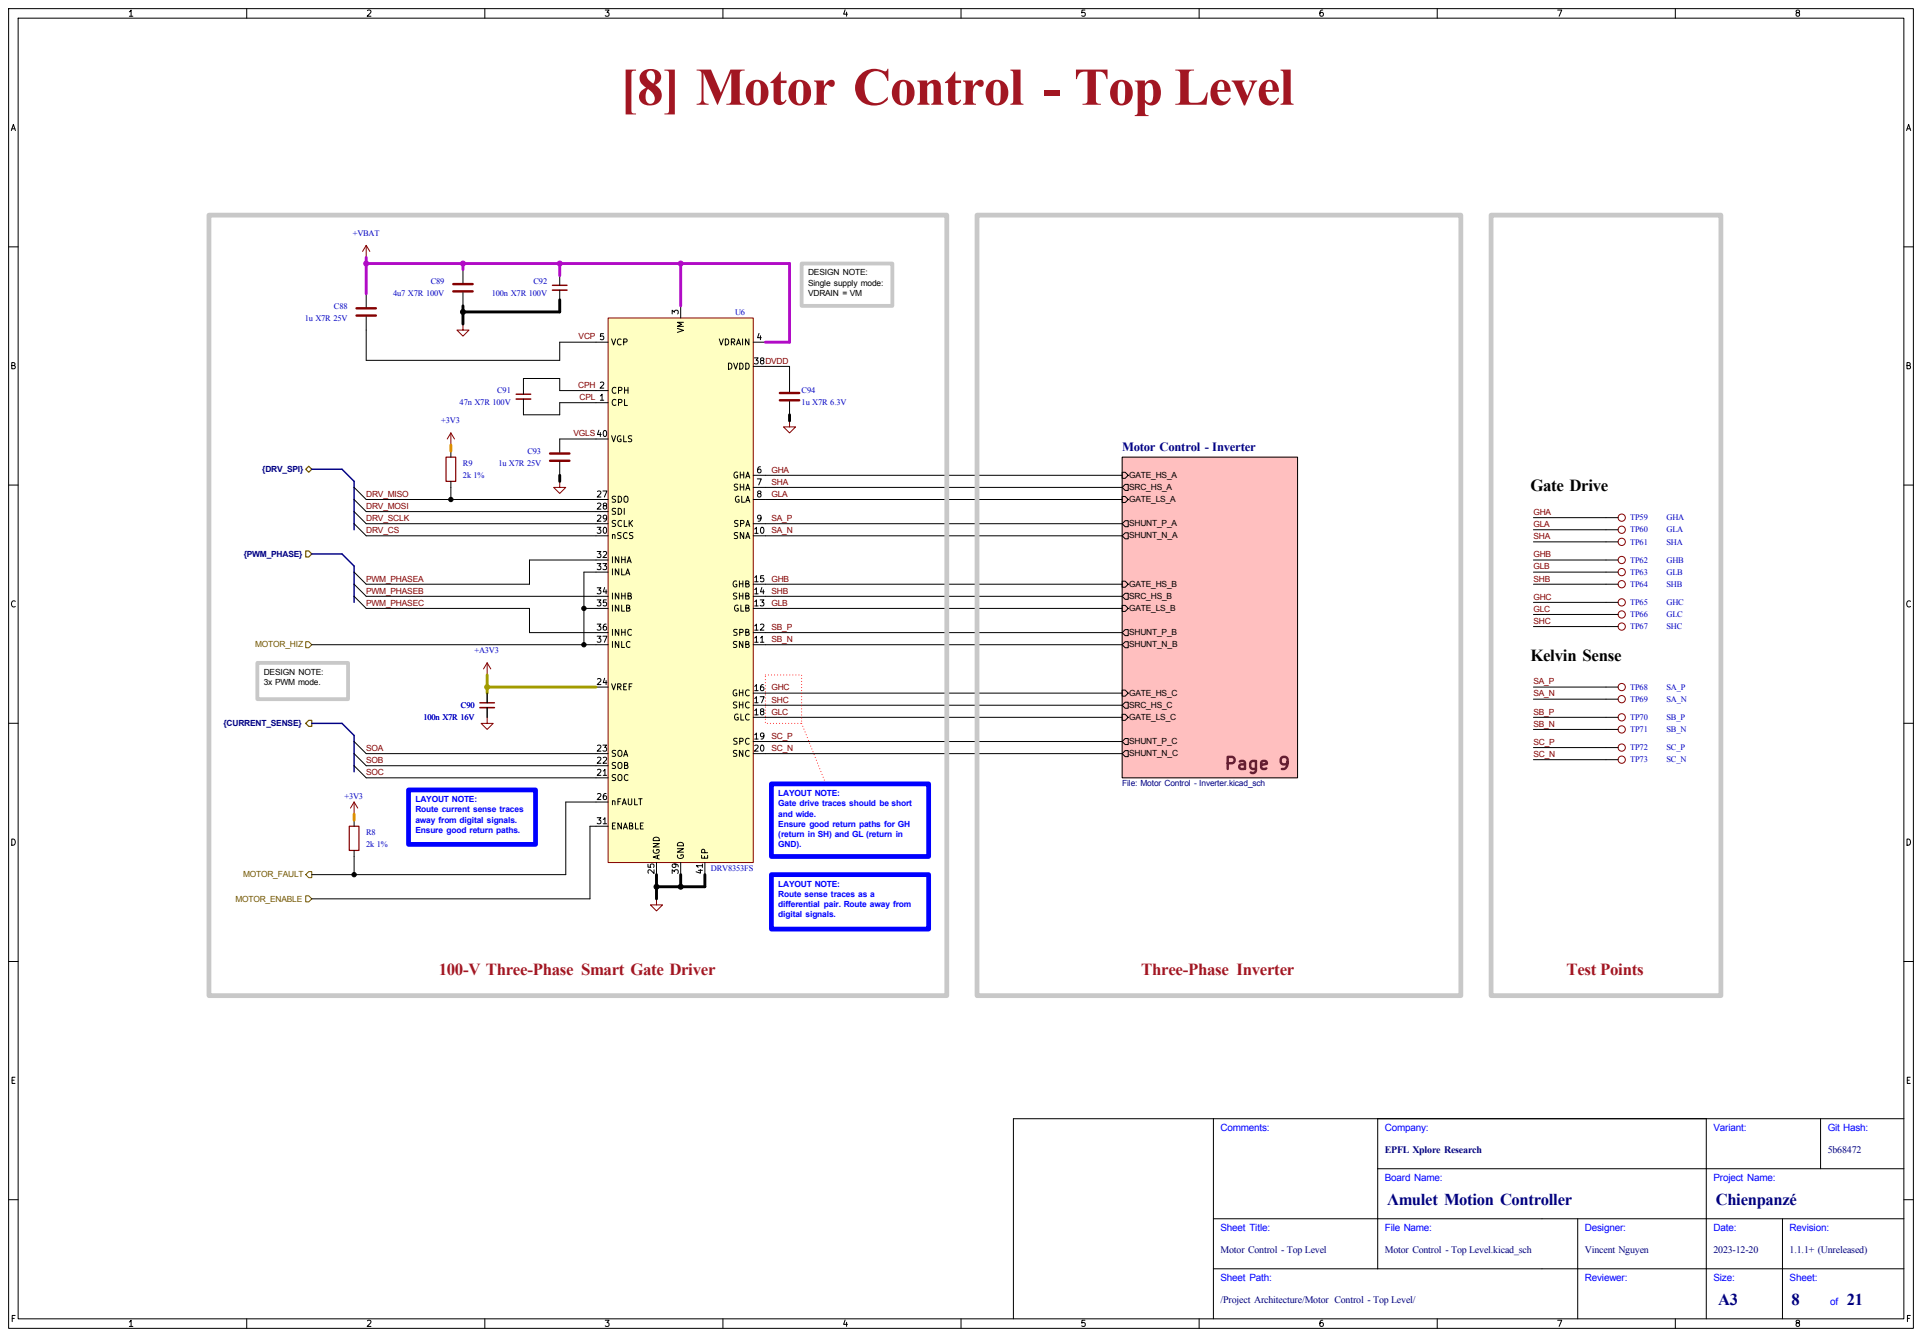
[picture p40: page 1]

SNB 11 SPB 12 GLB 13 SHB 14 GHB 15 GHC 16
SC_N GLB GLC

LAYOUT NOTE: Route current sense traces

away from digital signals. Ensure good return paths.

(return in SH) and GL (return in GND).

LAYOUT NOTE: Route sense traces as a differential pair. Route away from

100-V Three-Phase Smart Gate Driver
