RRichard67/amulet_controller_kibot/Schematic/amulet_controller-schematic-9.pdf

to IPC-2221/IEC60664-1. | [9] Motor Control - Inverter

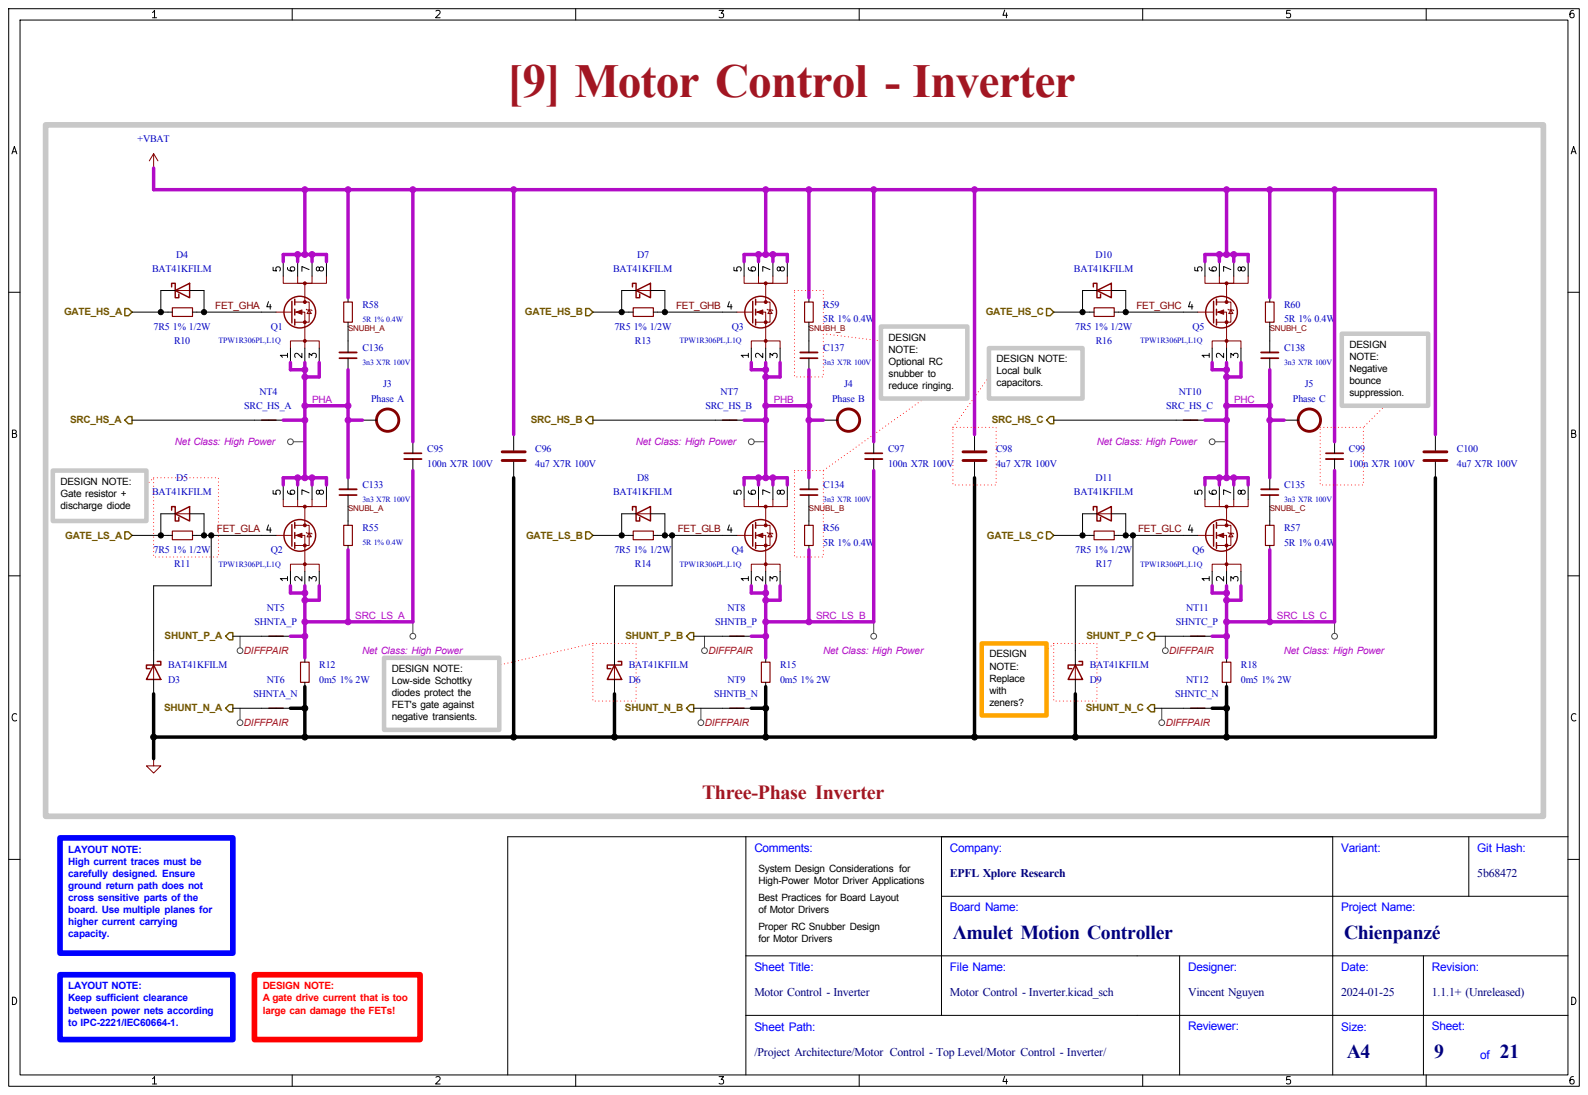
[picture p41: page 1]

J4 Phase B NT5 SHNTA_P NT6 SHNTA_N
reduce ringing. DESIGN NOTE: A gate drive current that is too

negative transients. DESIGN NOTE: Gate resistor +

DESIGN NOTE: Low-side Schottky diodes protect the FET's gate against

zeners? Proper RC Snubber Design

LAYOUT NOTE: High current traces must be

carefully designed. Ensure ground return path does not cross sensitive parts of the board. Use multiple planes for higher current carrying

for Motor Drivers (https://e2e.ti.com/support/motor-drivers-group/motor-drivers/f/motor-drivers-forum/991693/faq-proper-rc-snubber-design-for-motor-drivers) Best Practices for Board Layout of Motor Drivers System Design Considerations for High-Power Motor Driver Applications

large can damage the FETs! LAYOUT NOTE: Keep sufficient clearance between power nets according
