RRichard67/amulet_controller_kibot/Manufacturing/Assembly/amulet_controller-assembly-1.pdf

# Λmulet Motion Controller Assembly Document

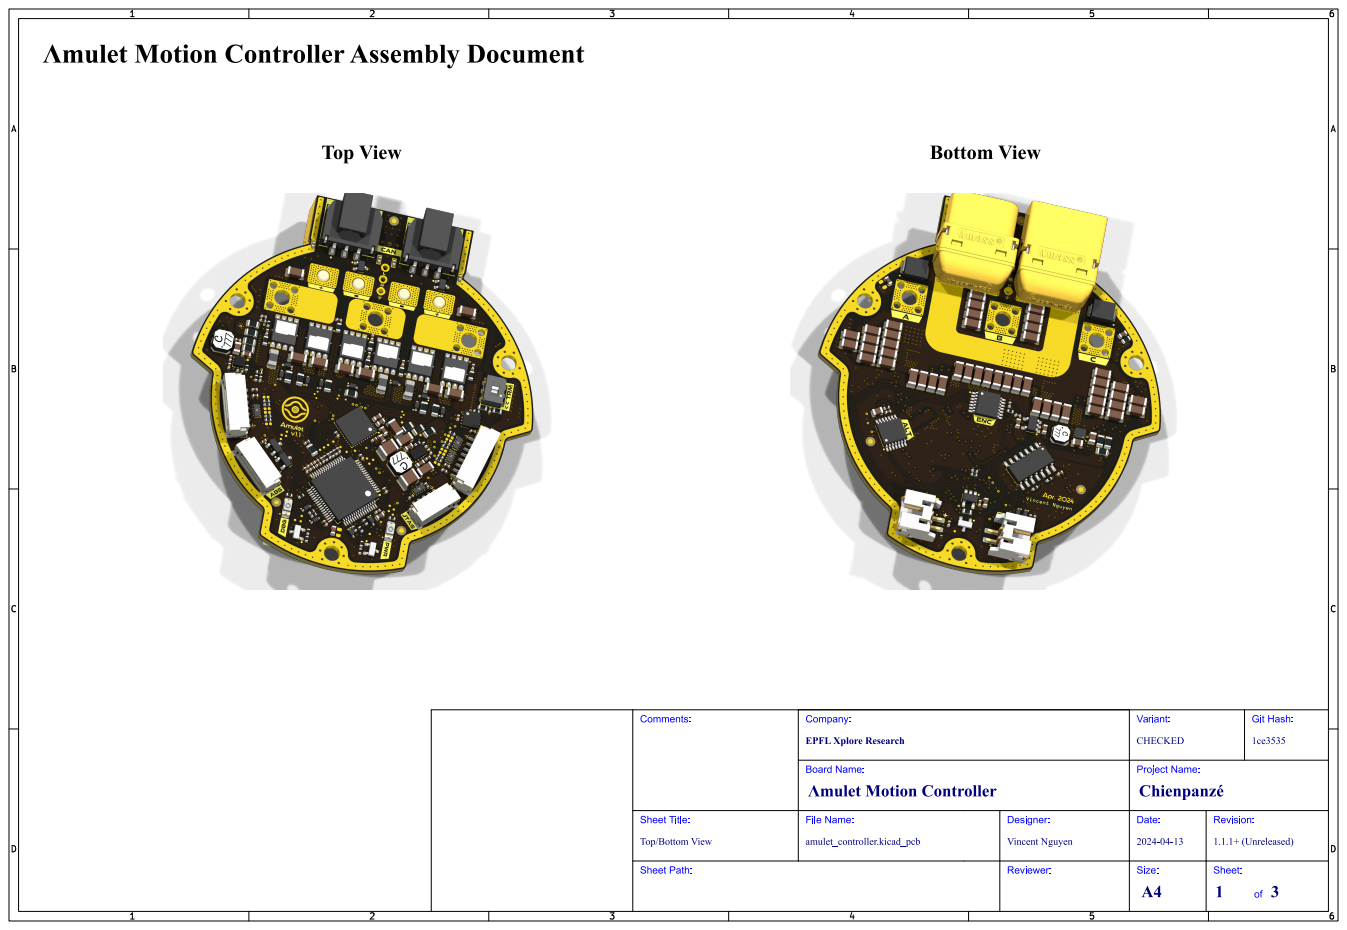
[picture p42: page 1]
Git; Hash:; Comments:; Sheet Path:; Sheet Title:; File Name:; Λmulet Motion Controller; Chienpanzé; Company:; CHECKED; Variant:; Board Name:; amulet_controller.kicad_pcb; Vincent Nguyen; Designer:; Reviewer:; Project Name:; Date:; 1.1.1+ (Unreleased); Revision:; Size:; Sheet: 1

EPFL Xplore Research

Top/Bottom View
