RRichard67/amulet_controller_kibot/Manufacturing/Assembly/amulet_controller-assembly-2.pdf

# Top Assembly (Scale 1:1)

# Λmulet Motion Controller Assembly Document

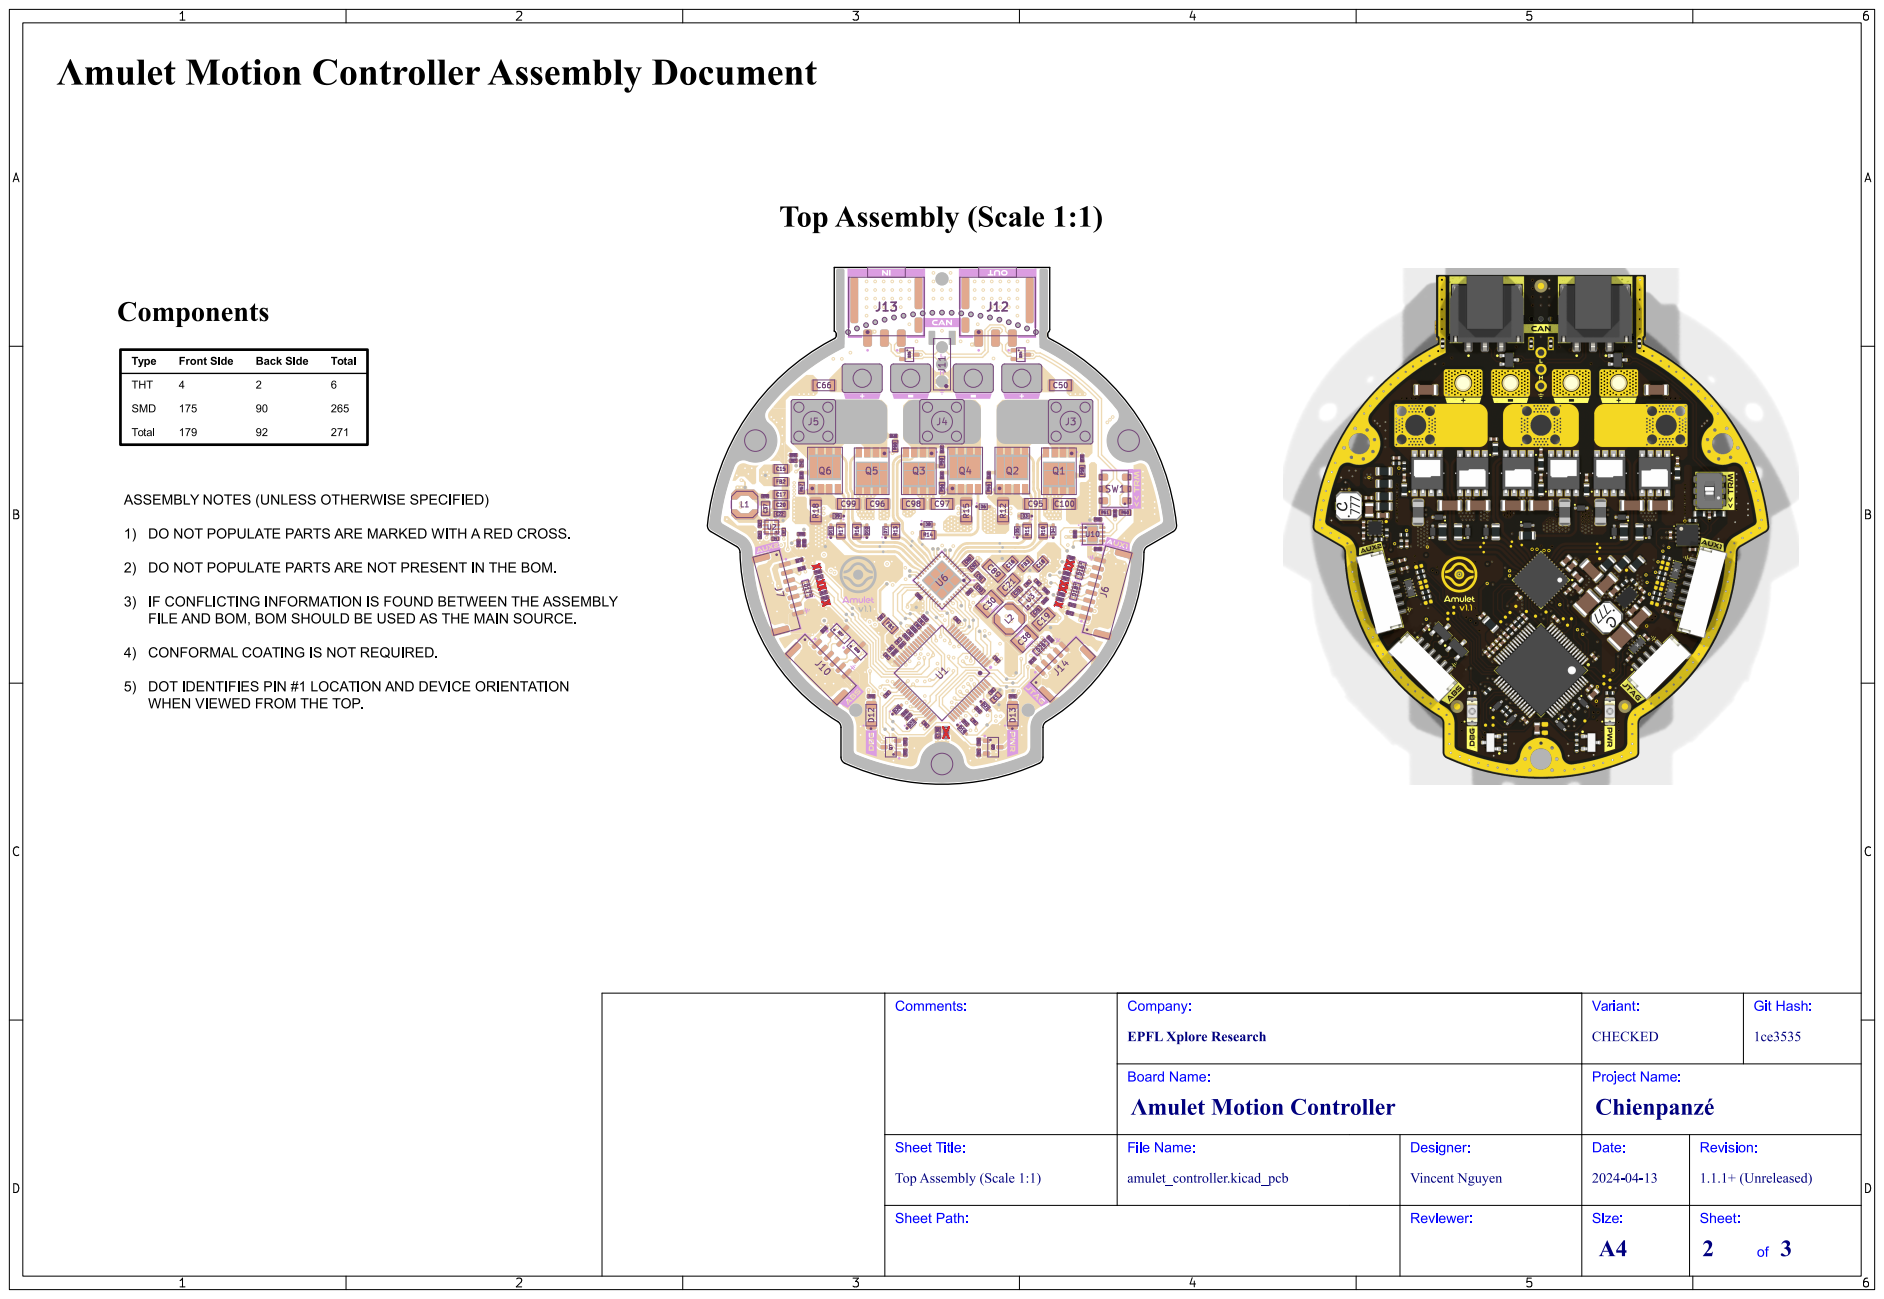
[picture p43: page 1]
