RRichard67/amulet_controller_kibot/Manufacturing/Assembly/amulet_controller-assembly-3.pdf

# Bottom Assembly (Scale 1:1)

# Λmulet Motion Controller Assembly Document

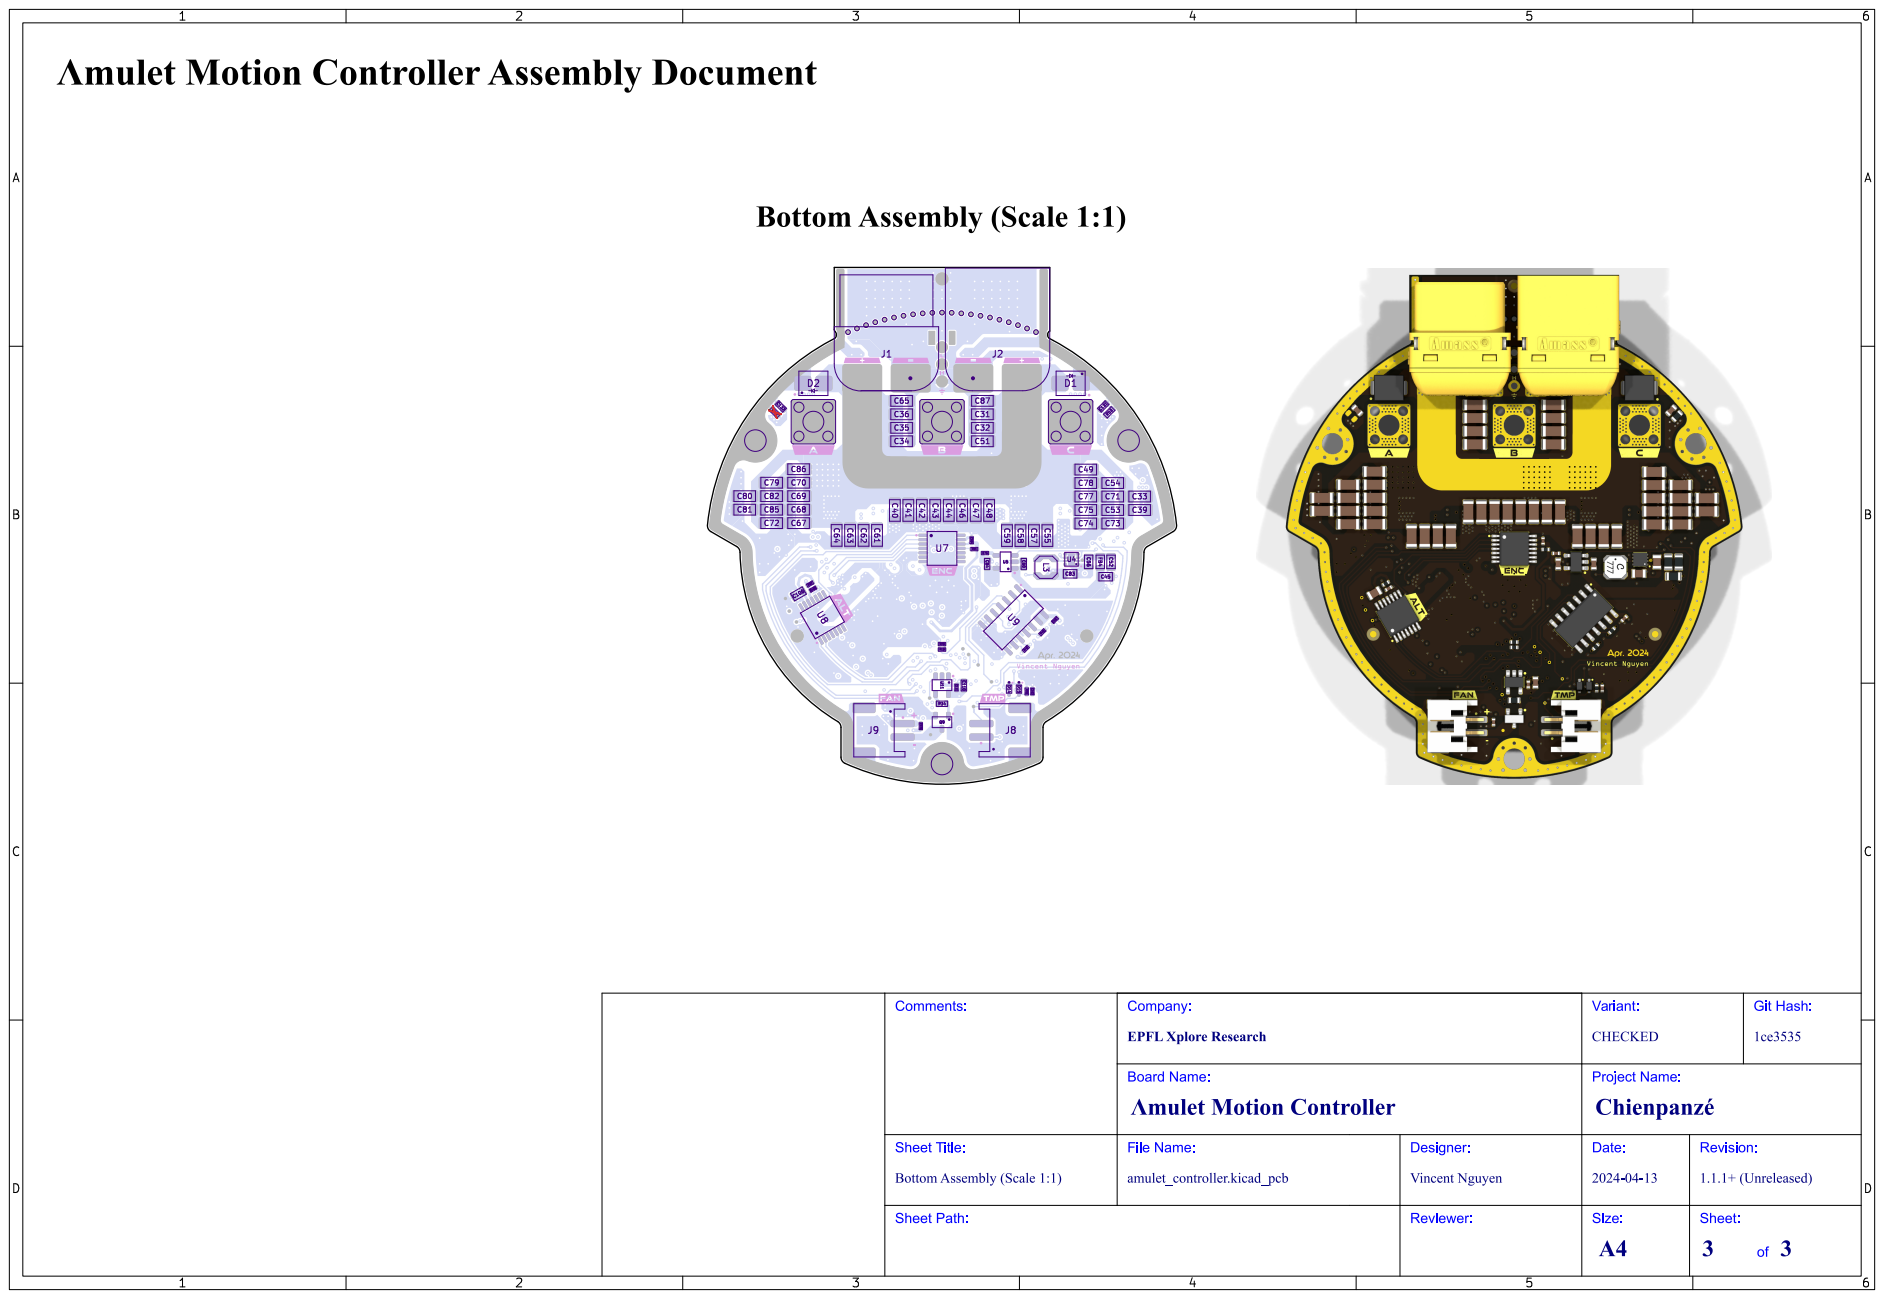
[picture p44: page 1]
