RRichard67/amulet_controller_kibot/Manufacturing/Assembly/amulet_controller-assembly.pdf

# Λmulet Motion Controller Assembly Document

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

EPFL Xplore Research

Top/Bottom View

# Top Assembly (Scale 1:1)

# Λmulet Motion Controller Assembly Document


# Bottom Assembly (Scale 1:1)

# Λmulet Motion Controller Assembly Document
