RRichard67/amulet_controller_kibot/Manufacturing/Fabrication/amulet_controller-fabrication-12.pdf

# L6 (Sig, PWR) (Scale 1:1)

# Λmulet Motion Controller Fabrication Document

Git; Hash:; Comments:; Sheet Path:; Sheet Title:; File Name:; Λmulet Motion Controller; Chienpanzé; Company:; CHECKED; Variant:; Board Name:; amulet_controller.kicad_pcb; Vincent Nguyen; Designer:; Reviewer:; Project Name:; Date:; 1.1.1+ (Unreleased); Revision:; Size:; Sheet: 12

EPFL Xplore Research

L6 (Sig, PWR) (Scale 1:1)
