RRichard67/amulet_controller_kibot/Manufacturing/Fabrication/amulet_controller-fabrication-5.pdf

# Top Test Points (Scale 1:1)

# Λmulet Motion Controller Fabrication Document


Top Test Points (Scale 1:1)
