RRichard67/amulet_controller_kibot/Manufacturing/Fabrication/amulet_controller-fabrication-6.pdf

# Bottom Test Points (Scale 1:1)

# Λmulet Motion Controller Fabrication Document


Bottom Test Points (Scale 1:1)
