RRichard67/amulet_controller_kibot/Manufacturing/Fabrication/Gerbers/amulet_controller-NPTH_drill_map.pdf

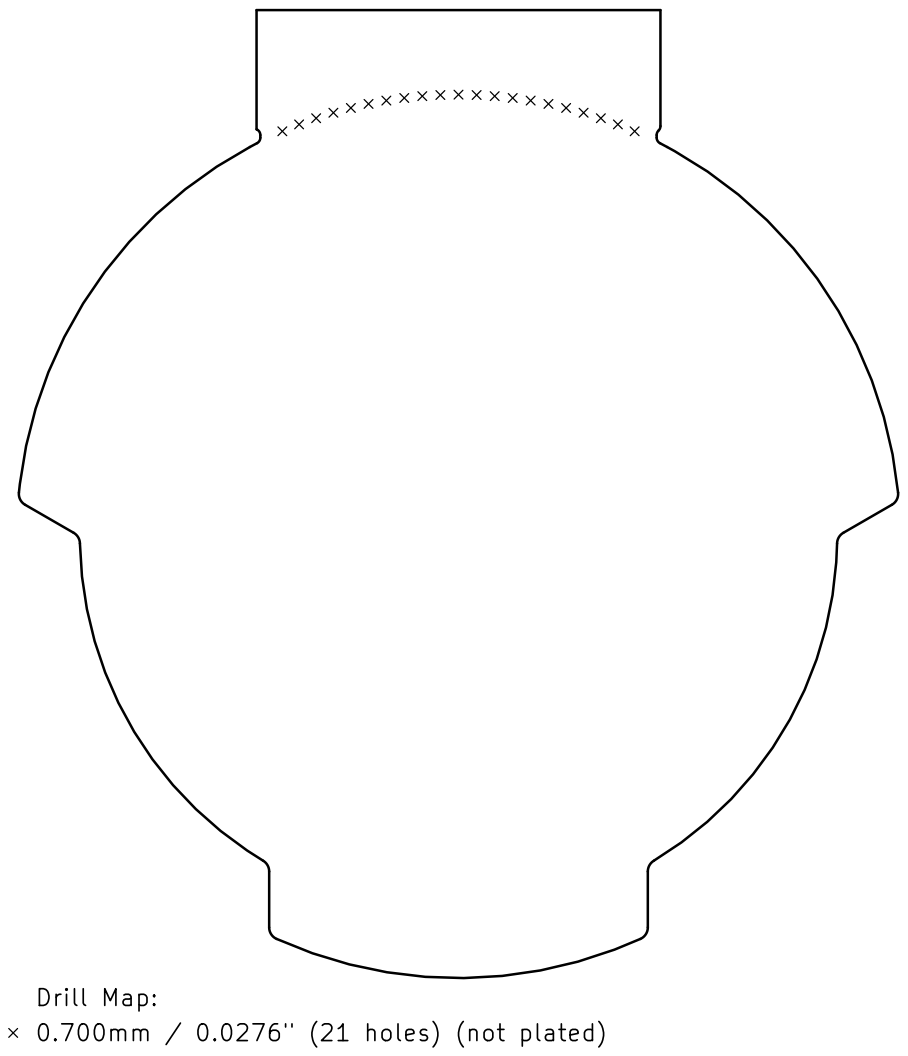
[picture p45: page 1]
