RRichard67/amulet_controller_kibot/Manufacturing/Fabrication/Gerbers/amulet_controller-PTH_drill_map.pdf

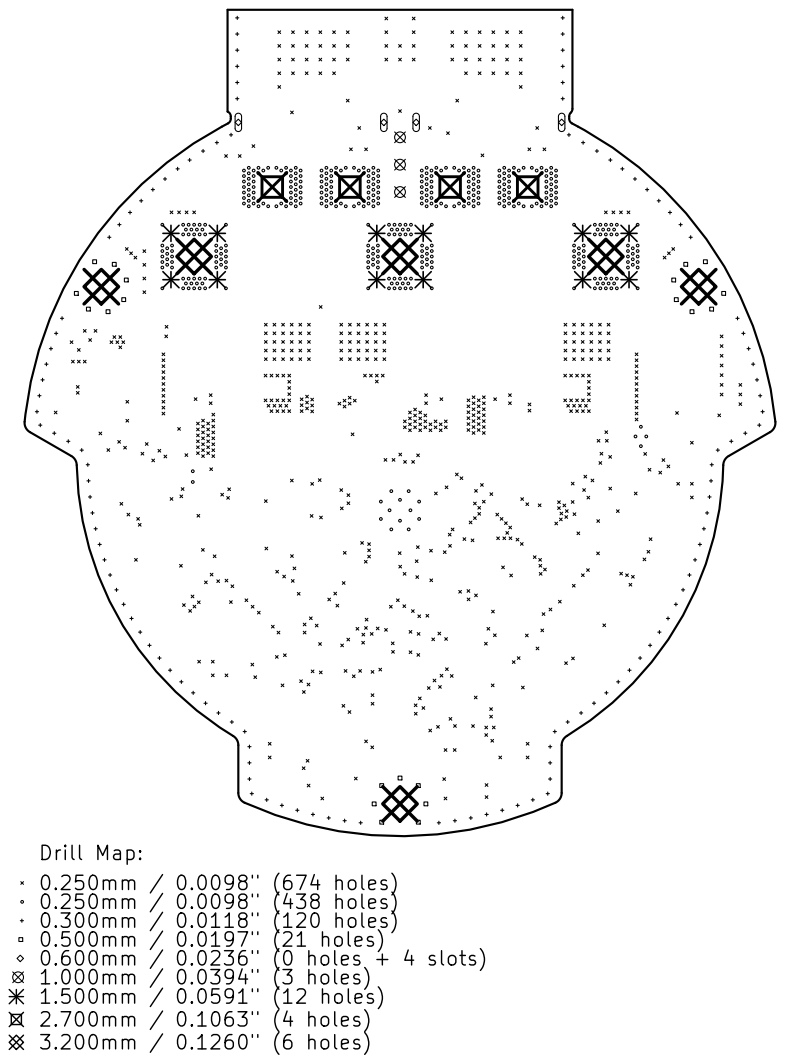
[picture p46: page 1]
