RRichard67/amulet_controller_kibot/amulet_controller.kicad_pcb

## KiCad design amulet_controller.kicad_pcb (2026-08-17)

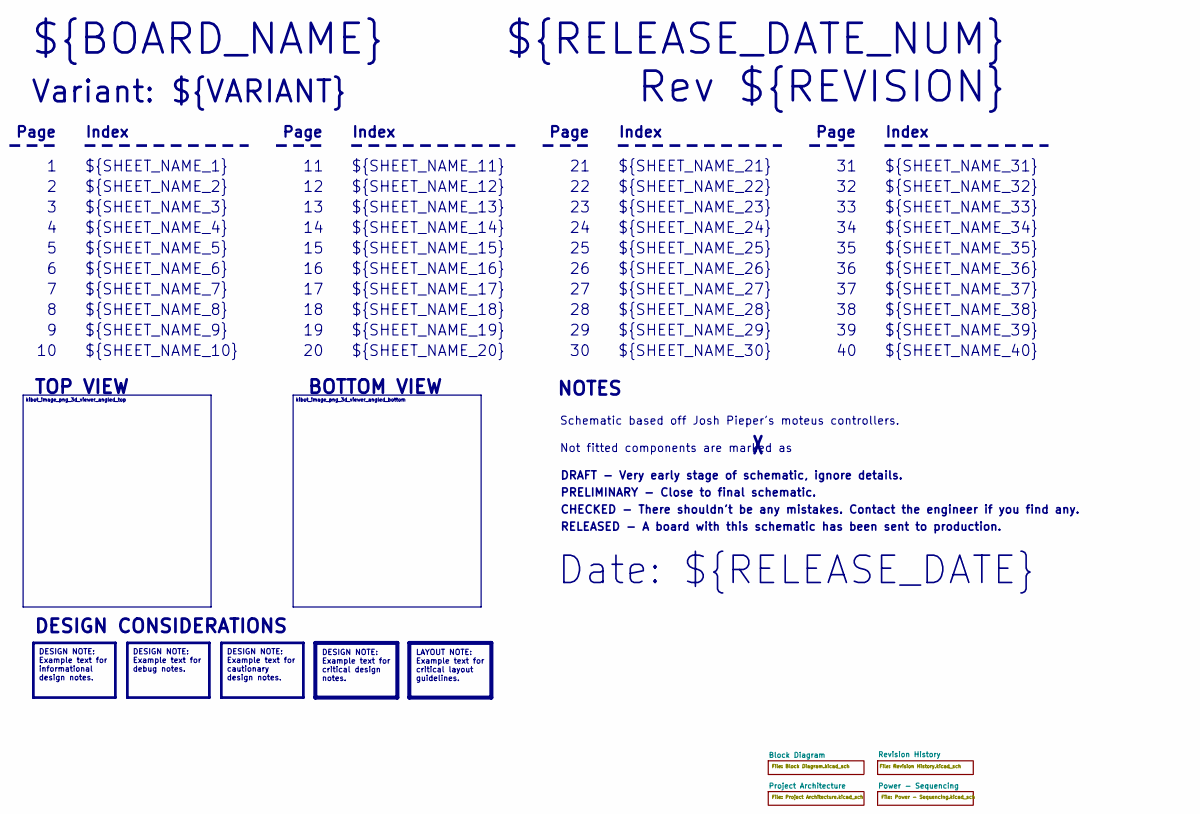
[picture p47: schematic amulet_controller.kicad_sch, Cover Page]

Notes on the sheet:
BOTTOM VIEW
${SHEET_NAME_23}
${SHEET_NAME_10}
RELEASED - A board with this schematic has been sent to production.
${SHEET_NAME_13}
Page
TOP VIEW
${SHEET_NAME_15}
${SHEET_NAME_7}
Not fitted components are marked as
${SHEET_NAME_30}
Index
${SHEET_NAME_18}
PRELIMINARY - Close to final schematic.
Date: ${RELEASE_DATE}
${SHEET_NAME_4}
${SHEET_NAME_27}
${SHEET_NAME_20}
${SHEET_NAME_38}
${SHEET_NAME_9}
${SHEET_NAME_12}
${SHEET_NAME_40}
${SHEET_NAME_19}
${SHEET_NAME_32}
${RELEASE_DATE_NUM}
Variant: ${VARIANT}
${SHEET_NAME_11}
${SHEET_NAME_8}
Rev ${REVISION}
${SHEET_NAME_24}
${SHEET_NAME_29}
${SHEET_NAME_22}
${SHEET_NAME_39}
${SHEET_NAME_5}
${SHEET_NAME_17}
${SHEET_NAME_28}
${SHEET_NAME_31}
${BOARD_NAME}
${SHEET_NAME_26}
${SHEET_NAME_34}
${SHEET_NAME_6}
${SHEET_NAME_21}
DRAFT - Very early stage of schematic, ignore details.
${SHEET_NAME_36}
${SHEET_NAME_35}
${SHEET_NAME_2}
${SHEET_NAME_16}
${SHEET_NAME_25}
Schematic based off Josh Pieper's moteus controllers.
${SHEET_NAME_33}
${SHEET_NAME_1}
${SHEET_NAME_14}
NOTES
${SHEET_NAME_3}
CHECKED - There shouldn't be any mistakes. Contact the engineer if you find any.
${SHEET_NAME_37}
DESIGN CONSIDERATIONS
DESIGN NOTE: Example text for informational design notes.
LAYOUT NOTE: Example text for critical layout guidelines.
DESIGN NOTE: Example text for cautionary design notes.
DESIGN NOTE: Example text for debug notes.
DESIGN NOTE: Example text for critical design notes.
kibot_image_png_3d_viewer_angled_top
kibot_image_png_3d_viewer_angled_bottom

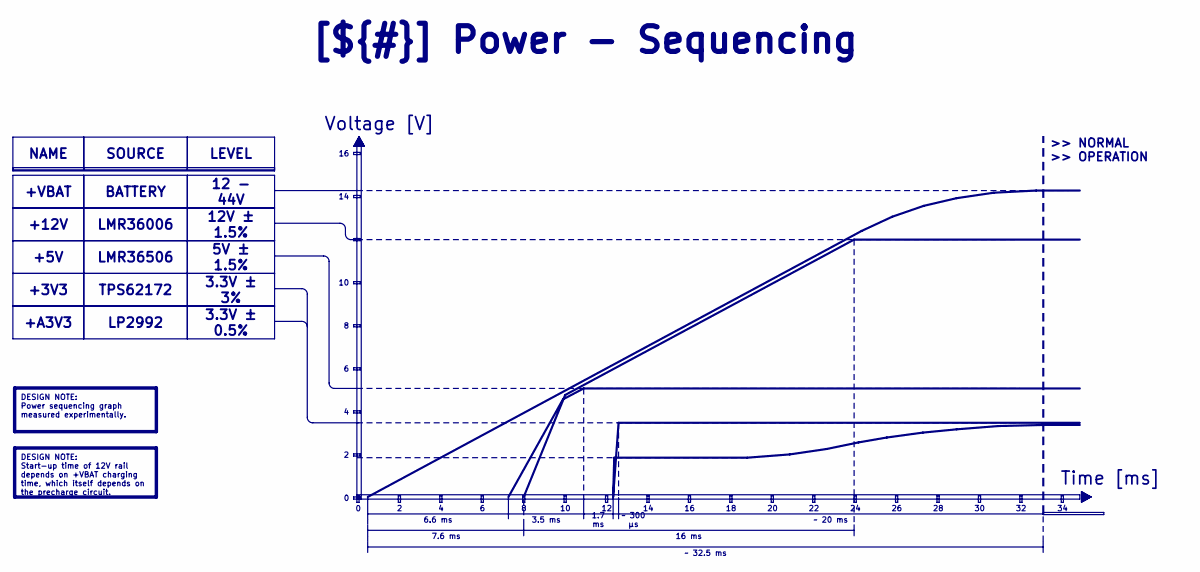
[picture p48: schematic Power - Sequencing.kicad_sch]

Notes on the sheet:
Voltage [V]
>> NORMAL >> OPERATION
Time [ms]
3.5 ms
7.6 ms
3.3V ± 0.5%
~ 300 μs
1.7 ms
16 ms
+12V
LP2992
LMR36006
LEVEL
NAME
DESIGN NOTE: Power sequencing graph measured experimentally.
+3V3
~ 20 ms
SOURCE
+5V
DESIGN NOTE: Start-up time of 12V rail depends on +VBAT charging time, which itself depends on the precharge circuit.
[${#}] ${TITLE}
TPS62172
LMR36506
BATTERY
5V ± 1.5%
3.3V ± 3%
+A3V3
+VBAT
6.6 ms
~ 32.5 ms
12V ± 1.5%
12 - 44V

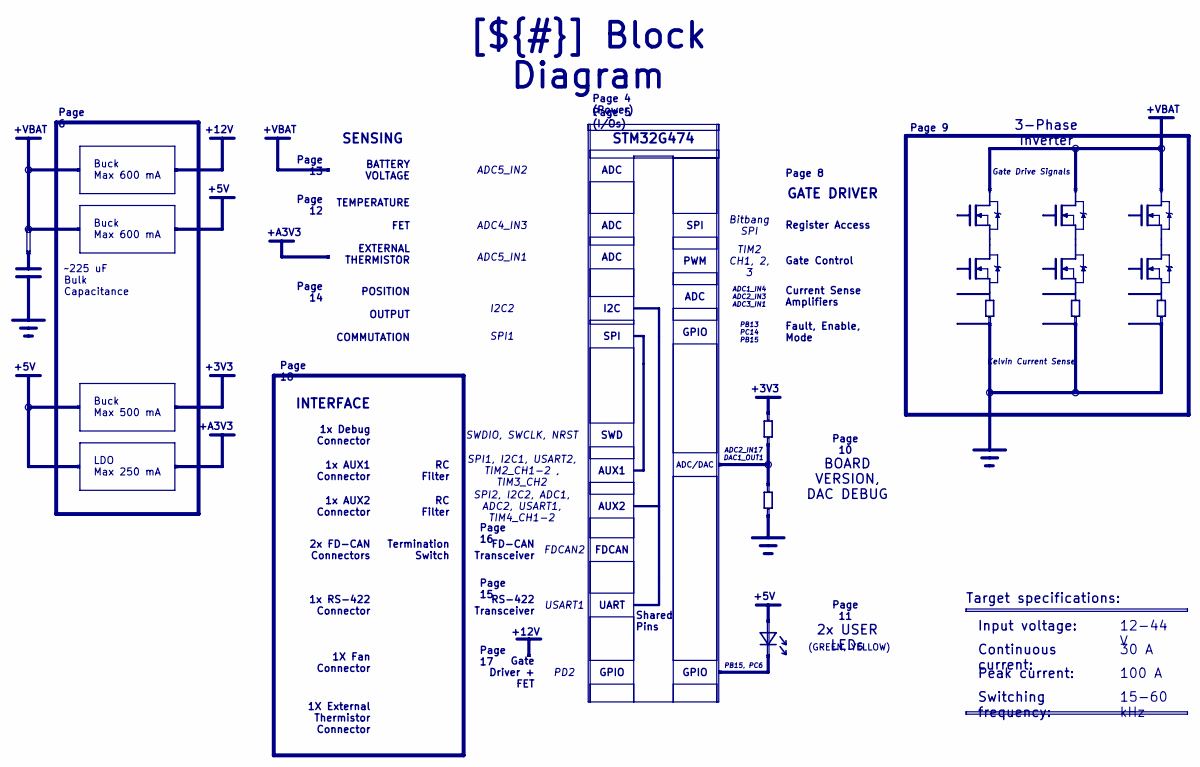
[picture p49: schematic Block Diagram.kicad_sch]

Notes on the sheet:
+5V
+12V
+3V3
+VBAT
+A3V3
INTERFACE
Peak current:
ADC
~225 uF Bulk Capacitance
AUX1
Continuous current:
ADC4_IN3
STM32G474
SPI1
BOARD VERSION, DAC DEBUG
Page 15
1x RS-422 Connector
Gate Driver + FET
LDO Max 250 mA
RC Filter
Page 8
Bitbang SPI
Page 9
Input voltage:
ADC5_IN2
15-60 kHz
Page 11
30 A
POSITION OUTPUT COMMUTATION
Shared Pins
ADC1_IN4 ADC2_IN3 ADC3_IN1
I2C2
GATE DRIVER
3-Phase Inverter
BATTERY VOLTAGE
Termination Switch
Buck Max 600 mA
1x AUX1 Connector
UART
Current Sense Amplifiers
SWDIO, SWCLK, NRST
RS-422 Transceiver
Page 10
Gate Drive Signals
GPIO
Register Access
[${#}] ${TITLE}
Page 6
Page 14
Target specifications:
100 A
I2C
FDCAN2
1X Fan Connector
Page 13
2x FD-CAN Connectors
USART1
2x USER LEDs
SENSING
(GREEN, YELLOW)
Buck Max 500 mA
12-44 V
SPI
ADC2_IN17 DAC1_OUT1
Page 18
Page 4 (Power)
SWD
Kelvin Current Sense
SPI1, I2C1, USART2, TIM2_CH1-2 , TIM3_CH2
PWM
ADC5_IN1
TIM2 CH1, 2, 3
Fault, Enable, Mode
PB13 PC14 PB15
1x AUX2 Connector
Page 16
FD-CAN Transceiver
1x Debug Connector
ADC/DAC
Page 5 (I/Os)
FDCAN
Page 12
TEMPERATURE FET EXTERNAL THERMISTOR
SPI2, I2C2, ADC1, ADC2, USART1, TIM4_CH1-2
Page 17
Switching frequency:
PB15, PC6
AUX2
Gate Control
1X External Thermistor Connector
PD2

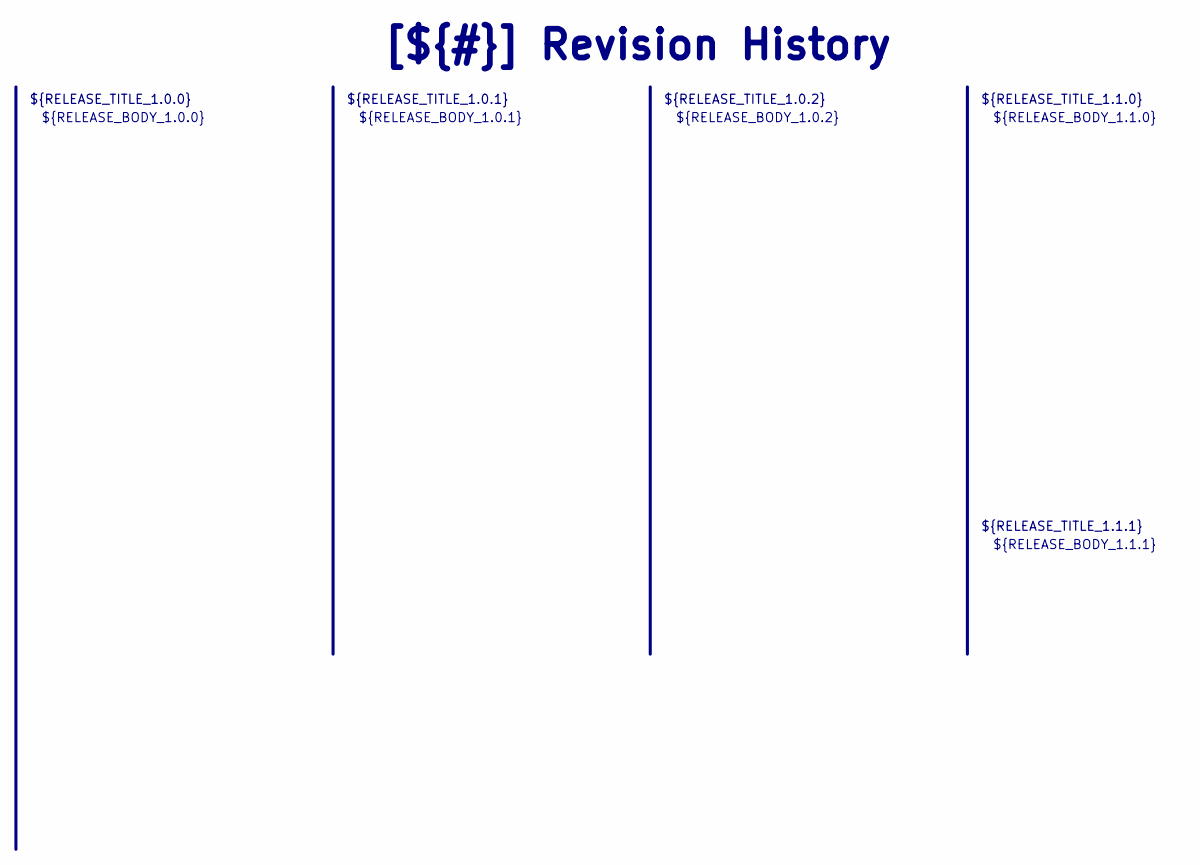
[picture p50: schematic Revision History.kicad_sch]

Notes on the sheet:
${RELEASE_BODY_1.1.0}
[${#}] ${TITLE}
${RELEASE_BODY_1.0.0}
${RELEASE_TITLE_1.0.2}
${RELEASE_BODY_1.1.1}
${RELEASE_TITLE_1.1.1}
${RELEASE_BODY_1.0.2}
${RELEASE_BODY_1.0.1}
${RELEASE_TITLE_1.0.0}
${RELEASE_TITLE_1.0.1}
${RELEASE_TITLE_1.1.0}

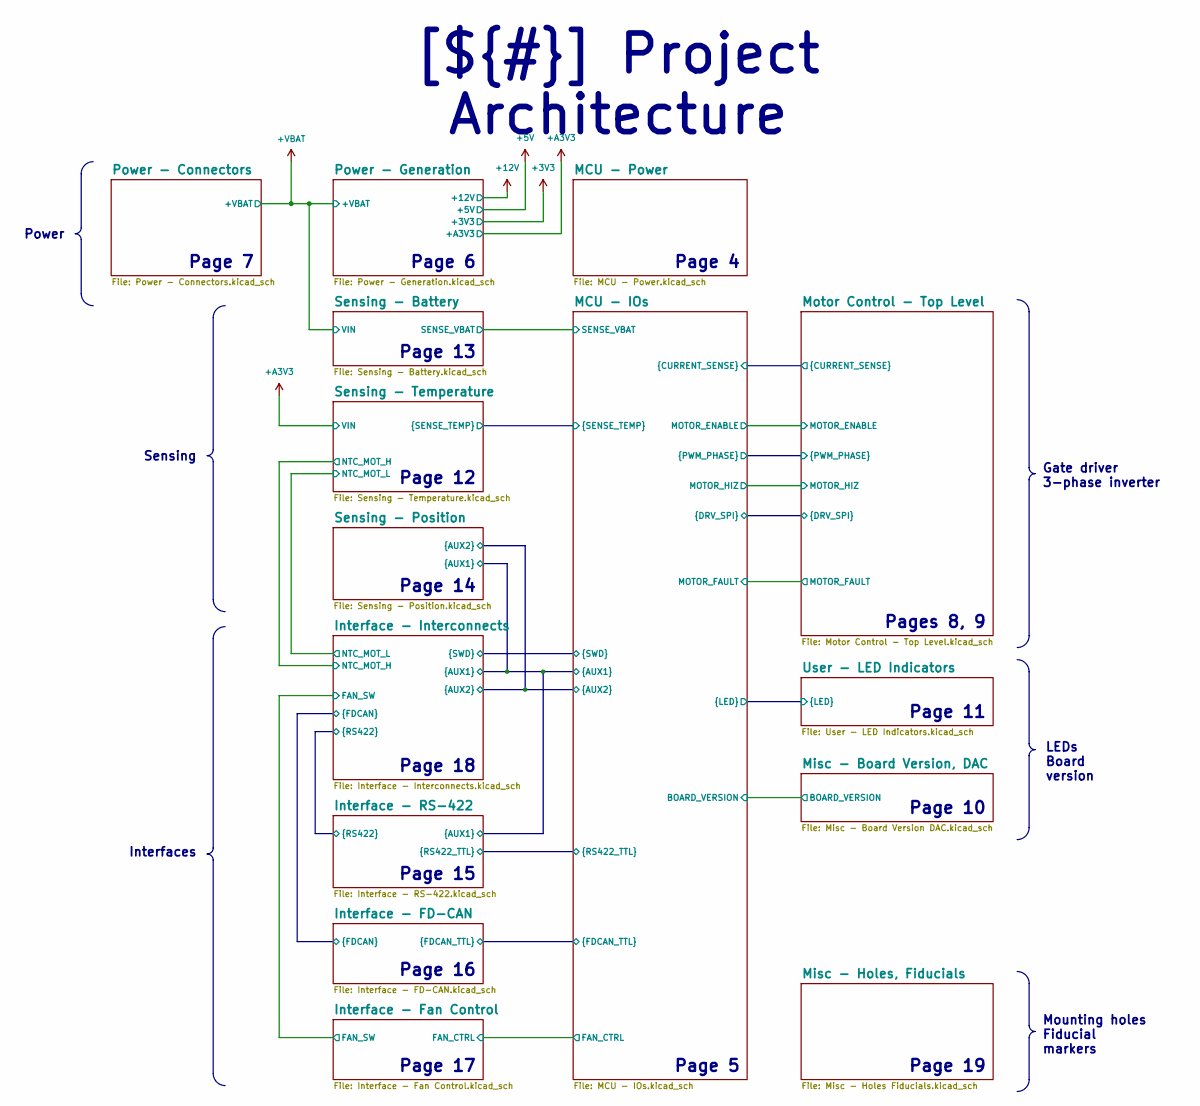
[picture p51: schematic Project Architecture.kicad_sch]

Notes on the sheet:
Page 18
Page 13
Page 16
Page 12
Page 10
Page 7
Page 17
Pages 8, 9
Page 11
Page 6
Page 14
Page 4
Page 19
Page 5
Page 15
Power
Interfaces
Sensing
[${#}] ${TITLE}
LEDs Board version
Mounting holes Fiducial markers
Gate driver 3-phase inverter

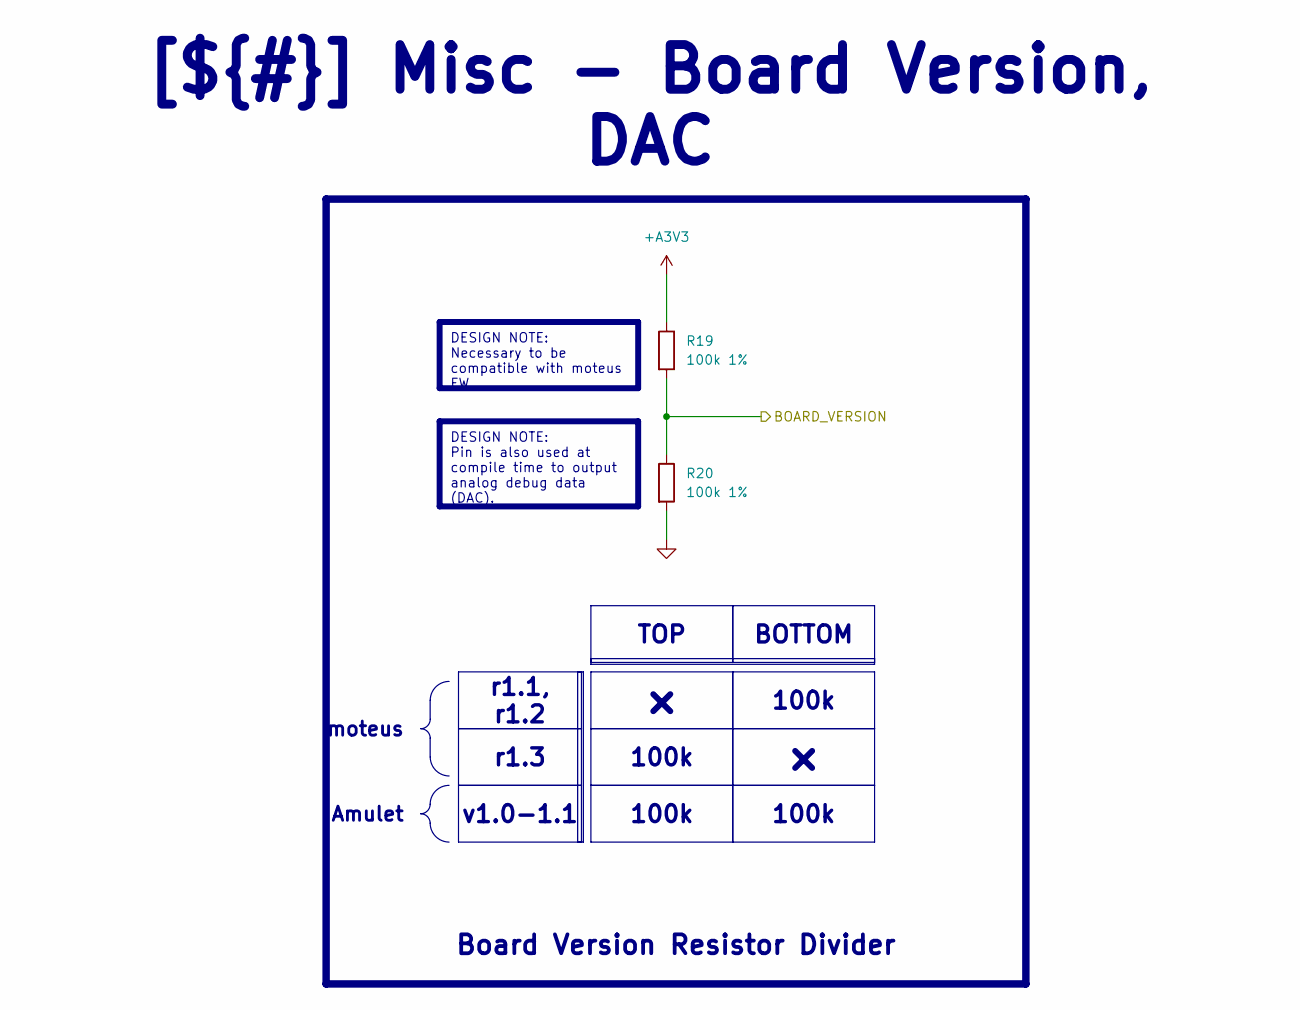
[picture p52: schematic Misc - Board Version DAC.kicad_sch, Misc - Board Version, DAC]

Parts:
R19, R20: 100k 1%; R_0402_1005_DensityHigh; Manufacturer Part Number RT0402FRE07100KL

Connections:
+A3V3: R19.1; also elsewhere on the board
/Project Architecture/MCU - IOs/BOARD_VERSION: R19.2, R20.1; also elsewhere on the board
GND: R20.2; also elsewhere on the board

Notes on the sheet:
100k
moteus
r1.3
r1.1, r1.2
DESIGN NOTE: Necessary to be compatible with moteus FW.
Amulet
[${#}] ${TITLE}
DESIGN NOTE: Pin is also used at compile time to output analog debug data (DAC).
Board Version Resistor Divider
BOTTOM
v1.0-1.1
TOP

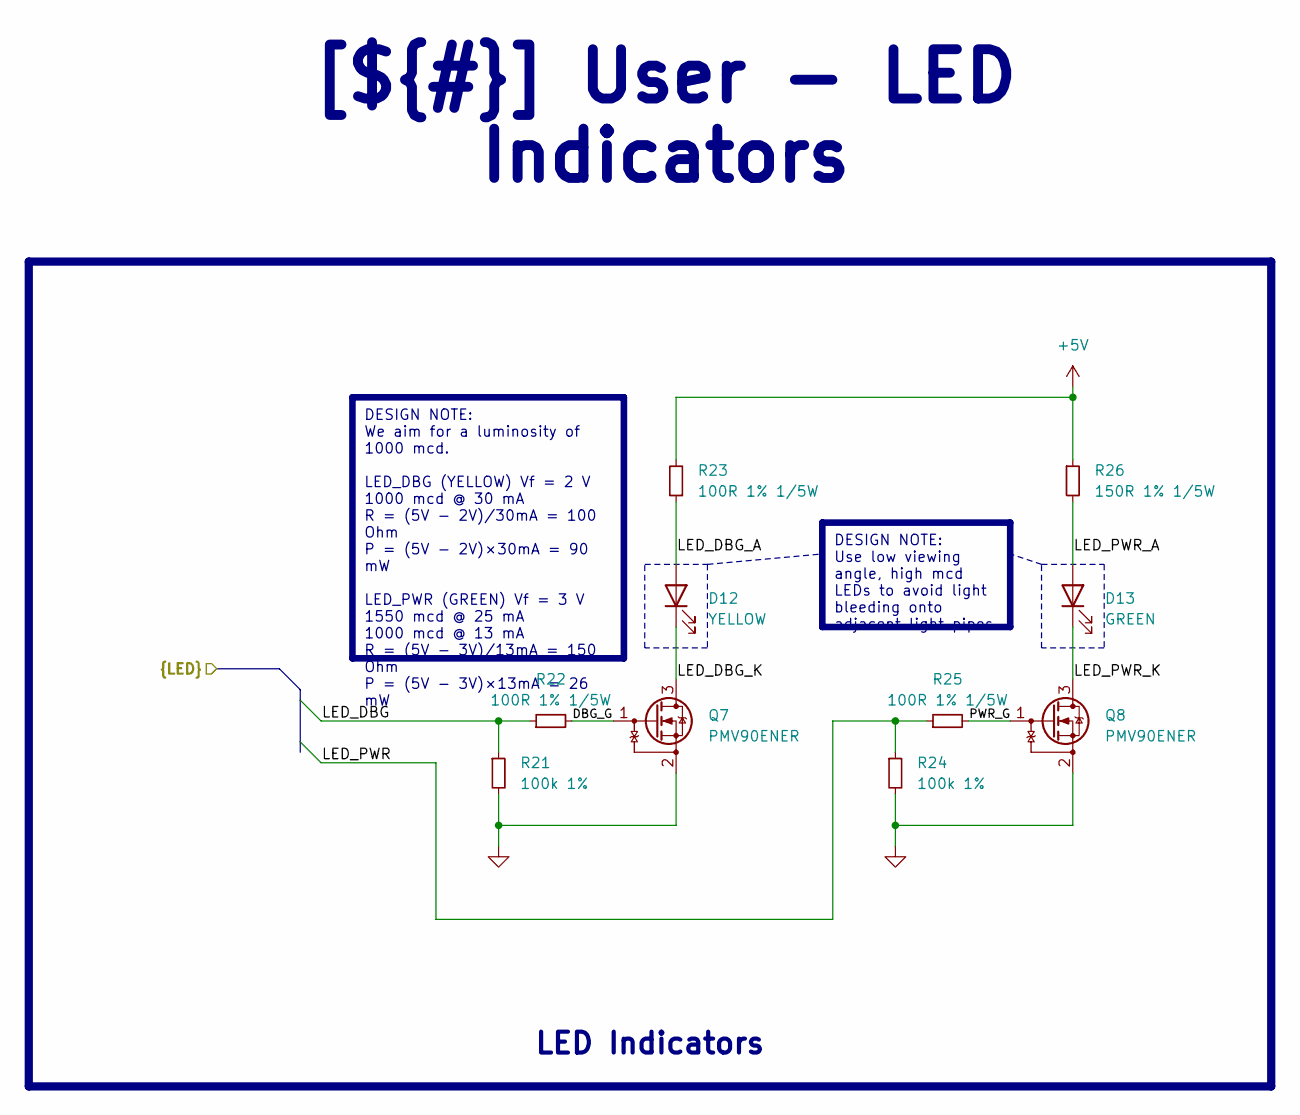
[picture p53: schematic User - LED Indicators.kicad_sch]

Parts:
D12: YELLOW; LED_SM1206; Manufacturer Part Number SM1206NYC-IL
D13: GREEN; LED_SM1206; Manufacturer Part Number SM1206NPGC-IL
Q7, Q8: PMV90ENER; SOT-23-3; Manufacturer Part Number PMV90ENER
R21, R24: 100k 1%; R_0402_1005_DensityHigh; Manufacturer Part Number RT0402FRE07100KL
R22, R23, R25: 100R 1% 1/5W; R_0402_1005_DensityHigh; Manufacturer Part Number RCS0402100RFKED
R26: 150R 1% 1/5W; R_0402_1005_DensityHigh; Manufacturer Part Number RCS0402150RFKED

Connections:
+5V: R23.2, R26.1; also elsewhere on the board
/Project Architecture/MCU - IOs/LED_DBG: R21.1, R22.1; also elsewhere on the board
/Project Architecture/MCU - IOs/LED_PWR: R24.1, R25.1; also elsewhere on the board
/Project Architecture/User - LED Indicators/DBG_G: Q7.1 (G), R22.2
/Project Architecture/User - LED Indicators/LED_DBG_A: D12.2 (A), R23.1
/Project Architecture/User - LED Indicators/LED_DBG_K: D12.1 (K), Q7.3 (D)
/Project Architecture/User - LED Indicators/LED_PWR_A: D13.2 (A), R26.2
/Project Architecture/User - LED Indicators/LED_PWR_K: D13.1 (K), Q8.3 (D)
/Project Architecture/User - LED Indicators/PWR_G: Q8.1 (G), R25.2
GND: Q7.2 (S), Q8.2 (S), R21.2, R24.2; also elsewhere on the board

Notes on the sheet:
[${#}] ${TITLE}
DESIGN NOTE: We aim for a luminosity of 1000 mcd. LED_DBG (YELLOW) Vf = 2 V 1000 mcd @ 30 mA R = (5V - 2V)/30mA = 100 Ohm P = (5V - 2V)×30mA = 90 mW LED_PWR (GREEN) Vf = 3 V 1550 mcd @ 25 mA 1000 mcd @ 13 mA R = (5V - 3V)/13mA = 150 Ohm P = (5V - 3V)×13mA = 26 mW
DESIGN NOTE: Use low viewing angle, high mcd LEDs to avoid light bleeding onto adjacent light pipes.
LED Indicators

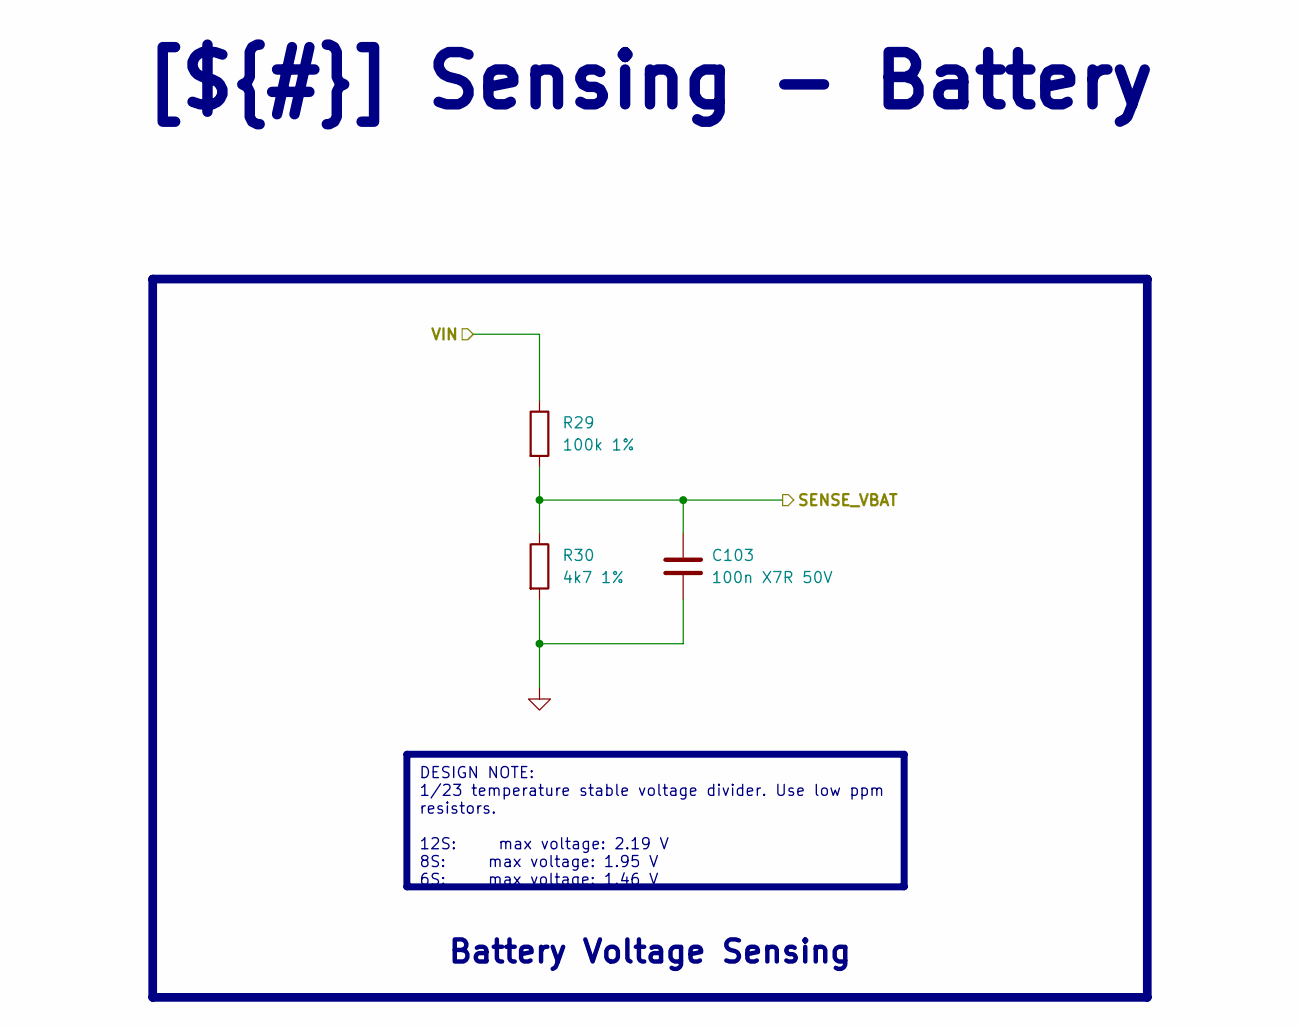
[picture p54: schematic Sensing - Battery.kicad_sch]

Parts:
C103: 100n X7R 50V; C_0402_1005_DensityHigh; Manufacturer Part Number GCM155R71H104KE02J
R29: 100k 1%; R_0402_1005_DensityHigh; Manufacturer Part Number RT0402FRE07100KL
R30: 4k7 1%; R_0402_1005_DensityHigh; Manufacturer Part Number RT0402FRE134K7L

Connections:
+VBAT: R29.1; also elsewhere on the board
/Project Architecture/MCU - IOs/SENSE_VBAT: C103.1, R29.2, R30.1; also elsewhere on the board
GND: C103.2, R30.2; also elsewhere on the board

Notes on the sheet:
[${#}] ${TITLE}
DESIGN NOTE: 1/23 temperature stable voltage divider. Use low ppm resistors. 12S: max voltage: 2.19 V 8S: max voltage: 1.95 V 6S: max voltage: 1.46 V
Battery Voltage Sensing

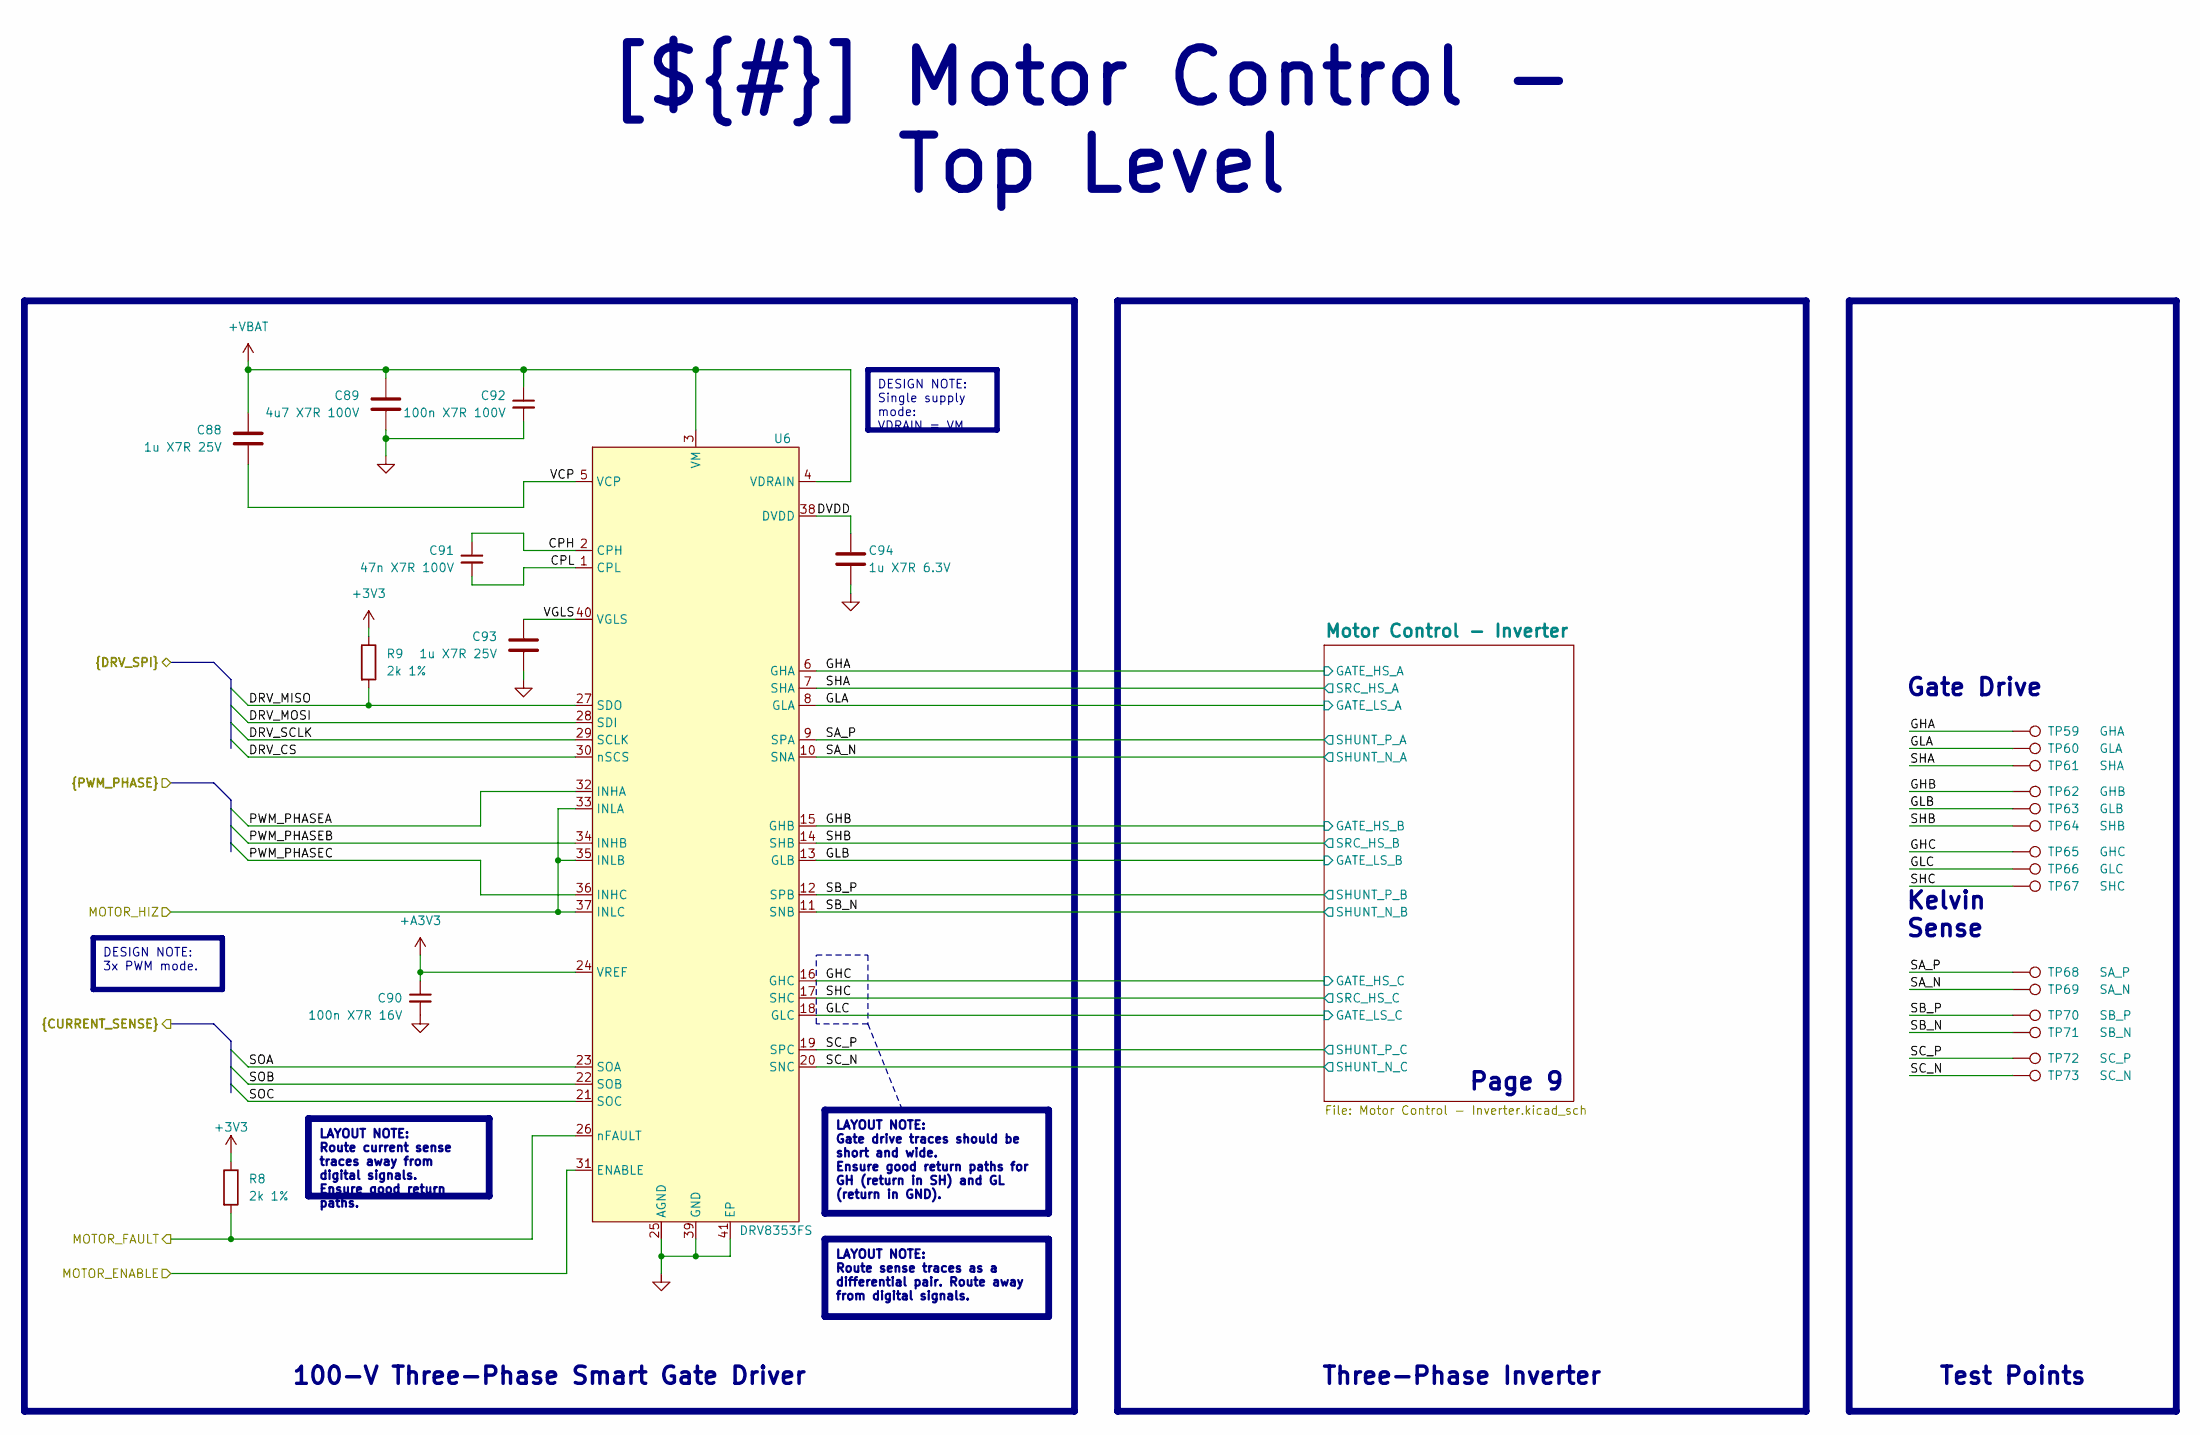
[picture p55: schematic Motor Control - Top Level.kicad_sch]

Parts:
C88, C93: 1u X7R 25V; C_0603_1608_DensityHigh; Manufacturer Part Number TMK107AB7105KAHT
C89: 4u7 X7R 100V; C_1206_3216_DensityHighest; Manufacturer Part Number GRJ31CZ72A475KE01L
C90: 100n X7R 16V; C_0402_1005_DensityHigh; Manufacturer Part Number GCM155R71C104KA55D
C91: 47n X7R 100V; C_0603_1608_DensityHigh; Manufacturer Part Number C0603C473K1RECAUTO
C92: 100n X7R 100V; C_0603_1608_DensityHigh; Manufacturer Part Number HMK107B7104KAHT
C94: 1u X7R 6.3V; C_0402_1005_DensityHigh; Manufacturer Part Number GRT155R70J105KE01D
R8, R9: 2k 1%; R_0402_1005_DensityHigh; Manufacturer Part Number ERJ-2RKF2001X
TP59: GHA; TestPoint_Pad_D0.4mm
TP60: GLA; TestPoint_Pad_D0.4mm
TP61: SHA; TestPoint_Pad_D0.4mm
TP62: GHB; TestPoint_Pad_D0.4mm
TP63: GLB; TestPoint_Pad_D0.4mm
TP64: SHB; TestPoint_Pad_D0.4mm
TP65: GHC; TestPoint_Pad_D0.4mm
TP66: GLC; TestPoint_Pad_D0.4mm
TP67: SHC; TestPoint_Pad_D0.4mm
TP68: SA_P; TestPoint_Pad_D0.5mm
TP69: SA_N; TestPoint_Pad_D0.5mm
TP70: SB_P; TestPoint_Pad_D0.5mm
TP71: SB_N; TestPoint_Pad_D0.5mm
TP72: SC_P; TestPoint_Pad_D0.5mm
TP73: SC_N; TestPoint_Pad_D0.5mm
U6: DRV8353FS; WQFN-40-1EP_6x6mm_P0.5mm_EP4.15x4.15mm_ThermalVias; Manufacturer Part Number DRV8353FSRTAR

Connections:
+3V3: R8.1, R9.1; also elsewhere on the board
+A3V3: C90.1, U6.24 (VREF); also elsewhere on the board
+VBAT: C88.1, C89.1, C92.1, U6.3 (VM), U6.4 (VDRAIN); also elsewhere on the board
/Project Architecture/MCU - IOs/DRV_CS: U6.30 (nSCS); also elsewhere on the board
/Project Architecture/MCU - IOs/DRV_MISO: R9.2, U6.27 (SDO); also elsewhere on the board
/Project Architecture/MCU - IOs/DRV_MOSI: U6.28 (SDI); also elsewhere on the board
/Project Architecture/MCU - IOs/DRV_SCLK: U6.29 (SCLK); also elsewhere on the board
/Project Architecture/MCU - IOs/MOTOR_ENABLE: U6.31 (ENABLE); also elsewhere on the board
/Project Architecture/MCU - IOs/MOTOR_FAULT: R8.2, U6.26 (nFAULT); also elsewhere on the board
/Project Architecture/MCU - IOs/MOTOR_HIZ: U6.33 (INLA), U6.35 (INLB), U6.37 (INLC); also elsewhere on the board
/Project Architecture/MCU - IOs/PWM_PHASEA: U6.32 (INHA); also elsewhere on the board
/Project Architecture/MCU - IOs/PWM_PHASEB: U6.34 (INHB); also elsewhere on the board
/Project Architecture/MCU - IOs/PWM_PHASEC: U6.36 (INHC); also elsewhere on the board
/Project Architecture/MCU - IOs/SOA: U6.23 (SOA); also elsewhere on the board
/Project Architecture/MCU - IOs/SOB: U6.22 (SOB); also elsewhere on the board
/Project Architecture/MCU - IOs/SOC: U6.21 (SOC); also elsewhere on the board
/Project Architecture/Motor Control - Top Level/CPH: C91.1, U6.2 (CPH)
/Project Architecture/Motor Control - Top Level/CPL: C91.2, U6.1 (CPL)
/Project Architecture/Motor Control - Top Level/DVDD: C94.1, U6.38 (DVDD)
/Project Architecture/Motor Control - Top Level/GHA: TP59.1 (1_1), U6.6 (GHA); also elsewhere on the board
/Project Architecture/Motor Control - Top Level/GHB: TP62.1 (1_1), U6.15 (GHB); also elsewhere on the board
/Project Architecture/Motor Control - Top Level/GHC: TP65.1 (1_1), U6.16 (GHC); also elsewhere on the board
/Project Architecture/Motor Control - Top Level/GLA: TP60.1 (1_1), U6.8 (GLA); also elsewhere on the board
/Project Architecture/Motor Control - Top Level/GLB: TP63.1 (1_1), U6.13 (GLB); also elsewhere on the board
/Project Architecture/Motor Control - Top Level/GLC: TP66.1 (1_1), U6.18 (GLC); also elsewhere on the board
/Project Architecture/Motor Control - Top Level/SA_N: TP69.1 (1_1), U6.10 (SNA); also elsewhere on the board
/Project Architecture/Motor Control - Top Level/SA_P: TP68.1 (1_1), U6.9 (SPA); also elsewhere on the board
/Project Architecture/Motor Control - Top Level/SB_N: TP71.1 (1_1), U6.11 (SNB); also elsewhere on the board
/Project Architecture/Motor Control - Top Level/SB_P: TP70.1 (1_1), U6.12 (SPB); also elsewhere on the board
/Project Architecture/Motor Control - Top Level/SC_N: TP73.1 (1_1), U6.20 (SNC); also elsewhere on the board
/Project Architecture/Motor Control - Top Level/SC_P: TP72.1 (1_1), U6.19 (SPC); also elsewhere on the board
/Project Architecture/Motor Control - Top Level/SHA: TP61.1 (1_1), U6.7 (SHA); also elsewhere on the board
/Project Architecture/Motor Control - Top Level/SHB: TP64.1 (1_1), U6.14 (SHB); also elsewhere on the board
/Project Architecture/Motor Control - Top Level/SHC: TP67.1 (1_1), U6.17 (SHC); also elsewhere on the board
/Project Architecture/Motor Control - Top Level/VCP: C88.2, U6.5 (VCP)
/Project Architecture/Motor Control - Top Level/VGLS: C93.1, U6.40 (VGLS)
GND: C89.2, C90.2, C92.2, C93.2, C94.2, U6.25 (AGND), U6.39 (GND), U6.41 (EP); also elsewhere on the board

Notes on the sheet:
Page 9
DESIGN NOTE: 3x PWM mode.
[${#}] ${TITLE}
LAYOUT NOTE: Gate drive traces should be short and wide. Ensure good return paths for GH (return in SH) and GL (return in GND).
Test Points
LAYOUT NOTE: Route sense traces as a differential pair. Route away from digital signals.
DESIGN NOTE: Single supply mode: VDRAIN = VM
Gate Drive
LAYOUT NOTE: Route current sense traces away from digital signals. Ensure good return paths.
Three-Phase Inverter
100-V Three-Phase Smart Gate Driver
Kelvin Sense

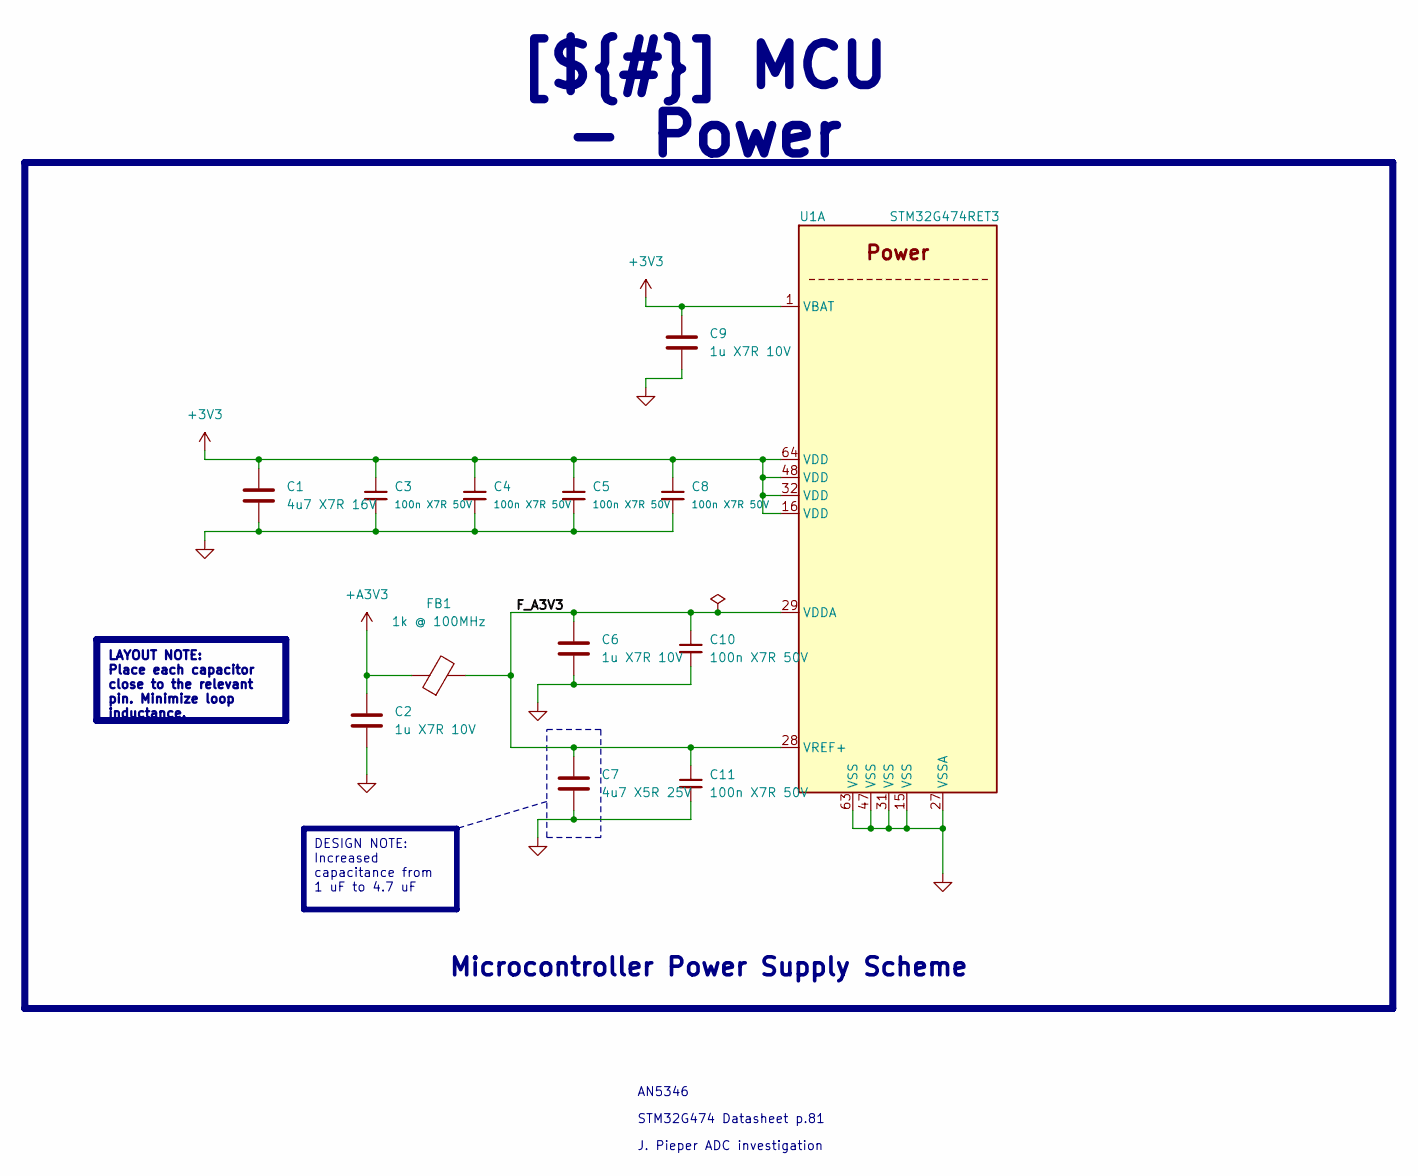
[picture p56: schematic MCU - Power.kicad_sch]

Parts:
C1: 4u7 X7R 16V; C_0603_1608_DensityHigh; Manufacturer Part Number GRM188Z71C475KE21J
C2, C6, C9: 1u X7R 10V; C_0402_1005_DensityHigh; Manufacturer Part Number GRM155Z71A105KE01J
C3, C4, C5, C8, C10, C11: 100n X7R 50V; C_0402_1005_DensityHigh; Manufacturer Part Number GCM155R71H104KE02J
C7: 4u7 X5R 25V; C_0402_1005_DensityHigh; Manufacturer Part Number CM05X5R475M25AH
FB1: 1k @ 100MHz; R_0805_2012_DensityHigh; Manufacturer Part Number 742792096
U1: STM32G474RET3; LQFP-64_10x10mm_P0.5mm; Manufacturer Part Number STM32G474RET3

Connections:
+3V3: C1.1, C3.1, C4.1, C5.1, C8.1, C9.1, U1.1 (VBAT), U1.16 (VDD), U1.32 (VDD), U1.48 (VDD), U1.64 (VDD); also elsewhere on the board
+A3V3: C2.1, FB1.1; also elsewhere on the board
/Project Architecture/MCU - Power/F_A3V3: C6.1, C7.1, C10.1, C11.1, FB1.2, U1.28 (VREF+), U1.29 (VDDA)
GND: C1.2, C2.2, C3.2, C4.2, C5.2, C6.2, C7.2, C8.2, C9.2, C10.2, C11.2, U1.15 (VSS), U1.27 (VSSA), U1.31 (VSS), U1.47 (VSS), U1.63 (VSS); also elsewhere on the board

Notes on the sheet:
J. Pieper ADC investigation
STM32G474 Datasheet p.81
AN5346
LAYOUT NOTE: Place each capacitor close to the relevant pin. Minimize loop inductance.
[${#}] ${TITLE}
Microcontroller Power Supply Scheme
DESIGN NOTE: Increased capacitance from 1 uF to 4.7 uF

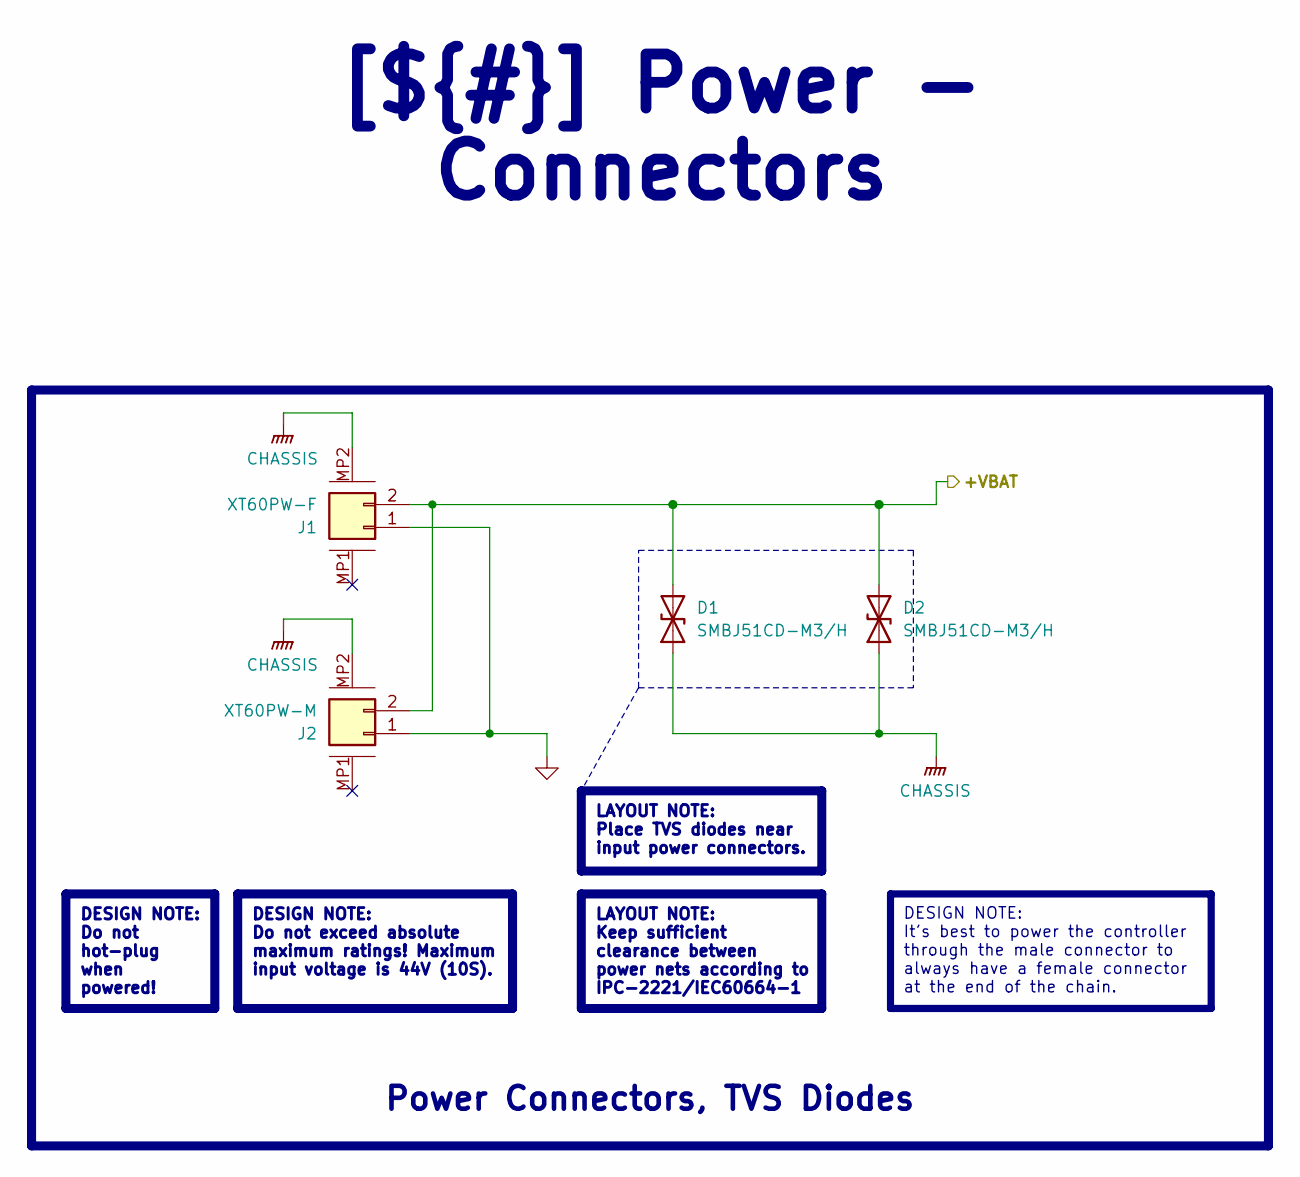
[picture p57: schematic Power - Connectors.kicad_sch]

Parts:
D1, D2: SMBJ51CD-M3/H; DIOM4336X24N; Manufacturer Part Number SMBJ51CD-M3/H
J1: XT60PW-F; AMASS_XT60PW-F_1x02_P7.20mm_Horizontal; Manufacturer Part Number XT60PW-F
J2: XT60PW-M; AMASS_XT60PW-M_1x02_P7.20mm_Horizontal; Manufacturer Part Number XT60PW-M

Connections:
+VBAT: D1.2 (A2), D2.2 (A2), J1.2, J2.2; also elsewhere on the board
CHASSIS: D1.1 (A1), D2.1 (A1), J1.MP2, J2.MP2; also elsewhere on the board
GND: J1.1, J2.1; also elsewhere on the board

Notes on the sheet:
DESIGN NOTE: Do not exceed absolute maximum ratings! Maximum input voltage is 44V (10S).
DESIGN NOTE: Do not hot-plug when powered!
LAYOUT NOTE: Place TVS diodes near input power connectors.
[${#}] ${TITLE}
DESIGN NOTE: It's best to power the controller through the male connector to always have a female connector at the end of the chain.
Power Connectors, TVS Diodes
LAYOUT NOTE: Keep sufficient clearance between power nets according to IPC-2221/IEC60664-1
