RRichard67/amulet_controller_kibot/amulet_controller.kicad_pcb

## KiCad design amulet_controller.kicad_pcb (continued)

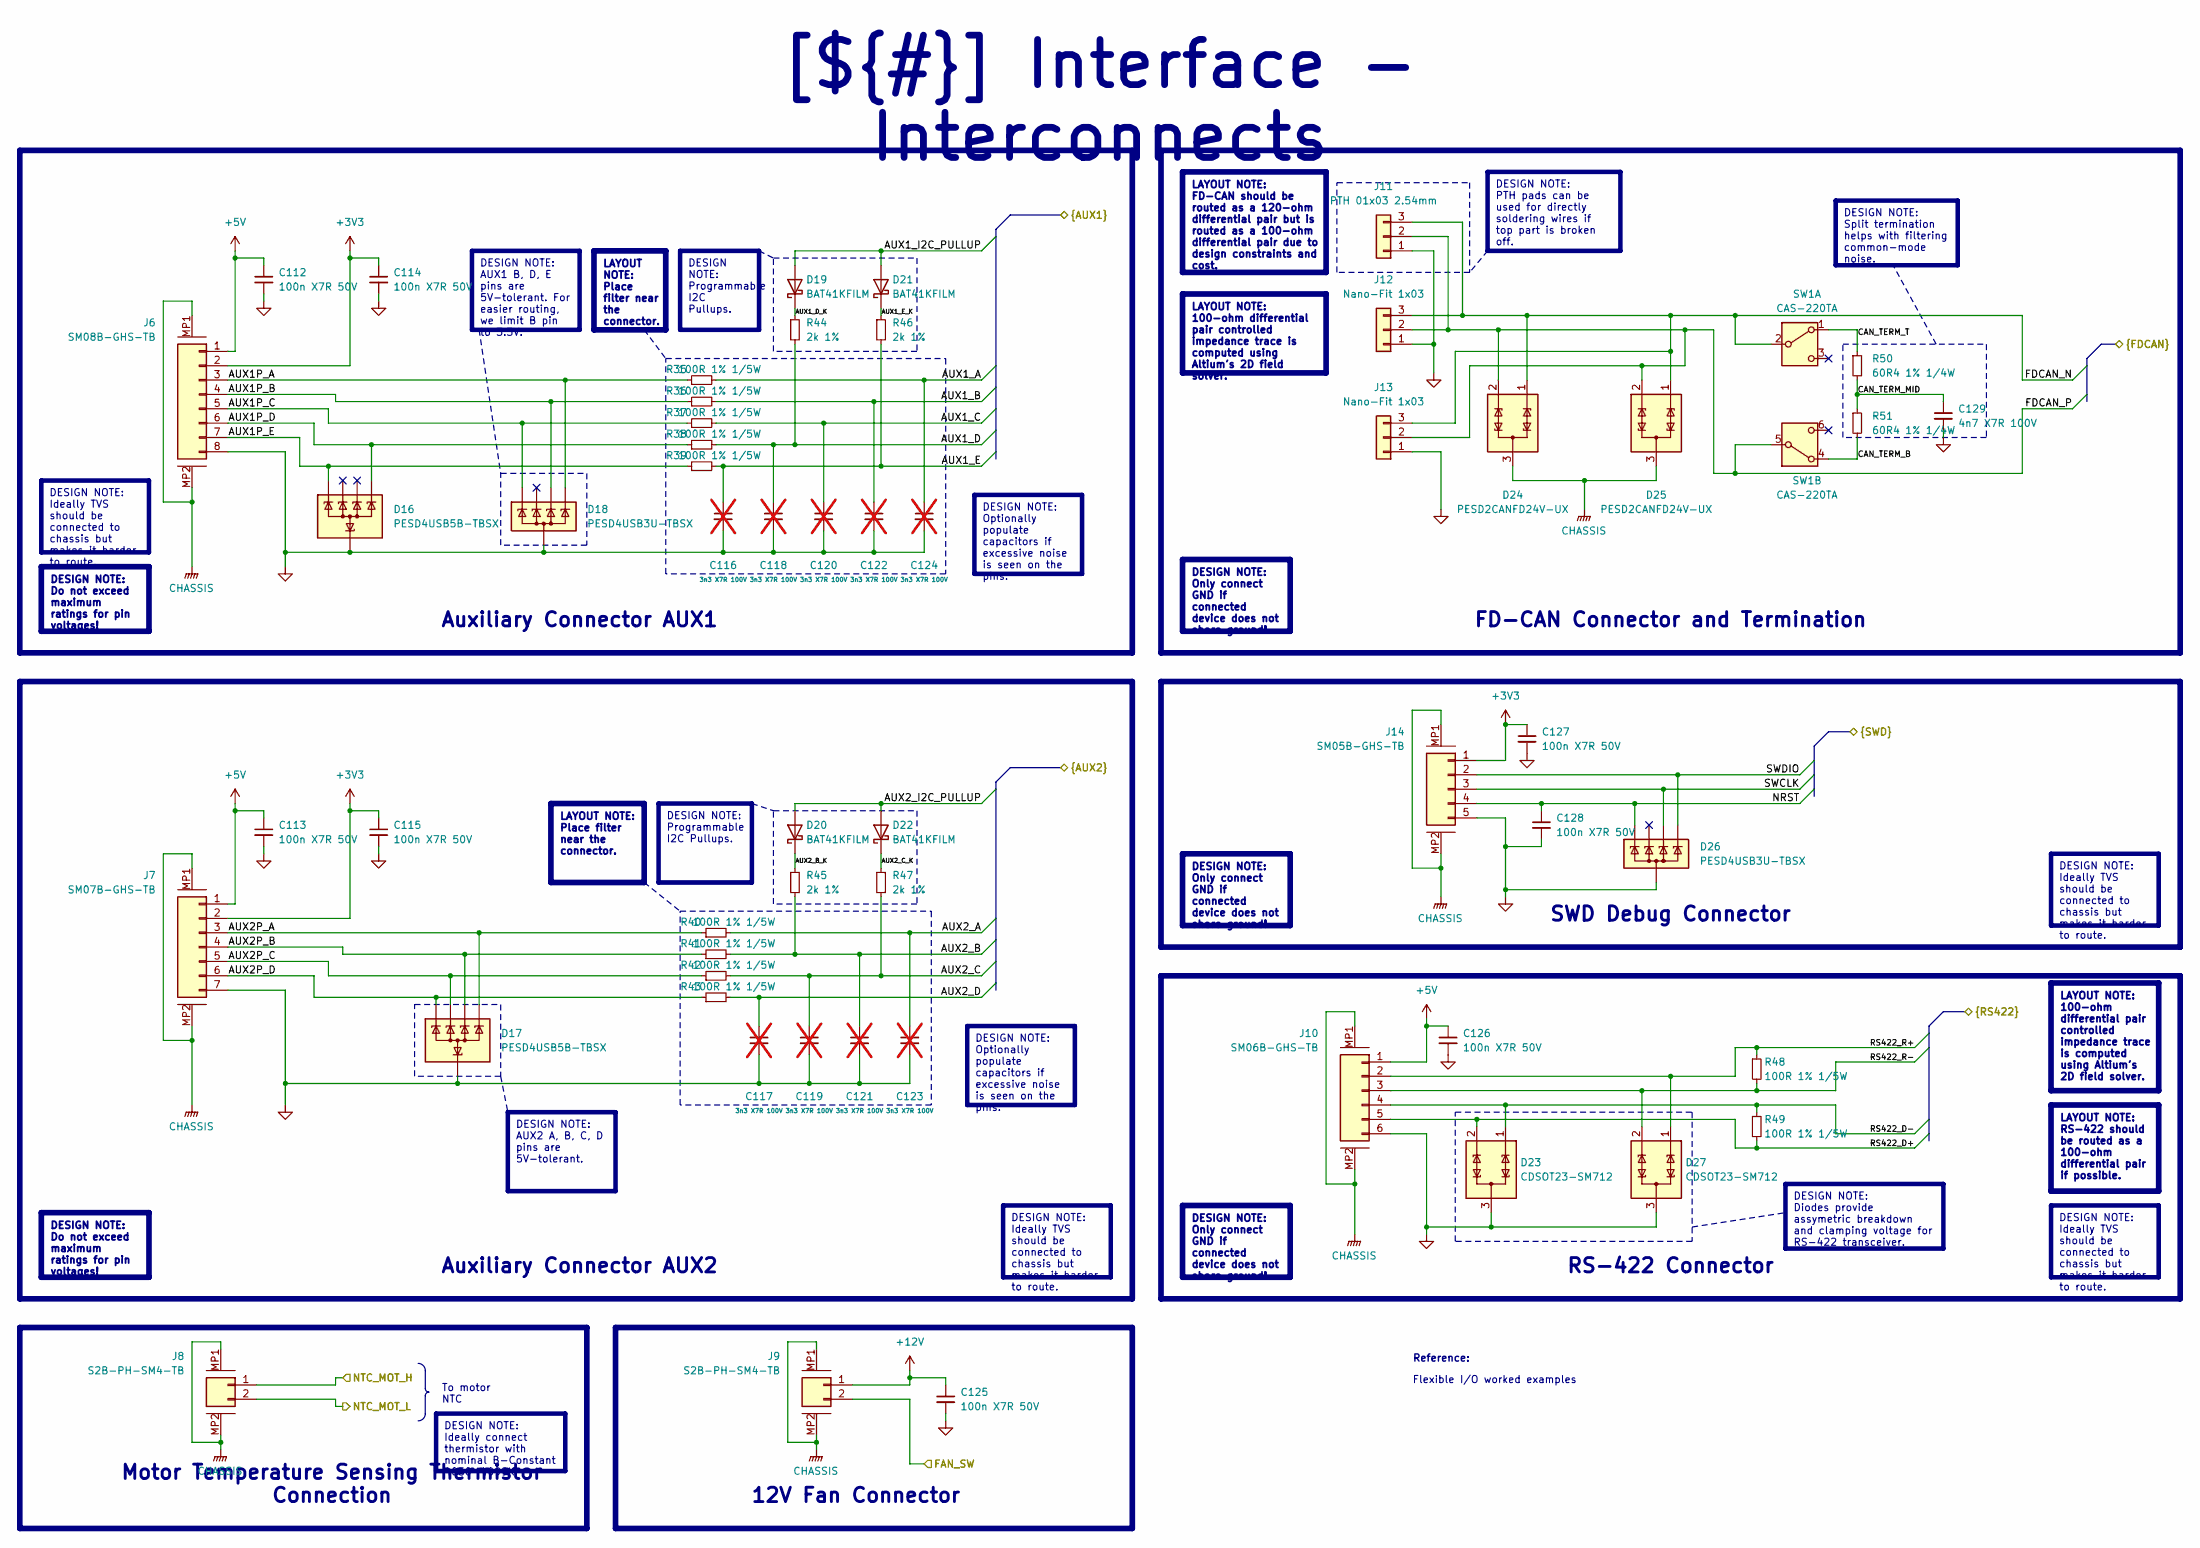
[picture p64: schematic Interface - Interconnects.kicad_sch]

Parts:
C112, C113, C114, C115, C125, C126, C127, C128: 100n X7R 50V; C_0402_1005_DensityHigh; Manufacturer Part Number GCM155R71H104KE02J
C116, C117, C118, C119, C120, C121, C122, C123, C124: 3n3 X7R 100V; C_0402_1005_DensityHigh; Manufacturer Part Number GRM155R72A332KA01D; not fitted
C129: 4n7 X7R 100V; C_0402_1005_DensityHigh; Manufacturer Part Number GCM155R72A472KA37D
D16, D17: PESD4USB5B-TBSX; SOT1176D; Manufacturer Part Number PESD4USB5B-TBSX
D18, D26: PESD4USB3U-TBSX; SOT1176D; Manufacturer Part Number PESD4USB3U-TBSX
D19, D20, D21, D22: BAT41KFILM; D_SOD-523; Manufacturer Part Number BAT41KFILM
D23, D27: CDSOT23-SM712; SOT95P230X110-3N; Manufacturer Part Number CDSOT23-SM712
D24, D25: PESD2CANFD24V-UX; SOT95P230X117-3N; Manufacturer Part Number PESD2CANFD24V-UX
J6: SM08B-GHS-TB; JST_GH_SM08B-GHS-TB_1x08-1MP_P1.25mm_Horizontal; Manufacturer Part Number SM08B-GHS-TB
J7: SM07B-GHS-TB; JST_GH_SM07B-GHS-TB_1x07-1MP_P1.25mm_Horizontal; Manufacturer Part Number SM07B-GHS-TB(LF)(SN)
J8, J9: S2B-PH-SM4-TB; JST_PH_S2B-PH-SM4-TB_1x02-1MP_P2.00mm_Horizontal; Manufacturer Part Number S2B-PH-SM4-TB
J10: SM06B-GHS-TB; JST_GH_SM06B-GHS-TB_1x06-1MP_P1.25mm_Horizontal; Manufacturer Part Number SM06B-GHS-TB
J11: PTH 01x03 2.54mm; PTH_1x03_P2.54mm
J12, J13: Nano-Fit 1x03; 1054301203; Manufacturer Part Number 1054301203
J14: SM05B-GHS-TB; JST_GH_SM05B-GHS-TB_1x05-1MP_P1.25mm_Horizontal; Manufacturer Part Number SM05B-GHS-TB
R35, R36, R37, R38, R39, R40, R41, R42, R43, R48, R49: 100R 1% 1/5W; R_0402_1005_DensityHigh; Manufacturer Part Number RCS0402100RFKED
R44, R45, R46, R47: 2k 1%; R_0402_1005_DensityHigh; Manufacturer Part Number ERJ-2RKF2001X
R50, R51: 60R4 1% 1/4W; R_0603_1608_DensityHigh; Manufacturer Part Number ESR03EZPF60R4
SW1: CAS-220TA; CAS-220A_NDC-L; Manufacturer Part Number CAS-220TA

Connections:
+3V3: C114.1, C115.1, C127.1, J6.2, J7.2, J14.1; also elsewhere on the board
+5V: C112.1, C113.1, C126.1, J6.1, J7.1, J10.1; also elsewhere on the board
+12V: C125.1, J9.1; also elsewhere on the board
/Project Architecture/Interface - FD-CAN/FDCAN_N: D24.1 (K1), D25.1 (K1), J11.3, J12.3, J13.3, SW1.2 (B); also elsewhere on the board
/Project Architecture/Interface - FD-CAN/FDCAN_P: D24.2 (K2), D25.2 (K2), J11.2, J12.2, J13.2, SW1.5 (B); also elsewhere on the board
/Project Architecture/Interface - Fan Control/FAN_SW: J9.2; also elsewhere on the board
/Project Architecture/Interface - Interconnects/AUX1P_A: D18.5 (K), D18.6 (K), J6.3, R35.1
/Project Architecture/Interface - Interconnects/AUX1P_B: D18.4 (K), D18.7 (K), J6.4, R36.1
/Project Architecture/Interface - Interconnects/AUX1P_C: D18.1 (K), D18.10 (K), J6.5, R37.1
/Project Architecture/Interface - Interconnects/AUX1P_D: D16.5 (K), D16.6 (K), J6.6, R38.1
/Project Architecture/Interface - Interconnects/AUX1P_E: D16.1 (K), D16.10 (K), J6.7, R39.1
/Project Architecture/Interface - Interconnects/AUX1_A: C124.1, R35.2; also elsewhere on the board
/Project Architecture/Interface - Interconnects/AUX1_B: C122.1, R36.2; also elsewhere on the board
/Project Architecture/Interface - Interconnects/AUX1_C: C120.1, R37.2; also elsewhere on the board
/Project Architecture/Interface - Interconnects/AUX1_D: C118.1, R38.2, R44.2; also elsewhere on the board
/Project Architecture/Interface - Interconnects/AUX1_D_K: D19.1 (K), R44.1
/Project Architecture/Interface - Interconnects/AUX1_E: C116.1, R39.2, R46.2; also elsewhere on the board
/Project Architecture/Interface - Interconnects/AUX1_E_K: D21.1 (K), R46.1
/Project Architecture/Interface - Interconnects/AUX1_I2C_PULLUP: D19.2 (A), D21.2 (A); also elsewhere on the board
/Project Architecture/Interface - Interconnects/AUX2P_A: D17.5 (K), D17.6 (K), J7.3, R40.1
/Project Architecture/Interface - Interconnects/AUX2P_B: D17.4 (K), D17.7 (K), J7.4, R41.1
/Project Architecture/Interface - Interconnects/AUX2P_C: D17.2 (K), D17.9 (K), J7.5, R42.1
/Project Architecture/Interface - Interconnects/AUX2P_D: D17.1 (K), D17.10 (K), J7.6, R43.1
/Project Architecture/Interface - Interconnects/AUX2_A: C123.1, R40.2; also elsewhere on the board
/Project Architecture/Interface - Interconnects/AUX2_B: C121.1, R41.2, R45.2; also elsewhere on the board
/Project Architecture/Interface - Interconnects/AUX2_B_K: D20.1 (K), R45.1
/Project Architecture/Interface - Interconnects/AUX2_C: C119.1, R42.2, R47.2; also elsewhere on the board
/Project Architecture/Interface - Interconnects/AUX2_C_K: D22.1 (K), R47.1
/Project Architecture/Interface - Interconnects/AUX2_D: C117.1, R43.2; also elsewhere on the board
/Project Architecture/Interface - Interconnects/AUX2_I2C_PULLUP: D20.2 (A), D22.2 (A); also elsewhere on the board
/Project Architecture/Interface - Interconnects/CAN_TERM_B: R51.2, SW1.4 (A)
/Project Architecture/Interface - Interconnects/CAN_TERM_MID: C129.1, R50.2, R51.1
/Project Architecture/Interface - Interconnects/CAN_TERM_T: R50.1, SW1.1 (A)
/Project Architecture/Interface - Interconnects/NRST: C128.1, D26.1 (K), D26.10 (K), J14.4; also elsewhere on the board
/Project Architecture/Interface - Interconnects/NTC_MOT_H: J8.1; also elsewhere on the board
/Project Architecture/Interface - Interconnects/NTC_MOT_L: J8.2; also elsewhere on the board
/Project Architecture/Interface - Interconnects/RS422_D+: D23.2 (A2), J10.5, R49.2; also elsewhere on the board
/Project Architecture/Interface - Interconnects/RS422_D-: D23.1 (A1), J10.4, R49.1; also elsewhere on the board
/Project Architecture/Interface - Interconnects/RS422_R+: D27.1 (A1), J10.2, R48.1; also elsewhere on the board
/Project Architecture/Interface - Interconnects/RS422_R-: D27.2 (A2), J10.3, R48.2; also elsewhere on the board
/Project Architecture/Interface - Interconnects/SWCLK: D26.4 (K), D26.7 (K), J14.3; also elsewhere on the board
/Project Architecture/Interface - Interconnects/SWDIO: D26.5 (K), D26.6 (K), J14.2; also elsewhere on the board
CHASSIS: D24.3 (CC), D25.3 (CC), J6.MP1, J6.MP2, J7.MP1, J7.MP2, J8.MP1, J8.MP2, J9.MP1, J9.MP2, J10.MP1, J10.MP2, J14.MP1, J14.MP2; also elsewhere on the board
GND: C112.2, C113.2, C114.2, C115.2, C116.2, C117.2, C118.2, C119.2, C120.2, C121.2, C122.2, C123.2, C124.2, C125.2, C126.2, C127.2, C128.2, C129.2, D16.3 (A), D16.8 (A), D17.3 (A), D17.8 (A), D18.3 (A), D18.8 (A), D23.3 (common), D26.3 (A), D26.8 (A), D27.3 (common), J6.8, J7.7, J10.6, J11.1, J12.1, J13.1, J14.5; also elsewhere on the board

Notes on the sheet:
Reference:
Flexible I/O worked examples
DESIGN NOTE: PTH pads can be used for directly soldering wires if top part is broken off.
DESIGN NOTE: Only connect GND if connected device does not share ground!
12V Fan Connector
[${#}] ${TITLE}
DESIGN NOTE: Do not exceed maximum ratings for pin voltages!
DESIGN NOTE: Diodes provide assymetric breakdown and clamping voltage for RS-422 transceiver.
Auxiliary Connector AUX1
DESIGN NOTE: AUX2 A, B, C, D pins are 5V-tolerant.
DESIGN NOTE: Split termination helps with filtering common-mode noise.
DESIGN NOTE: Programmable I2C Pullups.
Auxiliary Connector AUX2
FD-CAN Connector and Termination
DESIGN NOTE: Ideally TVS should be connected to chassis but makes it harder to route.
DESIGN NOTE: Optionally populate capacitors if excessive noise is seen on the pins.
Motor Temperature Sensing Thermistor Connection
To motor NTC
LAYOUT NOTE: RS-422 should be routed as a 100-ohm differential pair if possible.
LAYOUT NOTE: 100-ohm differential pair controlled impedance trace is computed using Altium's 2D field solver.
SWD Debug Connector
DESIGN NOTE: AUX1 B, D, E pins are 5V-tolerant. For easier routing, we limit B pin to 3.3V.
DESIGN NOTE: Ideally connect thermistor with nominal B-Constant 4050-4099K
RS-422 Connector
LAYOUT NOTE: Place filter near the connector.
LAYOUT NOTE: FD-CAN should be routed as a 120-ohm differential pair but is routed as a 100-ohm differential pair due to design constraints and cost.

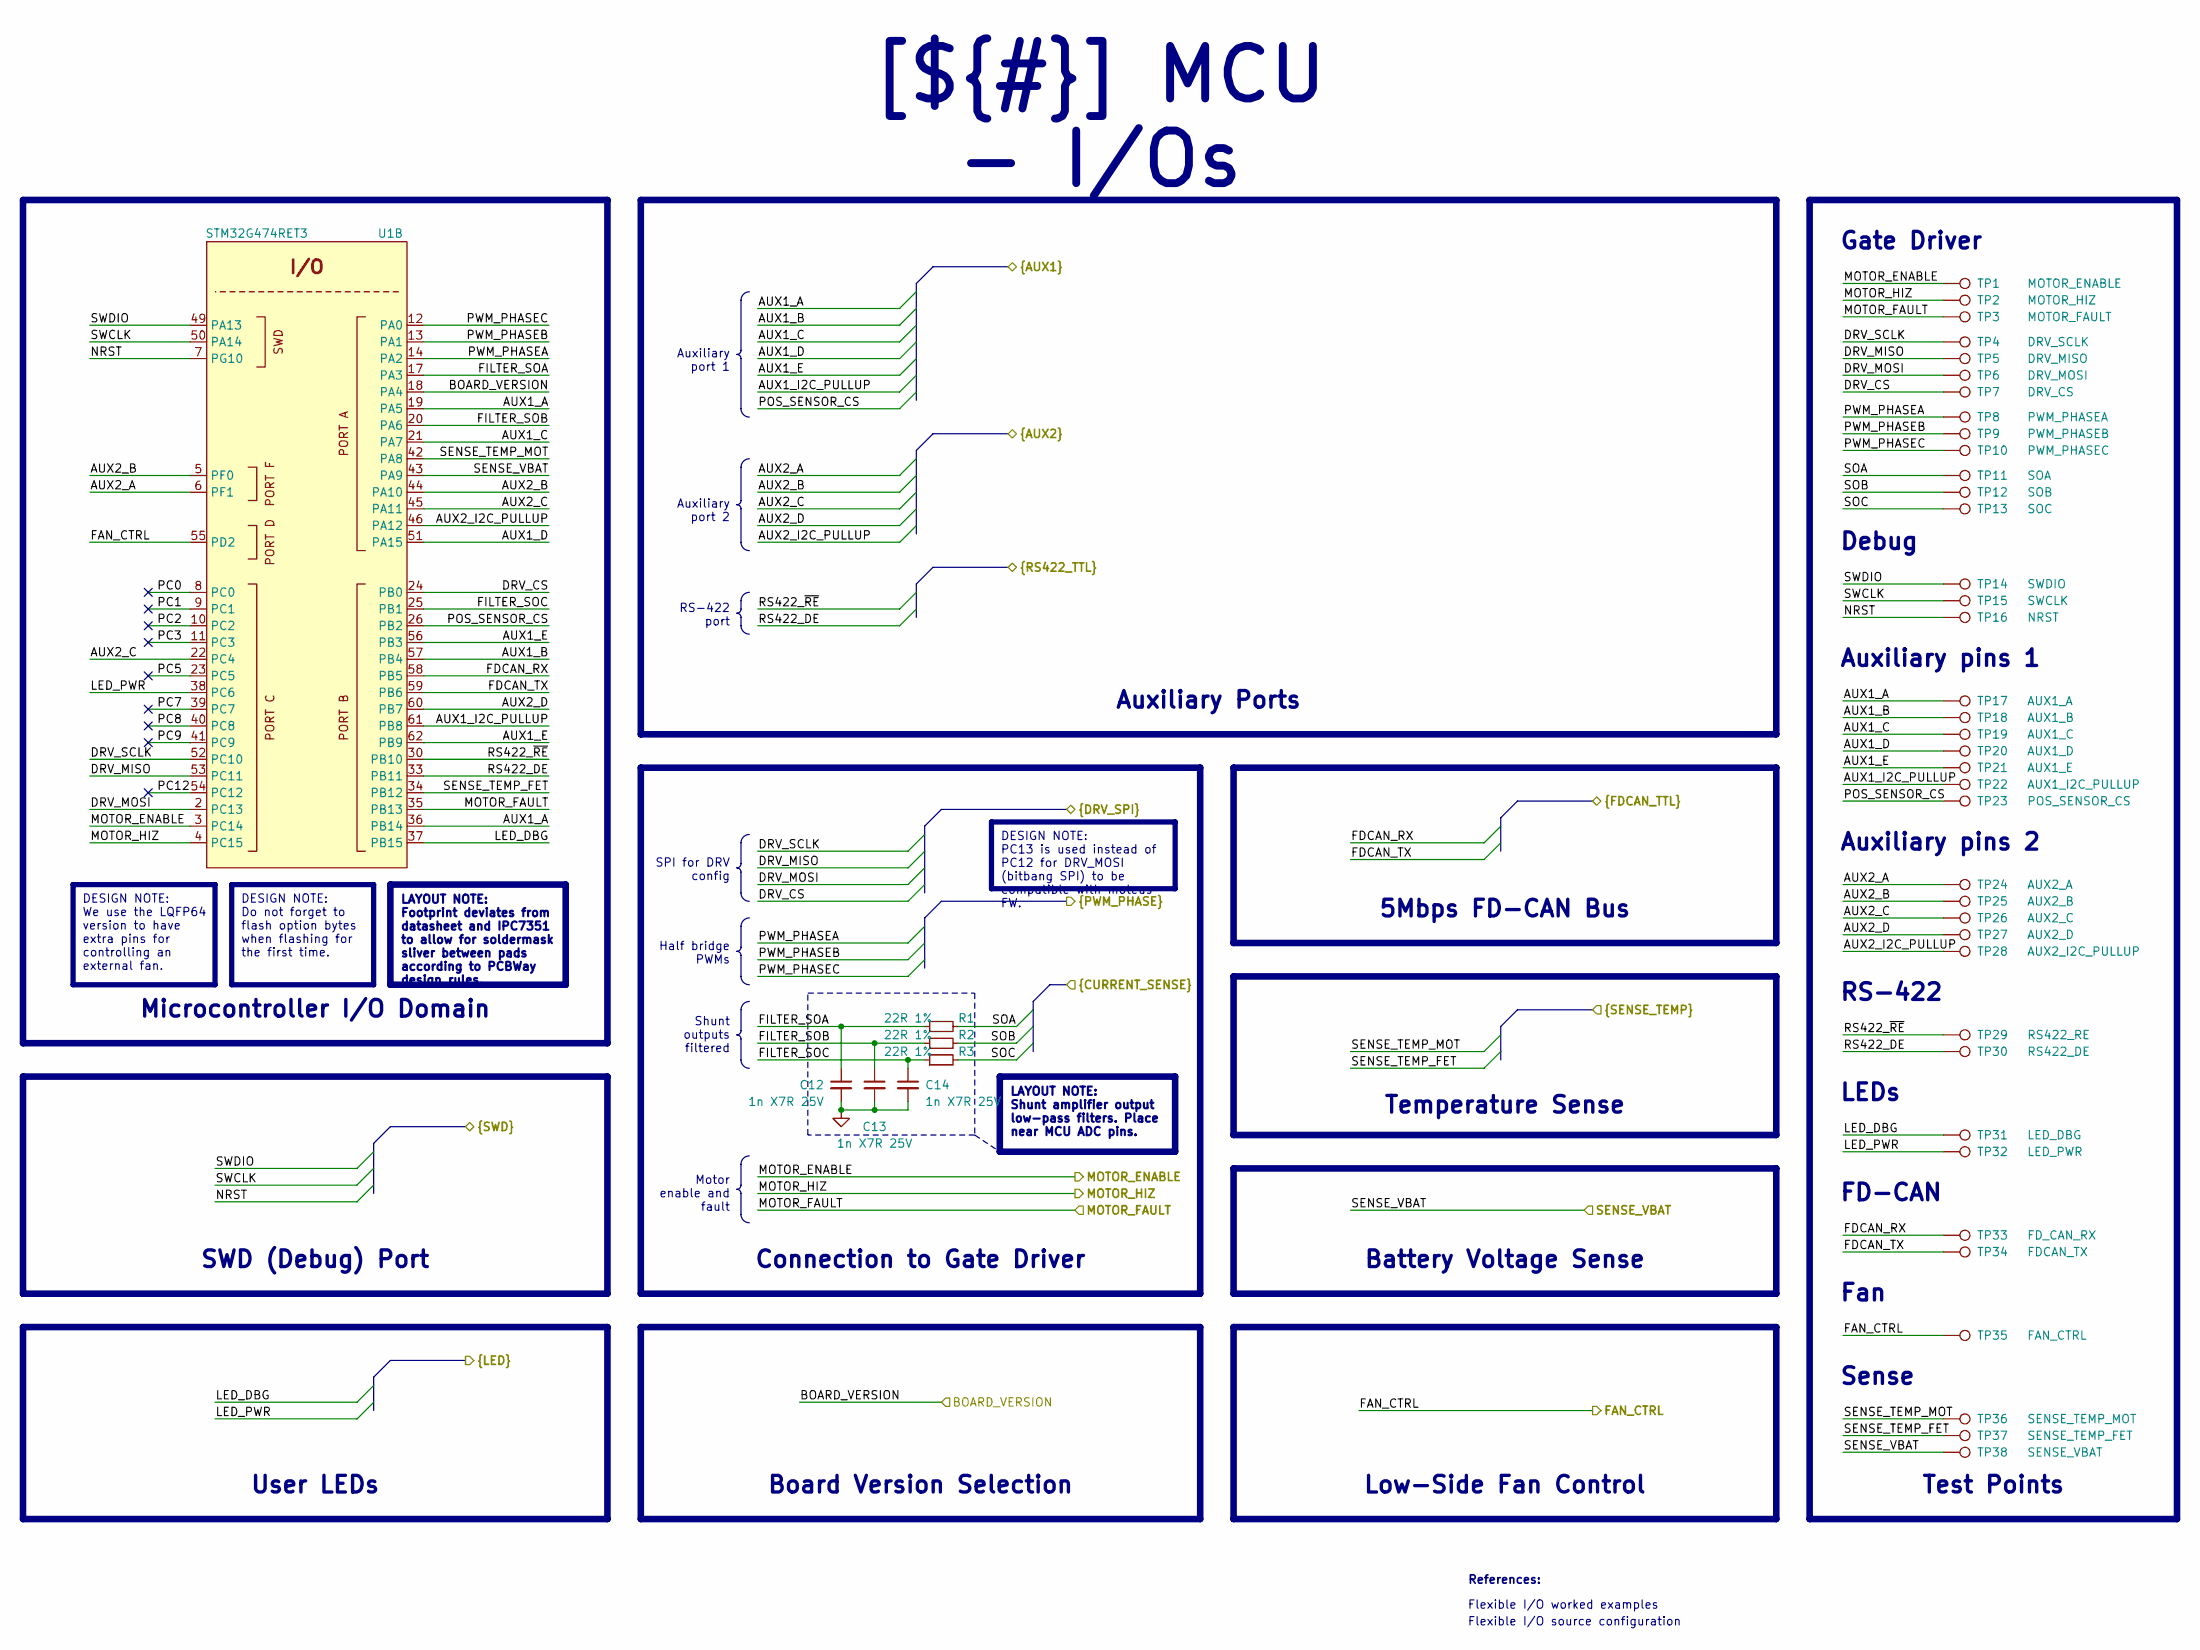
[picture p65: schematic MCU - IOs.kicad_sch, MCU - I/Os]

Parts:
C12, C13, C14: 1n X7R 25V; C_0402_1005_DensityHigh; Manufacturer Part Number AC0402KRX7R8BB102
R1, R2, R3: 22R 1%; R_0402_1005_DensityHigh; Manufacturer Part Number ERJ-2RKF22R0X
TP1: MOTOR_ENABLE; TestPoint_Pad_D0.5mm
TP2: MOTOR_HIZ; TestPoint_Pad_D0.5mm
TP3: MOTOR_FAULT; TestPoint_Pad_D0.5mm
TP4: DRV_SCLK; TestPoint_Pad_D0.5mm
TP5: DRV_MISO; TestPoint_Pad_D0.5mm
TP6: DRV_MOSI; TestPoint_Pad_D0.5mm
TP7: DRV_CS; TestPoint_Pad_D0.5mm
TP8: PWM_PHASEA; TestPoint_Pad_D0.5mm
TP9: PWM_PHASEB; TestPoint_Pad_D0.5mm
TP10: PWM_PHASEC; TestPoint_Pad_D0.5mm
TP11: SOA; TestPoint_Pad_D0.5mm
TP12: SOB; TestPoint_Pad_D0.5mm
TP13: SOC; TestPoint_Pad_D0.5mm
TP14: SWDIO; TestPoint_Pad_D0.5mm
TP15: SWCLK; TestPoint_Pad_D0.5mm
TP16: NRST; TestPoint_Pad_D0.5mm
TP17: AUX1_A; TestPoint_Pad_D0.5mm
TP18: AUX1_B; TestPoint_Pad_D0.5mm
TP19: AUX1_C; TestPoint_Pad_D0.5mm
TP20: AUX1_D; TestPoint_Pad_D0.5mm
TP21: AUX1_E; TestPoint_Pad_D0.5mm
TP22: AUX1_I2C_PULLUP; TestPoint_Pad_D0.5mm
TP23: POS_SENSOR_CS; TestPoint_Pad_D0.5mm
TP24: AUX2_A; TestPoint_Pad_D0.5mm
TP25: AUX2_B; TestPoint_Pad_D0.5mm
TP26: AUX2_C; TestPoint_Pad_D0.5mm
TP27: AUX2_D; TestPoint_Pad_D0.5mm
TP28: AUX2_I2C_PULLUP; TestPoint_Pad_D0.5mm
TP29: RS422_RE; TestPoint_Pad_D0.5mm
TP30: RS422_DE; TestPoint_Pad_D0.5mm
TP31: LED_DBG; TestPoint_Pad_D0.5mm
TP32: LED_PWR; TestPoint_Pad_D0.5mm
TP33: FD_CAN_RX; TestPoint_Pad_D0.5mm
TP34: FDCAN_TX; TestPoint_Pad_D0.5mm
TP35: FAN_CTRL; TestPoint_Pad_D0.5mm
TP36: SENSE_TEMP_MOT; TestPoint_Pad_D0.5mm
TP37: SENSE_TEMP_FET; TestPoint_Pad_D0.5mm
TP38: SENSE_VBAT; TestPoint_Pad_D0.5mm
U1: STM32G474RET3; LQFP-64_10x10mm_P0.5mm; Manufacturer Part Number STM32G474RET3

Connections:
/Project Architecture/Interface - FD-CAN/FDCAN_RX: TP33.1 (1_1), U1.58 (PB5); also elsewhere on the board
/Project Architecture/Interface - FD-CAN/FDCAN_TX: TP34.1 (1_1), U1.59 (PB6); also elsewhere on the board
/Project Architecture/Interface - Interconnects/AUX1_A: TP17.1 (1_1), U1.19 (PA5), U1.36 (PB14); also elsewhere on the board
/Project Architecture/Interface - Interconnects/AUX1_B: TP18.1 (1_1), U1.57 (PB4); also elsewhere on the board
/Project Architecture/Interface - Interconnects/AUX1_C: TP19.1 (1_1), U1.21 (PA7); also elsewhere on the board
/Project Architecture/Interface - Interconnects/AUX1_D: TP20.1 (1_1), U1.51 (PA15); also elsewhere on the board
/Project Architecture/Interface - Interconnects/AUX1_E: TP21.1 (1_1), U1.56 (PB3), U1.62 (PB9); also elsewhere on the board
/Project Architecture/Interface - Interconnects/AUX1_I2C_PULLUP: TP22.1 (1_1), U1.61 (PB8); also elsewhere on the board
/Project Architecture/Interface - Interconnects/AUX2_A: TP24.1 (1_1), U1.6 (PF1); also elsewhere on the board
/Project Architecture/Interface - Interconnects/AUX2_B: TP25.1 (1_1), U1.5 (PF0), U1.44 (PA10); also elsewhere on the board
/Project Architecture/Interface - Interconnects/AUX2_C: TP26.1 (1_1), U1.22 (PC4), U1.45 (PA11); also elsewhere on the board
/Project Architecture/Interface - Interconnects/AUX2_D: TP27.1 (1_1), U1.60 (PB7); also elsewhere on the board
/Project Architecture/Interface - Interconnects/AUX2_I2C_PULLUP: TP28.1 (1_1), U1.46 (PA12); also elsewhere on the board
/Project Architecture/Interface - Interconnects/NRST: TP16.1 (1_1), U1.7 (PG10); also elsewhere on the board
/Project Architecture/Interface - Interconnects/POS_SENSOR_CS: TP23.1 (1_1), U1.26 (PB2); also elsewhere on the board
/Project Architecture/Interface - Interconnects/SWCLK: TP15.1 (1_1), U1.50 (PA14); also elsewhere on the board
/Project Architecture/Interface - Interconnects/SWDIO: TP14.1 (1_1), U1.49 (PA13); also elsewhere on the board
/Project Architecture/Interface - RS-422/RS422_DE: TP30.1 (1_1), U1.33 (PB11); also elsewhere on the board
/Project Architecture/Interface - RS-422/RS422_~RE: TP29.1 (1_1), U1.30 (PB10); also elsewhere on the board
/Project Architecture/MCU - IOs/BOARD_VERSION: U1.18 (PA4); also elsewhere on the board
/Project Architecture/MCU - IOs/DRV_CS: TP7.1 (1_1), U1.24 (PB0); also elsewhere on the board
/Project Architecture/MCU - IOs/DRV_MISO: TP5.1 (1_1), U1.53 (PC11); also elsewhere on the board
/Project Architecture/MCU - IOs/DRV_MOSI: TP6.1 (1_1), U1.2 (PC13); also elsewhere on the board
/Project Architecture/MCU - IOs/DRV_SCLK: TP4.1 (1_1), U1.52 (PC10); also elsewhere on the board
/Project Architecture/MCU - IOs/FAN_CTRL: TP35.1 (1_1), U1.55 (PD2); also elsewhere on the board
/Project Architecture/MCU - IOs/FILTER_SOA: C12.1, R1.1, U1.17 (PA3)
/Project Architecture/MCU - IOs/FILTER_SOB: C13.1, R2.1, U1.20 (PA6)
/Project Architecture/MCU - IOs/FILTER_SOC: C14.1, R3.1, U1.25 (PB1)
/Project Architecture/MCU - IOs/LED_DBG: TP31.1 (1_1), U1.37 (PB15); also elsewhere on the board
/Project Architecture/MCU - IOs/LED_PWR: TP32.1 (1_1), U1.38 (PC6); also elsewhere on the board
/Project Architecture/MCU - IOs/MOTOR_ENABLE: TP1.1 (1_1), U1.3 (PC14); also elsewhere on the board
/Project Architecture/MCU - IOs/MOTOR_FAULT: TP3.1 (1_1), U1.35 (PB13); also elsewhere on the board
/Project Architecture/MCU - IOs/MOTOR_HIZ: TP2.1 (1_1), U1.4 (PC15); also elsewhere on the board
/Project Architecture/MCU - IOs/PC0: U1.8 (PC0)
/Project Architecture/MCU - IOs/PC1: U1.9 (PC1)
/Project Architecture/MCU - IOs/PC2: U1.10 (PC2)
/Project Architecture/MCU - IOs/PC3: U1.11 (PC3)
/Project Architecture/MCU - IOs/PC5: U1.23 (PC5)
/Project Architecture/MCU - IOs/PC7: U1.39 (PC7)
/Project Architecture/MCU - IOs/PC8: U1.40 (PC8)
/Project Architecture/MCU - IOs/PC9: U1.41 (PC9)
/Project Architecture/MCU - IOs/PC12: U1.54 (PC12)
/Project Architecture/MCU - IOs/PWM_PHASEA: TP8.1 (1_1), U1.14 (PA2); also elsewhere on the board
/Project Architecture/MCU - IOs/PWM_PHASEB: TP9.1 (1_1), U1.13 (PA1); also elsewhere on the board
/Project Architecture/MCU - IOs/PWM_PHASEC: TP10.1 (1_1), U1.12 (PA0); also elsewhere on the board
/Project Architecture/MCU - IOs/SENSE_TEMP_FET: TP37.1 (1_1), U1.34 (PB12); also elsewhere on the board
/Project Architecture/MCU - IOs/SENSE_TEMP_MOT: TP36.1 (1_1), U1.42 (PA8); also elsewhere on the board
/Project Architecture/MCU - IOs/SENSE_VBAT: TP38.1 (1_1), U1.43 (PA9); also elsewhere on the board
/Project Architecture/MCU - IOs/SOA: R1.2, TP11.1 (1_1); also elsewhere on the board
/Project Architecture/MCU - IOs/SOB: R2.2, TP12.1 (1_1); also elsewhere on the board
/Project Architecture/MCU - IOs/SOC: R3.2, TP13.1 (1_1); also elsewhere on the board
GND: C12.2, C13.2, C14.2; also elsewhere on the board

Notes on the sheet:
Flexible I/O worked examples
References:
Flexible I/O source configuration
FD-CAN
LEDs
SWD (Debug) Port
Gate Driver
Fan
Sense
DESIGN NOTE: PC13 is used instead of PC12 for DRV_MOSI (bitbang SPI) to be compatible with moteus FW.
LAYOUT NOTE: Shunt amplifier output low-pass filters. Place near MCU ADC pins.
Board Version Selection
RS-422 port
[${#}] ${TITLE}
RS-422
Half bridge PWMs
User LEDs
5Mbps FD-CAN Bus
Shunt outputs filtered
DESIGN NOTE: Do not forget to flash option bytes when flashing for the first time.
Low-Side Fan Control
Motor enable and fault
Debug
LAYOUT NOTE: Footprint deviates from datasheet and IPC7351 to allow for soldermask sliver between pads according to PCBWay design rules.
Auxiliary pins 2
Microcontroller I/O Domain
Auxiliary Ports
Temperature Sense
Battery Voltage Sense
Test Points
DESIGN NOTE: We use the LQFP64 version to have extra pins for controlling an external fan.
Connection to Gate Driver
Auxiliary port 2
Auxiliary port 1
SPI for DRV config
Auxiliary pins 1

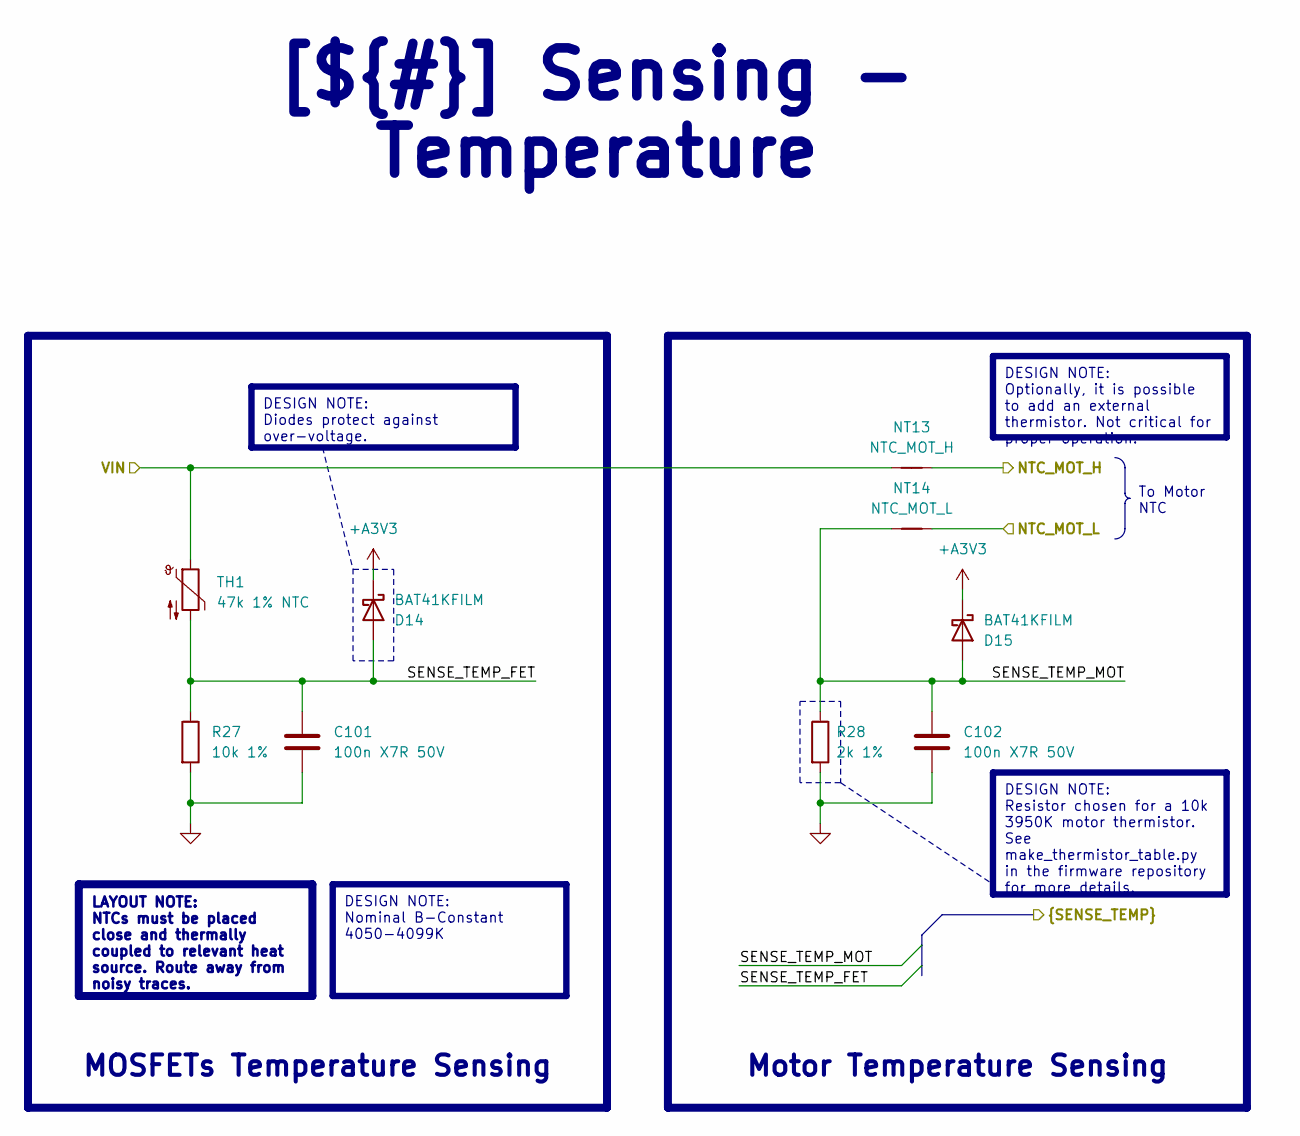
[picture p66: schematic Sensing - Temperature.kicad_sch]

Parts:
C101, C102: 100n X7R 50V; C_0402_1005_DensityHigh; Manufacturer Part Number GCM155R71H104KE02J
D14, D15: BAT41KFILM; D_SOD-523; Manufacturer Part Number BAT41KFILM
NT13: NTC_MOT_H; NetTie-2_SMD_Pad0.2mm
NT14: NTC_MOT_L; NetTie-2_SMD_Pad0.2mm
R27: 10k 1%; R_0402_1005_DensityHigh; Manufacturer Part Number RT0402FRE0710KL
R28: 2k 1%; R_0402_1005_DensityHigh; Manufacturer Part Number ERJ-2RKF2001X
TH1: 47k 1% NTC; R_0402_1005_DensityHigh; Manufacturer Part Number NCP15WB473F03RC

Connections:
+A3V3: D14.1 (K), D15.1 (K), NT13.1, TH1.1; also elsewhere on the board
/Project Architecture/Interface - Interconnects/NTC_MOT_H: NT13.2; also elsewhere on the board
/Project Architecture/Interface - Interconnects/NTC_MOT_L: NT14.2; also elsewhere on the board
/Project Architecture/MCU - IOs/SENSE_TEMP_FET: C101.1, D14.2 (A), R27.1, TH1.2; also elsewhere on the board
/Project Architecture/MCU - IOs/SENSE_TEMP_MOT: C102.1, D15.2 (A), NT14.1, R28.1; also elsewhere on the board
GND: C101.2, C102.2, R27.2, R28.2; also elsewhere on the board

Notes on the sheet:
LAYOUT NOTE: NTCs must be placed close and thermally coupled to relevant heat source. Route away from noisy traces.
MOSFETs Temperature Sensing
Motor Temperature Sensing
[${#}] ${TITLE}
To Motor NTC
DESIGN NOTE: Optionally, it is possible to add an external thermistor. Not critical for proper operation.
DESIGN NOTE: Diodes protect against over-voltage.
DESIGN NOTE: Nominal B-Constant 4050-4099K
DESIGN NOTE: Resistor chosen for a 10k 3950K motor thermistor. See make_thermistor_table.py in the firmware repository for more details.
