RRichard67/amulet_controller_kibot/amulet_controller.kicad_pcb

## KiCad design amulet_controller.kicad_pcb (continued)

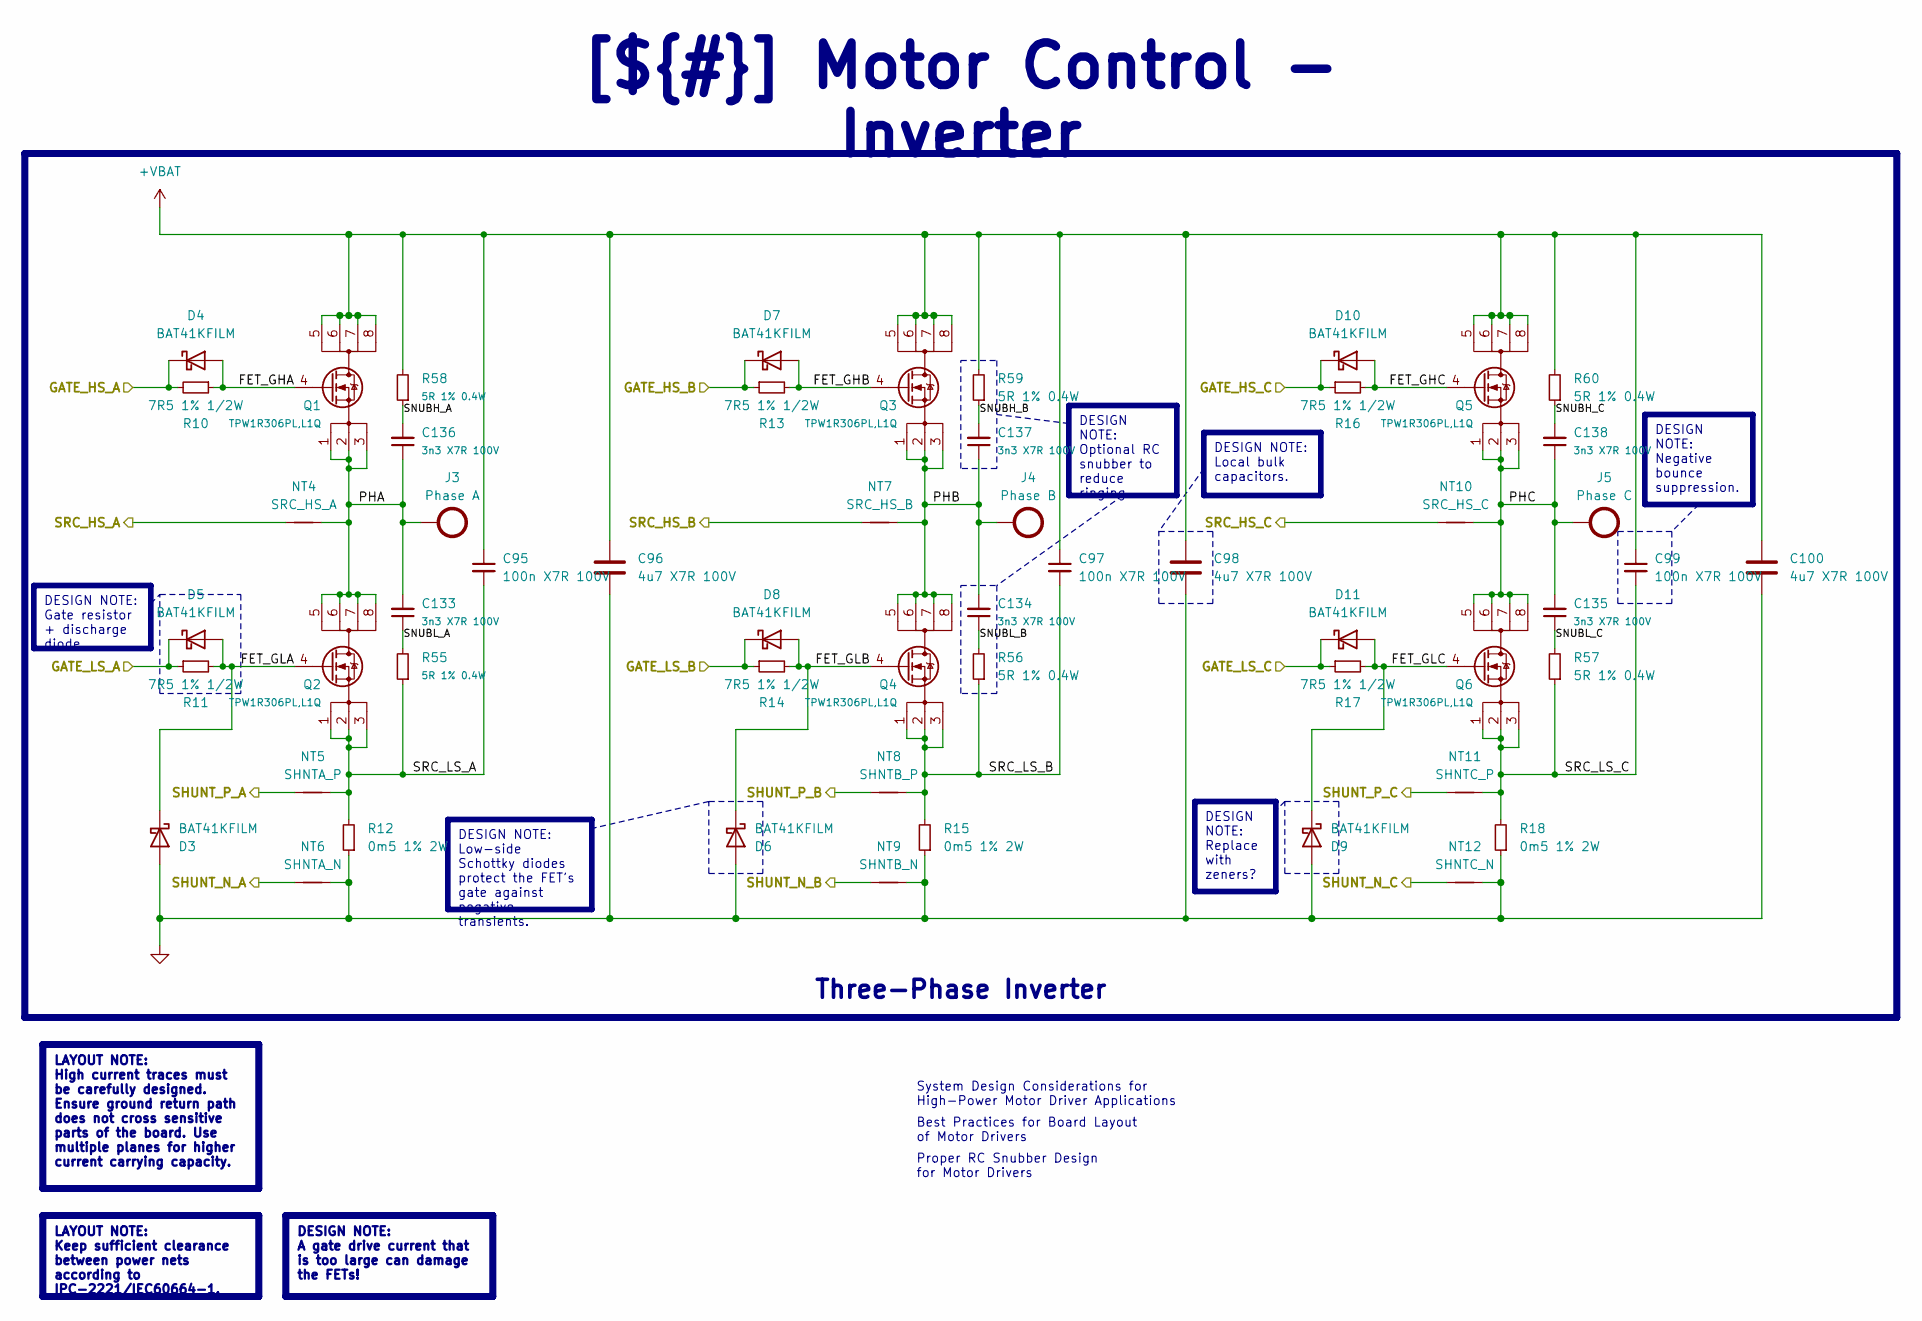
[picture p67: schematic Motor Control - Inverter.kicad_sch]

Parts:
C95, C97, C99: 100n X7R 100V; C_1206_3216_DensityHighest; Manufacturer Part Number C1206C104K1RACAUTO
C96, C98, C100: 4u7 X7R 100V; C_1206_3216_DensityHighest; Manufacturer Part Number GRJ31CZ72A475KE01L
C133, C134, C135, C136, C137, C138: 3n3 X7R 100V; C_0402_1005_DensityHigh; Manufacturer Part Number GRM155R72A332KA01D
D3, D4, D5, D6, D7, D8, D9, D10, D11: BAT41KFILM; D_SOD-523; Manufacturer Part Number BAT41KFILM
J3: Phase A; Pad_Square_Vias_6.5x6.5mm
J4: Phase B; Pad_Square_Vias_6.5x6.5mm
J5: Phase C; Pad_Square_Vias_6.5x6.5mm
NT4: SRC_HS_A; NetTie-2_SMD_Pad0.4mm
NT5: SHNTA_P; NetTie-2_SMD_Pad0.2mm
NT6: SHNTA_N; NetTie-2_SMD_Pad0.2mm
NT7: SRC_HS_B; NetTie-2_SMD_Pad0.3mm
NT8: SHNTB_P; NetTie-2_SMD_Pad0.2mm
NT9: SHNTB_N; NetTie-2_SMD_Pad0.2mm
NT10: SRC_HS_C; NetTie-2_SMD_Pad0.4mm
NT11: SHNTC_P; NetTie-2_SMD_Pad0.2mm
NT12: SHNTC_N; NetTie-2_SMD_Pad0.2mm
Q1, Q2, Q3, Q4, Q5, Q6: TPW1R306PL,L1Q; 2-5S1A; Manufacturer Part Number TPW1R306PL,L1Q
R10, R11, R13, R14, R16, R17: 7R5 1% 1/2W; R_0805_2012_DensityHigh; Manufacturer Part Number CRCW08057R50FKEAHP
R12, R15, R18: 0m5 1% 2W; HCS1206FTL500; Manufacturer Part Number HCS1206FTL500
R55, R56, R57, R58, R59, R60: 5R 1% 0.4W; R_0603_1608_DensityHigh; Manufacturer Part Number CSRT0603FT5R00

Connections:
+VBAT: C95.1, C96.1, C97.1, C98.1, C99.1, C100.1, Q1.5 (D), Q1.6 (D), Q1.7 (D), Q1.8 (D), Q3.5 (D), Q3.6 (D), Q3.7 (D), Q3.8 (D), Q5.5 (D), Q5.6 (D), Q5.7 (D), Q5.8 (D), R58.2, R59.2, R60.2; also elsewhere on the board
/Project Architecture/Motor Control - Top Level/GHA: D4.1 (K), R10.2; also elsewhere on the board
/Project Architecture/Motor Control - Top Level/GHB: D7.1 (K), R13.1; also elsewhere on the board
/Project Architecture/Motor Control - Top Level/GHC: D10.1 (K), R16.1; also elsewhere on the board
/Project Architecture/Motor Control - Top Level/GLA: D5.1 (K), R11.1; also elsewhere on the board
/Project Architecture/Motor Control - Top Level/GLB: D8.1 (K), R14.1; also elsewhere on the board
/Project Architecture/Motor Control - Top Level/GLC: D11.1 (K), R17.1; also elsewhere on the board
/Project Architecture/Motor Control - Top Level/Motor Control - Inverter/FET_GHA: D4.2 (A), Q1.4 (G), R10.1
/Project Architecture/Motor Control - Top Level/Motor Control - Inverter/FET_GHB: D7.2 (A), Q3.4 (G), R13.2
/Project Architecture/Motor Control - Top Level/Motor Control - Inverter/FET_GHC: D10.2 (A), Q5.4 (G), R16.2
/Project Architecture/Motor Control - Top Level/Motor Control - Inverter/FET_GLA: D3.1 (K), D5.2 (A), Q2.4 (G), R11.2
/Project Architecture/Motor Control - Top Level/Motor Control - Inverter/FET_GLB: D6.1 (K), D8.2 (A), Q4.4 (G), R14.2
/Project Architecture/Motor Control - Top Level/Motor Control - Inverter/FET_GLC: D9.1 (K), D11.2 (A), Q6.4 (G), R17.2
/Project Architecture/Motor Control - Top Level/Motor Control - Inverter/PHA: C133.2, C136.1, J3.1 (1_1), NT4.2, Q1.1 (S), Q1.2 (S), Q1.3 (S), Q2.5 (D), Q2.6 (D), Q2.7 (D), Q2.8 (D)
/Project Architecture/Motor Control - Top Level/Motor Control - Inverter/PHB: C134.2, C137.1, J4.1 (1_1), NT7.2, Q3.1 (S), Q3.2 (S), Q3.3 (S), Q4.5 (D), Q4.6 (D), Q4.7 (D), Q4.8 (D)
/Project Architecture/Motor Control - Top Level/Motor Control - Inverter/PHC: C135.2, C138.1, J5.1 (1_1), NT10.2, Q5.1 (S), Q5.2 (S), Q5.3 (S), Q6.5 (D), Q6.6 (D), Q6.7 (D), Q6.8 (D)
/Project Architecture/Motor Control - Top Level/Motor Control - Inverter/SNUBH_A: C136.2, R58.1
/Project Architecture/Motor Control - Top Level/Motor Control - Inverter/SNUBH_B: C137.2, R59.1
/Project Architecture/Motor Control - Top Level/Motor Control - Inverter/SNUBH_C: C138.2, R60.1
/Project Architecture/Motor Control - Top Level/Motor Control - Inverter/SNUBL_A: C133.1, R55.2
/Project Architecture/Motor Control - Top Level/Motor Control - Inverter/SNUBL_B: C134.1, R56.2
/Project Architecture/Motor Control - Top Level/Motor Control - Inverter/SNUBL_C: C135.1, R57.2
/Project Architecture/Motor Control - Top Level/Motor Control - Inverter/SRC_LS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: C95.2, NT5.1, Q2.1 (S), Q2.2 (S), Q2.3 (S), R12.2, R55.1
/Project Architecture/Motor Control - Top Level/Motor Control - Inverter/SRC_LS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: C97.2, NT8.2, Q4.1 (S), Q4.2 (S), Q4.3 (S), R15.2, R56.1
/Project Architecture/Motor Control - Top Level/Motor Control - Inverter/SRC_LS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: C99.2, NT11.2, Q6.1 (S), Q6.2 (S), Q6.3 (S), R18.2, R57.1
/Project Architecture/Motor Control - Top Level/SA_N: NT6.1; also elsewhere on the board
/Project Architecture/Motor Control - Top Level/SA_P: NT5.2; also elsewhere on the board
/Project Architecture/Motor Control - Top Level/SB_N: NT9.1; also elsewhere on the board
/Project Architecture/Motor Control - Top Level/SB_P: NT8.1; also elsewhere on the board
/Project Architecture/Motor Control - Top Level/SC_N: NT12.1; also elsewhere on the board
/Project Architecture/Motor Control - Top Level/SC_P: NT11.1; also elsewhere on the board
/Project Architecture/Motor Control - Top Level/SHA: NT4.1; also elsewhere on the board
/Project Architecture/Motor Control - Top Level/SHB: NT7.1; also elsewhere on the board
/Project Architecture/Motor Control - Top Level/SHC: NT10.1; also elsewhere on the board
GND: C96.2, C98.2, C100.2, D3.2 (A), D6.2 (A), D9.2 (A), NT6.2, NT9.2, NT12.2, R12.1, R15.1, R18.1; also elsewhere on the board

Notes on the sheet:
Best Practices for Board Layout of Motor Drivers
Proper RC Snubber Design for Motor Drivers
System Design Considerations for High-Power Motor Driver Applications
DESIGN NOTE: Negative bounce suppression.
DESIGN NOTE: A gate drive current that is too large can damage the FETs!
DESIGN NOTE: Local bulk capacitors.
[${#}] ${TITLE}
LAYOUT NOTE: High current traces must be carefully designed. Ensure ground return path does not cross sensitive parts of the board. Use multiple planes for higher current carrying capacity.
LAYOUT NOTE: Keep sufficient clearance between power nets according to IPC-2221/IEC60664-1.
Three-Phase Inverter
DESIGN NOTE: Replace with zeners?
DESIGN NOTE: Low-side Schottky diodes protect the FET's gate against negative transients.
DESIGN NOTE: Gate resistor + discharge diode
DESIGN NOTE: Optional RC snubber to reduce ringing.

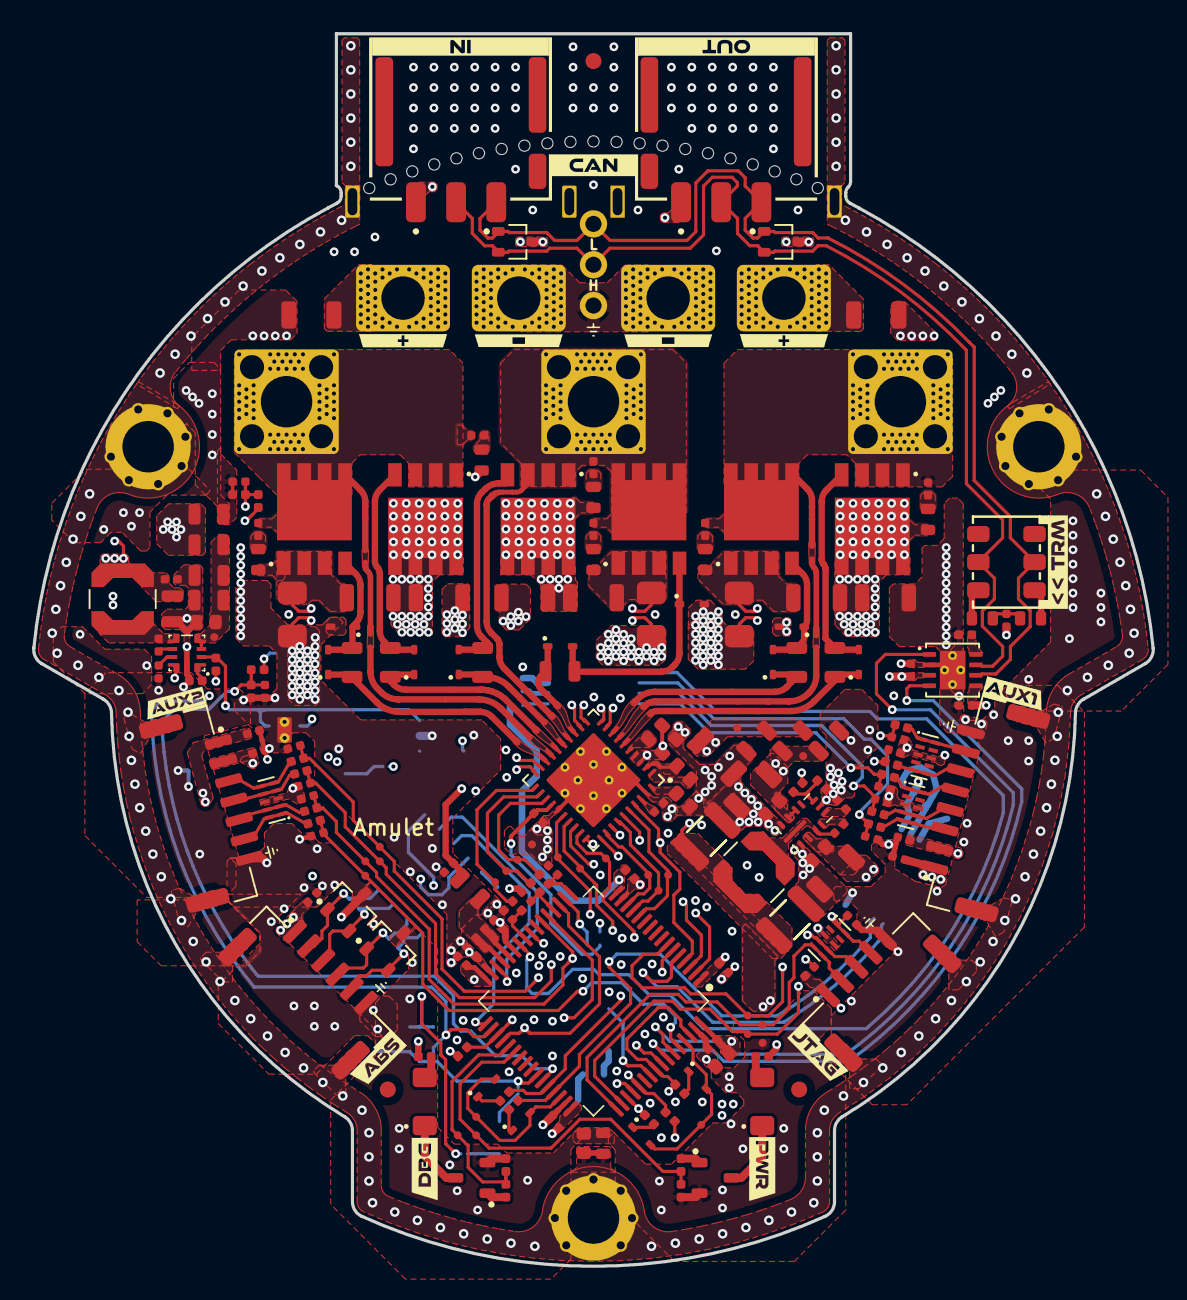
[picture p68: board amulet_controller.kicad_pcb from above]

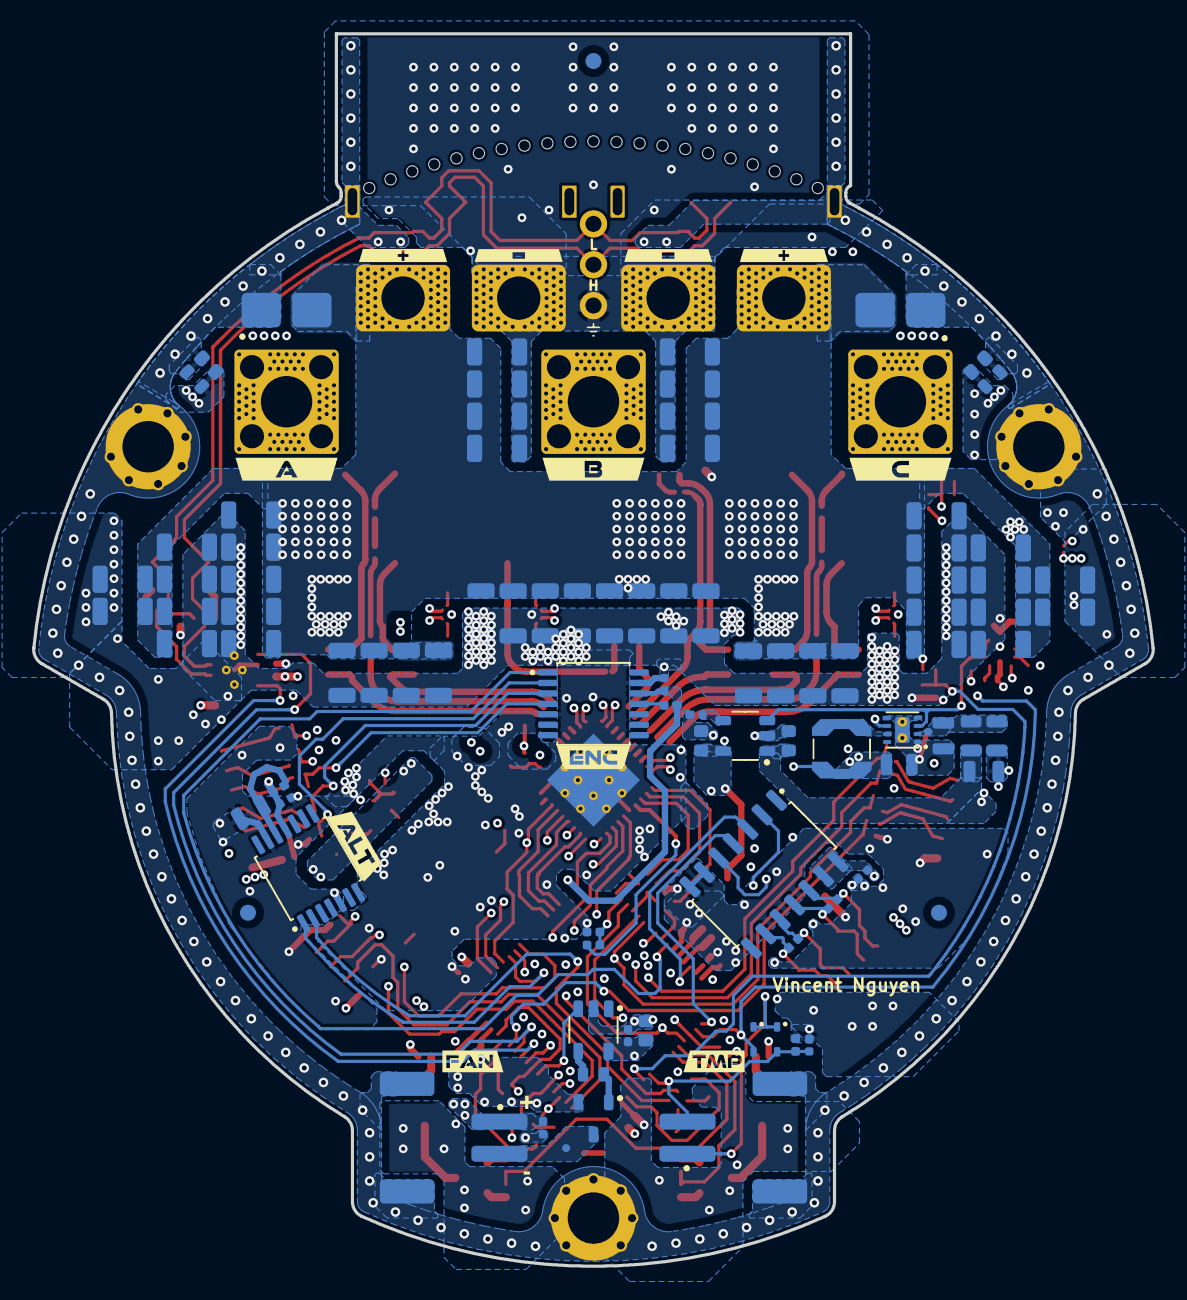
[picture p69: board amulet_controller.kicad_pcb from below]

Board: 6 copper layers, 69.7 x 76.7 mm, 413 parts (120 on the bottom side), 141 nets.

Other parts of the board:
MB1, MB2, MB3, MB4, MB5, MB6, MB7, MB8, MB9, MB10, MB11, MB12, MB13, MB14, MB15, MB16, MB17, MB18, MB19, MB20, MB21: mousebites_single_0.7mm
kibuzzard-657CE6B7: G***; kibuzzard-657CE6B7
kibuzzard-657CE6F4: G***; kibuzzard-657CE6F4
kibuzzard-657CE8E9: G***; kibuzzard-657CE8E9
kibuzzard-657CE8F0: G***; kibuzzard-657CE8F0
kibuzzard-657CE701: G***; kibuzzard-657CE701
kibuzzard-657CE738: G***; kibuzzard-657CE738
kibuzzard-657DB620: G***; kibuzzard-657DB620
kibuzzard-657EBC7A: G***; kibuzzard-657EBC7A
kibuzzard-657EBC30: G***; kibuzzard-657EBC30
kibuzzard-657EBCD6: G***; kibuzzard-657EBCD6
kibuzzard-657EBD3F: G***; kibuzzard-657EBD3F
kibuzzard-657EBDD6: G***; kibuzzard-657EBDD6
kibuzzard-657EBE81: G***; kibuzzard-657EBE81
kibuzzard-657EBEA6: G***; kibuzzard-657EBEA6
kibuzzard-657F78ED, kibuzzard-657F78ED#2, kibuzzard-657F78ED#3, kibuzzard-657F78ED#4: G***; kibuzzard-657F78ED
kibuzzard-657F7953, kibuzzard-657F7953#2, kibuzzard-657F7953#3, kibuzzard-657F7953#4: G***; kibuzzard-657F7953
kibuzzard-65803F12: G***; kibuzzard-65803F12
kibuzzard-658032A4: G***; kibuzzard-658032A4
kibuzzard-6580330B: G***; kibuzzard-6580330B
kibuzzard-65807142: G***; kibuzzard-65807142
kibuzzard-65807156: G***; kibuzzard-65807156
