RRichard67/amulet_controller_kibot/(commit log)

2026-08-16 Kicad 10
    [Block Diagram.kicad_sch, Interface - FD-CAN.kicad_sch, Interface - Fan Control.kicad_sch, Interface - Interconnects.kicad_sch, Interface - RS-422.kicad_sch, MCU - IOs.kicad_sch, MCU - Power.kicad_sch, Misc - Board Version DAC.kicad_sch]
2026-08-16 opened PCB
    [Interface - Fan Control.kicad_sch, MCU - Power.kicad_sch, Misc - Board Version DAC.kicad_sch, Misc - Holes Fiducials.kicad_sch, Motor Control - Inverter.kicad_sch, Motor Control - Top Level.kicad_sch, Power - Connectors.kicad_sch, Power - Generation.kicad_sch]
2026-08-16 Update Outputs
    [amulet_controller-B_Mask.gbr, amulet_controller-B_Paste.gbr, amulet_controller-B_Silkscreen.gbr, amulet_controller-CPL.csv, amulet_controller-Edge_Cuts.gbr, amulet_controller-F_Mask.gbr, amulet_controller-F_Paste.gbr, amulet_controller-F_Silkscreen.gbr]
2026-08-17 See if changing parameters work
    [amulet_controller.kicad_pcb]
2026-08-17 Added myenergi in PCB
    [amulet_controller.kicad_pcb]
2026-08-17 Fix duplicate schematic-file UUID, re-enable iBOM and XLSX BOM
    14 of 21 .kicad_sch files shared the same top-level schematic-file
    UUID (ea8c4f5e-7a49-4faf-a994-dbc85ed86b0a), inherited unchanged
    since the project's first commit. This is the likely trigger for
    KiBot's netlist crash (AttributeError on c.parent_sheet.fname,
    kibot/kicad/v5_sch.py) that forced iBOM to be disabled, matching
    upstream issue INTI-CMNB/KiBot#955. Assigned each affected sheet a
    fresh unique UUID.
    Re-enable the iBOM and XLSX BOM outputs in kibot_main.yaml, both
    previously commented out. Also drop the stale, orphaned
    report_components.csv, whose underlying output config was replaced
    by the still-active csv_comp_count ou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
    [Interface - FD-CAN.kicad_sch, Interface - Interconnects.kicad_sch, Interface - RS-422.kicad_sch, MCU - IOs.kicad_sch, MCU - Power.kicad_sch, Misc - Board Version DAC.kicad_sch, Misc - Holes Fiducials.kicad_sch, Motor Control - Top Level.kicad_sch]
2026-08-17 Revert XLSX BOM re-enable, keep it local-only via --costs
    Per the upstream template docs, KiCost (used by the XLSX BOM output)
    is meant to run locally only, never in CI: it needs API keys in an
    untracked kibot_yaml/kicost_config_local.yaml, and DigiKey's API
    doesn't work in a CI/CD environment anyway. No such config file or
    kicost_yaml/ template exists in this fork, confirming it was never
    set up. Comment @XLSX_BOM_OUTPUT@ back out of the CI-facing bom
    group; the output definition itself stays available for
    ./kibot_launch.sh --costs if API keys are ever configured locally.
2026-08-17 Repoint SW1 footprint to unit 1 to fix iBOM crash
    KiBot's multi-unit component collapse (kicad/v5_sch.py) keeps
    whichever unit is structurally first in the schematic and forces its
    unit number to the minimum. SW1's footprint path referenced unit 2's
    symbol UUID, which no longer matches the collapsed component's own
    path, so KiBot's PCB-to-schematic lookup missed and fell back to a
    reference-only match (the "SW1 not linked..." warning) that hits the
    broken parent_sheet guard in save_netlist_components, crashing the
    iBOM output specifically (upstream KiBot#955).
    Point SW1's footprint path at unit 1's symbol UUID instead, matching
    unit 1's earlier position in the schematic file.
    [amulet_controller.kicad_pcb]
2026-08-17 Give up on iBOM: genuine upstream KiBot bug, not fixable in config
    Root cause fully isolated via direct local reproduction (hooked
    KiBot's own save_netlist call): 48 PCB-only footprints (MB* mounting
    markers, kibuzzard-* auto-generated silkscreen text) have no
    schematic component. out_ibom's variant-processing path needs the
    complete, unfiltered board footprint list to build its temporary
    variant board, bypassing exclude_filter/dnf_filter entirely for that
    list - so these always reach save_netlist_components, which crashes
    on the first one lacking parent_sheet (KiBot's guard for this is
    broken
    Tried and reverted: an exclude_filter targeting MB*/kibuzzard-*
    references - confirmed via local ho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
2026-08-17 Re-enable DXF drill map, add plain XLSX BOM without KiCost
    DXF drill map: was disabled by the original author in favor of PDF-
    only (no bug involved). Re-enabling it alongside the PDF version has
    no known issue - verified locally, produces PTH/NPTH drill map DXFs.
    XLSX BOM: re-enabled with kicost/specs turned off, so it's a plain
    component-list spreadsheet (same data as the CSV/HTML BOM) that needs
    no distributor API keys and runs in CI. Full KiCost pricing stays
    local-only via `kibot_launch.sh --costs`, per the project's own
    README, using kibot_out_xlsx_bom.yaml's KICOST_CONFIG path if the
    user sets up kibot_yaml/kicost_config_local.yaml themselves.
    Verified both locally (KiBot installed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
